GOROman/m5stamp-slic-fxs/DESIGN.md

# M5Stamp 制御 2ポート疑似交換機基板 設計書

**プロジェクト名**: SLIC2PORT-FXS（仮称）
**目的**: FAX機（Canon MX923）と PC の FAXモデム（または2台目の FAX/電話機）を、公衆回線なしで直接 T.30 通信させるためのローカル交換機基板。
**版**: v0.2（2026-10-31、設計フェーズ。発注・製造はしていない）
**v0.2 変更点**: 音声クロス接続を CD4053B から G5V-2 リレー方式へ変更（§5.4）、テストポイントを 34 点に増設（§5.6）、秋葉原調達に合わせた代替反映（1N4007 / BK2125HS601-T、§7）。**配置済み基板データ（v2）は v0.1 設計のものなので、製造前に再生成が必要**

---

## 1. 概要

ユーザーが所有する SLIC モジュール **KS0835F（Shenzhen Ring&tone 製、Silvertel AG1171 系 SLIC 搭載）×4個** のうち2個をソケット搭載し、**M5StampS3（ESP32-S3）** が回線制御を行う 2ポート FXS 基板を設計する。

各ポートは独立した加入者回線として振る舞う:

- 回線電圧（バッテリフィード）の供給
- 呼び出し信号（リング）の送出とリングトリップ検出
- オフフック/オンフック検出（SHK）
- 4W 音声（VX/VR）のアナログクロス接続
- ダイヤルトーン等の可聴信号は M5Stamp 側で生成して注入

ポートAに MX923、ポートBに PC の FAXモデムを RJ11 で挿すだけで、MX923 の「外線発信」がモデム側を呼び出し、応答後は T.30 ハンドシェイク（CNG/CED〜V.17/V.29/V.34）がそのまま通る。逆方向（モデムの ATD 発信 → MX923 自動受信）も対称に動作する。

### 1.1 ブロック図

```
                         +5V (USB-C / 端子台, 5V/3A想定)
                           │
              ┌────────────┴────────────┐ リバース保護(P-FET)+ポリヒューズ+TVS
              │
        ┌─────┴───────────────────────────────────────────┐
        │                  本基板                          │
        │                                                  │
 RJ11-A │  保護回路   ┌──────────┐   音声クロス接続        │
 ───────┼──(P3100SC,  │ KS0835F  │   ┌───────────────┐    │
  TIP/  │   ブリッジ+  │  MOD_A   │   │  G5V-2       │    │
  RING  │   82Vツェナ, └──┬───┬──┘   │  リレー x2     │    │
        │   27K CLI)      │   │ VX_A─┼──►(相手VR/ﾄｰﾝ選択) │    │
        │                 │   └─VR_A─┼──◄(相手VX or ﾄｰﾝ)   │    │
        │              SHK_A F/R_A RM_A│               │    │
        │                 │   │   │  └──────┬────────┘    │
        │   ┌─────────────┴───┴───┴───────┴───────┐     │
        │   │  74HCT244 レベル変換 (3.3V→5V系)     │     │
        │   │  SHKは抵抗分圧で 5V→3.3V            │     │
        │   └──────────────┬──────────────────────┘     │
        │   ┌──────────────┴──────────────────────┐     │
        │   │  M5StampS3 (ESP32-S3)               │     │
        │   │  ・状態機械（発信/呼出/接続/解放）    │     │
        │   │  ・ADC×2: 音声モニタ + DTMF (Goertzel)│     │
        │   │  ・LEDC PWM 400Hz → RC → トーンバス  │     │
        │   └──────────────┬──────────────────────┘     │
        │   （ポートB側も対称に同一構成）              │
 RJ11-B │  保護回路   ┌──────────┐                       │
 ───────┼──(同上)     │ KS0835F  │                       │
        │             │  MOD_B   │                       │
        │             └──────────┘                       │
        └────────────────────────────────────────────────┘
```

### 1.2 設計上の要点（先に結論）

1. **モジュール電源は +5V** とし、ロジックレベル変換を入れる。理由: AG1171 系は +5V 給電時、制御入力 F/R・RM の VIH = 3.5V で ESP32 の 3.3V 出力では不足し、SHK 出力は VOH ≈ 4.5V で ESP32 に直接入れられない（データシート DC 特性より）。→ 出力側は 74HCT244（HCT 入力は VIH=2.0V で 3.3V CMOS を受け、5V フルスイング出力）、入力側（SHK）は抵抗分圧で受ける。
2. **音声は常時ハードワイヤせず、小型信号リレー（Omron G5V-2）で「相手の VX」か「トーンバス」かをポート毎に切替える**。これにより発信直後のダイヤルトーン送出と、接続後のクロス接続を両立する。通話路をリレー接点で切り替える方式は秋月電子の簡易擬似電話交換機キット（リレー＋トランジスタドライバで通話路・極性反転・ベル挿入を切替）と同じ考え方で、当初案の CD4053B アナログ MUX から変更した（v0.2）。接点は無電源時 NC=クロス接続になるフェイルセーフ構成で、ON 抵抗・レベルシフト・バイアス電流の心配もない。
3. **保護回路は KS0835F データシートの Typical Connection Diagram をそのまま採用**（P3100SC + 1N4004 ブリッジ + BZT03C82 + CLI 用 27K）。独自回路にしない。
4. **公衆回線（PSTN/NTT 回線）には絶対に接続しない**。本基板は閉じたローカル回線専用。

---

## 2. 参考資料（出典と、何を参考にしたか）

| # | 資料 | URL / 入手元 | 参考にした内容 |
|---|---|---|---|
| R1 | Silvertel **Ag1171 データシート V1.6**（2011-10） | Mouser 配信 PDF（本フォルダ `research/Ag1171-datasheet.pdf` に保存） | ピン機能、リング生成方法（RM=H + F/R を 20–25Hz トグル）、SHK デバウンス 10ms、PD の扱い（L でパワーダウン、**H にしてはいけない**、未使用時はオープン）、保護回路の部品表（D1=BZT03C82/P6KE82、D2–D5=1N4004 or MB4S ブリッジ、D6=1N4148）、利得 0dB±0.75、ロジックレベル（VIH/VOH）、電源電流、レイアウト指針（±EMI 用 1–10nF、太い電源配線） |
| R2 | Shenzhen Ring&tone **KS0835F データシート V1.3**（2012-09） | GitHub `diggydude/php-pbx` の `docs/KS0835F.pdf`（本フォルダ `research/` に保存） | **モジュール側コネクタのピン配置（11ピン）**、Typical Connection Diagram（保護回路・C2/C3=0.1µF・C5=470µF/10V・PD の 1N4004）、外形/PCB Decal（ピン配置は2クラスタ構成・ドリル 0.9mm）、電気特性（利得 0dB、リング 120–135Vp-p、電源電流） |
| R3 | **diggydude/php-pbx**（GitHub） | https://github.com/diggydude/php-pbx | KS0835F ×8 で電話交換機を作った実在の先行事例。アーキテクチャ（SLIC + アナログスイッチマトリクス MT8808 + トーン生成 + マイコン群で状態管理）、**1回線あたり P3100EBL ×1 + P6KE82 ×1 の保護部品実績**、部品リスト（`docs/requirements.txt`）、動作原理（`docs/principle_of_operation.txt`） |
| R4 | **Blue POT**（Hackaday.io プロジェクト） "A FXS with a SLIC and other historical things" | https://hackaday.io/project/166359-blue-pot/log/165359-a-fxs-with-a-slic-and-other-historical-things | AG1171 で FXS を作った個人プロジェクト。データシート推奨の ESD/EMI 保護を実装した実績、82V ツェナレールへのシャント構成の考え方 |
| R5 | M5Stack 公式ドキュメント **Stamp-S3A PIN2.54** / **Stamp-S3A** | https://docs.m5stack.com/en/core/Stamp-S3A_PIN254 , https://docs.m5stack.com/en/core/Stamp-S3A | M5StampS3A の仕様（ESP32-S3FN8、23 GPIO 一覧、26.0×18.0mm、入力 5V、G0/G46 はストラップピンで注意） |
| R6 | M5Stack 公式 **M5_Hardware**（GitHub）KiCad ライブラリ | https://github.com/m5stack/M5_Hardware （`KiCad/Symbols/M5Stack_Symbols.kicad_sym`、`KiCad/Footprints/M5Stack.pretty/Stamp-S3-SMD.kicad_mod` 等） | M5STAMPS3 シンボルのピン番号↔GPIO 対応表（§5.1）、公式フットプリント（本プロジェクトの `kicad/` に出典明記で同梱） |
| R7 | M5Stack 公式 **Stamp-S3 BreakOut**（SKU:A129） | https://docs.m5stack.com/ja/stamp/Stamp-S3_BreakOut | キャリア基板に EN/G0 のタクトスイッチを置く作法（本基板の RST/BOOT スイッチ配置の参考） |

> 注: R2 の KS0835F データシートはメーカー（R-Tone）公式サイトではなく GitHub 上の保存コピーが入手経路。内容は R1（AG1171）と整合する範囲で採用し、モジュール固有の事項（ピン配置・外形）は R2 を優先した。食い違う場合は実物確認（§10）を正とする。

---

## 3. 前提・仮定と未確定事項

### 3.1 確定として扱う事項（出典あり）

- KS0835F モジュールのインターフェースは **11ピン**（R2 ピン表）:
  1=RING, 2=TIP, 3=F/R, 4=RM, 5=SHK, 6=VR（音声入力）, 7=VX（音声出力）, 8=NC, 9=GND, 10=+VDC, 11=PD。
  ※ 素子単体の AG1171 は 14ピン SIL でピン配置が**異なる**（1=RING, 2=TIP, 3=F/R, 4=RM, 5=SHK, 9=VIN, 10=VOUT, 12=GNDPWR, 13=+VPWR, 14=PD）。**本基板のソケットはモジュール（KS0835F）の 11ピン仕様**であり、AG1171 素子を直接挿すことはできない。
- 音声利得は標準品 KS0835F で **2W→VX 0dB / VR→2W 0dB**（R2 Product Selector）。
- リングは RM=H にして F/R を 20–25Hz でトグル（R1 §3.3 / R2 §1）。リング電圧 120–135Vp-p、呼出中バッテリ 75V。
- SHK はオフフックで H。デバウンス 10ms 必須（R1/R2）。
- PD は L でパワーダウン、**H にすると破損の恐れ**。未使用時はオープン。使う場合はダイオード経由で引き下げる（R1 §3.4、R2 接続図の D7=1N4004）。
- M5StampS3/S3A の GPIO 一覧と公式シンボルのピン対応（R5/R6）。

### 3.2 仮定（実物確認が必要な事項）

| # | 仮定 | 根拠 | 確認方法 |
|---|---|---|---|
| A1 | ユーザー所有の4個は標準品 **KS0835F**（利得 0dB/0dB）である | AliExpress 購入品のマーキング未確認。バリエーションに KS0835F-2（−6dB/+1dB）、-V5（5V専用・低電流）がある（R2） | モジュール表面のマーキングを読む（§10-1）。-2 だった場合: クロス接続のループ利得が −5dB になるが FAX は許容範囲。必要なら §7.4 のパッド抵抗で補正 |
| A2 | モジュールのピン列は **2クラスタ（ピン1–5 と 6–11、クラスタ間ギャップ大）**、ドリル 0.9mm、ピンピッチ 2.54mm | R2 の Package Size / PCB Decal 図。図面数値: 全長 50.2mm、ピン1は右端から 1.5mm、Decal 全長 51.5mm・幅 6.6mm・穴列は端から 2.0mm | 製造前にノギスでピン5–6間距離とピン1位置を実測し、フットプリントのパラメータ `GAP56` を合わせる（§10-2） |
| A3 | モジュールは基板に**垂直に立つ**（SIL 的）実装で、占有ストリップは約 51.5×6.6mm、高さは基板面から約 13–20mm | R2 外形図（側面図でピンが L 字に曲がり、本体が立つ形状） | 実物で高さ・倒れ方向を確認（§10-2） |
| A4 | KS0835F のロジックレベルは AG1171 と同等（5V 給電時 VIH=3.5V、SHK VOH≈4.5V） | R2 にはロジックレベルの明記なし。同一ファミリとして R1 の値で設計（安全側: レベル変換を入れる設計は 3.3V ロジック前提でも壊れない） | 実物で SHK の H レベル電圧を測定（§10-3） |
| A5 | M5StampS3A（現行・S007-V033 系）は Stamp-S3 と同一外形・同一ピン配置で、公式 SMD フットプリントが共用できる | R5 の S3A 製品サイズ 26.0×18.0mm は S3 と同一。M5Stack の S3A ドキュメントの PCB リンクも M5_Hardware の Stamp-S3 系フットプリントを指す | 製造前に S3A の Model Size PDF と実物で端子位置を確認（§10-4） |
| A6 | FAX モデム側は自動応答（例: AT S0=1〜2）設定ができる一般的なアナログ FAX モデム | 一般的な USB/PCI FAX モデムの前提 | 実機接続時に設定確認 |

---

## 4. 電源設計

### 4.1 電源ツリー

```
USB-C (5V) ──┐
             ├─► VIN_RAW ─► F1 ポリヒューズ(2A) ─► Q1 P-FET(逆接保護) ─► +5V
端子台 (5V) ──┘                                                        │
                                          ┌────────────────────────────┼──────────────────┐
                                          │                            │                  │
                                    U1 M5StampS3                 FB_A 経由 +5V_PA    FB_B 経由 +5V_PB
                                    (pin13)                    (MOD_A pin10)        (MOD_B pin10)
                                          │                     各ポート: 470µF/10V + 100nF をモジュール直近に
                                    U1 pin28 の 3.3V ─► +3V3 (軽負荷のみ: ADCバイアス分圧・拡張ヘッダ)
                                    +5V ─分圧(4.7K/4.7K)─► VAUD = 約2.5V (音声バイアス基準, 10µF+100nF)
                                    +3V3 ─分圧(47K/47K)─► VREF165 = 約1.65V (ADCタップのバイアス)
```

- 入力は **5V/3A クラスの AC アダプタ**想定。USB-C は電源専用（CC1/CC2 に 5.1K プルダウンを付け、USB-C 電源から 5V を引く）。端子台（KF301 2P）と並列入力とし、**同時給電は禁止**（どちらか一方。ダイオード OR はしない: 電圧降下と発熱を避けるため）。
- 逆接保護: P-ch MOSFET（AO3401A、D=ヒューズ後の入力、S=保護後の +5V、ゲート 100K で GND プルダウン）によるハイサイド保護。ダイオード方式の 0.3V 降下を避ける（M5Stamp の 5V 入力マージン確保）。
- TVS（SMBJ5.0A）を +5V 入力直後に配置。**SMBJ5.0A は高速サージ用で、モジュール上限以下に抑える過電圧保護ではない**（ブレークダウンは約 6.4V で、5.5V 超過そのものはクランプしない）。絶対最大定格は Ag1171（R1）が VCC 7.0V だが、**KS0835F データシートの絶対最大表は VCC 5.5V** であり、本基板のモジュール上限は 5.5V とする。安定化 5V のみを前提とし、5.5V を超える無調整電源の直結は厳禁であることも基板シルクに明記する。（数値は PR #2 の訂正を取り込み）
- 入力バルク: 1000µF/10V + 100nF。
- ポート毎にフェライトビーズで分岐（DC/DC コンバータのスイッチングノイズのポート間・ロジック側への回り込み防止）。モジュール直近に 470µF/10V（R2 接続図 C5）+ 100nF（同 C4）。
- GND は入力部を起点とするスター接続とし、モジュール pin9（DC/DC グラウンド）は太く短く入力側へ戻す。音声系 GND はロジック GND と同電位（単一 GND プレーン、ただしレイアウトで帰路を分離。§9 参照）。

### 4.2 電源バジェット（+5V 給電時、R2 の最大値で見積り）

| 負荷 | オンフック | オフフック（通話） | リング送出中 | 備考 |
|---|---|---|---|---|
| KS0835F ×1 | 50 mA | 320 mA | 220 mA | R2 DC特性の最大側。標準品（非 -V5）想定 |
| 〃 ×2 同時 | 100 mA | 640 mA | — | 両ポート通話時が持续最大 |
| 片ポート リング + 片ポート通話 | — | — | 220 + 320 = 540 mA | 呼出フェーズ |
| M5StampS3 | — | 160 mA typ / 600 mA peak | — | Wi-Fi 送信ピークを含む概算 |
| 74HCT244 + LED 等 | — | 35 mA | — | §5.7 のステータス LED ×6（約2mA/点）を含む |
| 音声リレー K1/K2 コイル | 0 | 100 mA/個（励磁時） | 最大 200 mA（両励磁時） | G5V-2 DC5 コイル 50Ω。トーン送出中のみ励磁 |
| **合計（設計値）** | 約 0.3 A | **約 1.3 A** | 約 1.2 A | → **5V/3A アダプタ、ヒューズ 2A ホールド** |

リングトリップ瞬間など短時間ピークは各ポートの 470µF と入力バルクで吸収する。

### 4.3 ロジックレベル変換（重要）

AG1171 系を +5V で使う場合の不整合（R1 DC特性）:

| 信号 | SLIC 側（5V給電） | ESP32-S3 側 | 対策 |
|---|---|---|---|
| F/R, RM 入力 | VIH = 3.5V min | VOH = 3.3V max → **不足** | 74HCT244 経由で 5V フルスイング駆動 |
| SHK 出力 | VOH ≈ 4.5V | VIN max 3.6V → **過電圧** | 10K/18K 分圧（5.0V→3.21V、4.5V→2.89V）+ 1nF |
| PD 入力 | H 禁止 / オープン or L | — | 1N4004 経由でのみ引き下げ（§5.3） |
| リレードライバ (2N7002) ゲート | Vgs(th) max 2.5V、駆動は 5V フルスイング要 | 同上 | SEL 信号も 74HCT244 経由で 5V 化してからゲートへ |

代替案として「モジュールを +3.3V 給電にする」方法もある（VIH=2.0V、SHK VOH=2.8V で直接接続可）。しかし (1) オフフック電流が増える（〜320mA@3.3V/ポート相当の電力増）、(2) 大電流 3.3V レールを別途用意する必要がある、(3) php-pbx の実績が +5V 運用、の3点から不採用とした。

---

## 5. ポート回路（ポートA/B 共通 ×2）

記法: `x` はポート記号 A/B。信号名は SKiDL ソース（`kicad/skidl/m5stamp_slic2port.py`）のネット名と一致させてある。

### 5.1 回線側（RJ11 〜 モジュール TIP/RING）

| ネット | 接続 |
|---|---|
| `TIP_x` | RJ11 pin4 ←→ KS0835F pin2 (TIP)。直結（保護素子はすべてシャント接続） |
| `RING_x` | RJ11 pin3 ←→ KS0835F pin1 (RING)。直結 |
| （RJ11 pin1,2,5,6） | NC。6P6C ジャックを使用し中央ペア（3,4）のみ使用。日本の 6極2芯コードも中央ペアなのでそのまま挿せる |

> RJ11 のピン対応（pin3=RING 側、pin4=TIP 側）は R2 の Typical Connection Diagram の配線（モジュール pin1→J1-3、pin2→J1-4）に倣った。
>
> **RJ11 ジャックの正式決定（2026-10-31, 基板 v3.4.2）**: ジャックは **秋月電子 100954（Neltron 7002-6P6C、サイドエントリ基板用、¥50）** を指定部品とする。フットプリントはメーカー図面 `research/neltron-7002-XPXC.pdf`（秋月商品ページ掲載の Neltron 公式図面、SHA-256 90992b2a…060079）で是正した。図面寸法: 端子は **千鳥2列**（接点ピッチ 1.02mm TYP、列間隔 2.54mm）、推奨穴径 **ø0.90**、位置決めペグ **ø2.30 ×2（ピッチ 12.00mm = Dim.C）**、開口面から ペグ中心 6.00mm / 近列（pin2,4,6）8.10mm / 遠列（pin1,3,5）10.64mm、本体 幅12.20（フランジ付きは Dim.D 14.20）× 奥行15.00 × 高さ14.35±0.25mm。pin1 は下面図の "Pin 1" 指示により **遠列**（開口から遠い列）。従来の単列1.27mmピッチ前提（Issue #6 の仕様）は本決定で置き換える。実物での最終確認（秋月 100954 現物または同型サンプルでの嵌合確認）は未実施で、発注前の残件とする。FAX/モデムの DAA は通常極性不感だが、着信時の極性反転検出を使う機器のためにもこの対応を守る。モジュールの F/R=H（Forward）で RING 側が TIP に対して負電位になる（R1/R2）。

保護・付随回路（すべて R1/R2 の指定部品・構成）:

| 部品 | 値/型番 | 接続 | 役割 |
|---|---|---|---|
| D_THY_x | P3100SC（Littelfuse 表記では SMC）または P3100EBL（TO-92） | TIP_x 〜 RING_x 間 | 差動サージのクローバー。P3100 の VDRM は 275V、ブレークオーバ VS は 350V（「約155V」ではない）。リング 135Vp-p では動作しない。82V ツェナの方が先にクランプするので、350V 未満のサージはツェナ側が受け持つ。部品番号は R2 接続図の指定のまま |
| BR_x | 1N4004 ×4（または MB4S ブリッジ） | AC 端子 = TIP_x/RING_x、+側レール = BRP_x、−側 = GND 直結 | サージを極性無関係にクランプ側へ誘導（データシート図の GND 基準構成） |
| D_Z_x | BZT03C82 または P6KE82 | カソード = BRP_x、アノード = GND | 回線の正サージを BRP レール経由で対 GND 約 +82V にクランプ。負サージはブリッジ −側 (アノード = GND) 経由で約 −0.7V にクランプ (R1 Fig.4 / R2 接続図の GND 基準構成そのまま)。通常動作では導通しない |
| R_CLI_x | 27K（指定範囲 20K–39K） | TIP_x 〜 RING_x 間 | オンフック時の DC 経路（CLI/オンフック伝送用、R1 §3.10 / R2 接続図 R1） |
| C_EMI_x1/x2 | 10nF / 250V（フィルム） | TIP_x→GND、RING_x→GND | DC/DC ノイズの EMI 抑制（R1 §6/図5、1–10nF）。※回線の対 GND 範囲は通常時 0〜+75V・差動最大 135Vp-p で、250V 耐圧はサージ/差動マージンとして確保する (旧文書の「対 GND −113V ピーク」は負電源前提の誤りで、メーカー保護回路の GND 基準クランプ (+82V/−0.7V) と矛盾するため v3.4.1 で訂正) |

### 5.2 モジュール制御・電源

| モジュール pin | ネット | 接続先 |
|---|---|---|
| 3 F/R | `FR_x_5V` | 74HCT244 出力。アイドル = H（Forward）。リング中は 20Hz トグル |
| 4 RM | `RM_x_5V` | 74HCT244 出力。リングバースト中のみ H |
| 5 SHK | `SHK_x_RAW` | 分圧（10K 直列 + 18K プルダウン + 1nF）→ `SHK_x_33` → ESP GPIO |
| 9 GND | GND | スターグラウンドへ太く |
| 10 +VDC | `+5V_Px` | フェライトビーズ経由 +5V。直近に 470µF/10V + 100nF |
| 11 PD | `PD_x` | §5.3 |
| 8 NC | — | 無接続（基板側も孤立パッドのみ） |

### 5.3 PD の扱い

- デフォルトは**オープン**（モジュール常時起動）。PD ノードは「敏感なノード・配線は短く」（R1）。
- 任意で引き下げられるよう: `PD_x` → 1N4004（アノード = モジュール側、カソード = 共通 `PD_BUS`）→ 2N7002（ドレイン = PD_BUS、ソース = GND、ゲート = GPIO15 `PD_EN` + 100K プルダウン）。
- ダイオードがあるため、PD_BUS 側が何をしてもモジュール PD ピンに H が印加されることはない（R1 の指定どおり）。
- パワーダウン運用時は SHK が無効になるため、復帰検出には 50ms 起動を伴うポーリングが必要（R1 §3.4）。v1 ファームウェアでは PD は使わない（常時 ON）。回路だけ用意する。

### 5.4 音声系（4W クロス接続 + トーン注入 + モニタ）

| ノード | 接続・定数 |
|---|---|
| `VX_x_PIN` | モジュール pin7 (VX)。C_VX_x = 100nF（R2 接続図 C3）経由で `VX_x_AUD` へ |
| `VX_x_AUD` | 100K で VAUD（2.5V）へバイアス。→ リレーの相手側 NC 接点へ。→ ADC タップへ |
| ADC タップ | `VX_x_AUD` → 100nF → `MON_x`（100K で VREF165=1.65V へバイアス、直列 10K 保護、1nF RF 除去）→ ESP ADC1 |
| `VR_x_IN` | リレー COM 出力。100K で VAUD へバイアス。C_VR_x = 100nF（R2 接続図 C2）経由でモジュール pin6 (VR) へ |
| トーンバス `TONE_BUS` | §5.5。両リレーの NO 接点へ共通接続。100K で VAUD バイアス。RC 出力との間に 100nF を直列に入れて DC を遮断 |

音声クロス接続リレーの割当て（K1/K2、Omron G5V-2 DC5、DPDT。端子番号はデータシート bottom view 準拠: コイル 1/16、極1 COM=4/NC=6/NO=8、極2 COM=13/NC=11/NO=9）:

| リレー | NC（SEL=L、無励磁） | NO（SEL=H、励磁） | COM | 駆動 |
|---|---|---|-----|---|
| K1（ポートA 用） | `VX_B_IN` | `TONE_BUS` | `VR_A_IN` | `SEL_A_5V`（GPIO13 → HCT）→ 2N7002 (Q3) ローサイド |
| K2（ポートB 用） | `VX_A_IN` | `TONE_BUS` | `VR_B_IN` | `SEL_B_5V`（GPIO14 → HCT）→ 2N7002 (Q4) ローサイド |

- 2 極（極1/極2）は同一ネットに並列接続する。接点抵抗は G5V-2 で 50mΩ max（並列で実効半分）、CD4053 の ON 抵抗（約125Ω typ）より遥かに小さく、バイアス電流（100K 経由で最大 25µA 程度）による DC オフセットも無視できる。クロスバツイン接点で微小信号の信頼性も高い。
- コイル: 50Ω / 100mA @5V を +5V レールから 2N7002 でローサイド駆動（秋月キットの 2SC2712 ドライバと同じ方式）。還流ダイオード 1N4007 をコイルに並列、ゲートには 100K プルダウン。励磁はトーン送出中のみで、両リレー同時励磁の最大でも 200mA（§4.2）。
- SEL=L（既定・起動時・電源断）= 相手の VX（クロス接続）、SEL=H = トーン。無励磁がクロス接続なのでフェイルセーフ側に倒れる。HCT の7本の使用入力にそれぞれ100Kプルダウンを置き、ESP32のリセット・書き込み中も RM/SEL/TONE/F/R を L に確定する。ファーム起動後は F/R=H とする。**ファームウェアの SEL 意味論は CD4053 版と同一で変更不要**。
- 切替時間: 動作 7ms max / 復帰 3ms max、バウンス平均 0.5ms（動作時）。切替瞬間に数 ms の無音とクリックが生じるが、通話状態の遷移時（発信・応答・切断）にしか切り替えないため FAX ハンドシェイクへの影響はない。リングトリップ検出後の接続切替はファーム側で数十 ms 待ってから音声を通すこと。
- 旧 CD4053 の Z チャネル（`AUX_TP` モニタ、SEL_Z ジャンパ）は廃止した。§5.6 の TP 増設で `VX_x_AUD` 等を直接測れるため不要になった（TP3 は `TONE_BUS` に割当変更）。
- レベル設計: SLIC の利得は両方向 0dB なので、クロス接続ループの利得は 0dB（公称レベルをそのまま中継）。VR 入力側・VX 出力側とも AC 結合のみで DC レベルの自由度があるため、バイアスは基板側で VAUD に統一した。
- エコー/ハウリング: 各 SLIC のハイブリッド変換損失（4W リターンロス typ 30dB、R2）がそのままトランスハイブリッド損失になる。FAX は半二重系（V.21/V.27ter/V.29）と V.34（自身がエコーキャンセラを持つ）であり、この構成で問題になりにくい。音声通話用途では相手側ハイブリッド漏れによる弱いサイドトーン/エコーが残る（制限事項として §11 に記載）。
- レベルが熱い場合に備え、クロスパス（VX_x_AUD → リレー NC 接点）の手前に 0Ω 抵抗のフットプリントを直列に入れ、パッド（例: 1K〜10K と分圧）に差し替え可能にしてある（SKiDL 上は 0R として実装、初期値 0Ω）。

### 5.5 トーン生成（ダイヤルトーン等）

- ESP32-S3 の LEDC で 400Hz 矩形波（GPIO6）を生成 → 74HCT244 で5V化 → 2段RCローパス（10K + 47nF ×2）→ 100nF直列AC結合 → 47K → `TONE_BUS`。バスを100KでVAUDへバイアスする。元の100nF並列シャントは400Hzも減衰し、フィルタからのDC経路もバイアスを崩すため、直列結合へ変更した。
- 5V/50%矩形波の基本波は約2.25Vrms。VAUDをACグラウンド、VR入力60K（R1）、VRバイアス100K、バスバイアス100KとしてRC段間の負荷を含めた線形計算では、片ポートへの注入時はバス上約0.22Vrms（600Ω換算約−11dBm）。これは計算値であり実測ではない。モジュール差・接点抵抗・両ポート負荷を含む最終値は実機で測定し R11（47K）で調整する。
- 生成するトーン（ファームウェア側、§8 と対応）: ダイヤルトーン 400Hz 連続 / 呼出音（リングバック）400Hz 1秒ON・2秒OFF（リングと同期）/ 話中音 400Hz 0.25秒ON・0.25秒OFF。
- FAX の CNG（1100Hz）/ CED（2100Hz）は端末同士がクロス接続越しに直接やり取りするため、本基板は生成しない。

---

### 5.6 テストポイント（TP1〜TP34）

デバッグ優先で主要信号を全て 1pin テストポイント（ピンヘッダ兼用ランド）で引き出す。**TP4/TP5/TP12/TP13（TIP/RING）は回線高電圧（リング時 最大約135Vp-p）が現れる**ため、基板シルクに高電圧注意マークを入れ、測定時は通常のロジック用プローブ感覚で触らないこと。

| TP | 信号 | TP | 信号 | TP | 信号 |
|----|---|----|---|----|---|
| TP1 | +5V | TP13 | RING_B | TP25 | TONE_5V |
| TP2 | GND | TP14 | FR_B_5V | TP26 | TONE_AC |
| TP3 | TONE_BUS | TP15 | RM_B_5V | TP27 | SEL_A_5V |
| TP4 | TIP_A | TP16 | SHK_B_RAW | TP28 | SEL_B_5V |
| TP5 | RING_A | TP17 | VX_B_PIN | TP29 | MON_A（ADC） |
| TP6 | FR_A_5V | TP18 | VR_B_PIN | TP30 | MON_B（ADC） |
| TP7 | RM_A_5V | TP19 | VX_B_AUD | TP31 | PD_A |
| TP8 | SHK_A_RAW | TP20 | VIN_RAW（USB/端子台側） | TP32 | PD_B |
| TP9 | VX_A_PIN | TP21 | VIN_F（ポリヒューズ後段） | TP33 | VR_A_IN（リレー COM） |
| TP10 | VR_A_PIN | TP22 | VAUD | TP34 | VR_B_IN（リレー COM） |
| TP11 | VX_A_AUD | TP23 | VREF165 | | |
| TP12 | TIP_B | TP24 | GND（追加） | | |

- `VX_x_PIN` はモジュール VX ピン直近（結合コンデンサ前）、`VX_x_AUD` は結合後・VAUD バイアス後（リレー NC への入力）。`VR_x_PIN` はモジュール VR ピン直近、`VR_x_IN` はリレー COM 側。リレー切替の前後を分けて測れる。
- ポリヒューズ前後（TP20/TP21）と逆接保護後段の +5V（TP1）で電源系の切り分けができる。

### 5.7 動作チェック用ステータス LED（D4〜D9）

通電したまま各ポートの状態を目視確認するためのハードウェア連動表示。ファームウェアは変更しない。既存の D2（電源）/ D3（GPIO4 ステータス）とは別系統で、シルクに HOOK_x / RING_x / LINK_x の役割ラベルを付ける。

| LED | 色 | 役割 | 駆動元 | 点灯条件 |
|-----|----|---|---|---|
| D4 / D7 | 緑 | HOOK_A / HOOK_B（オフフック） | SHK_x_RAW → 2N7002（Q5/Q6）バッファ | SHK=H（オフフック） |
| D5 / D8 | 黄 | RING_A / RING_B（リンギング） | RM_x_5V（74HCT244 出力）から直接 | RM=H（リング送出中） |
| D6 / D9 | 青 | LINK_A / LINK_B（リレー励磁） | SEL_x_5V（コイル駆動ライン）から直接 | SEL=H（リレー励磁・トーンバス選択中） |

- SHK は Ag1171 の仕様上 100µA max 出力（3.3K 内蔵プルアップ）しかないため直接駆動せず、2N7002 でバッファする。ゲートの DC 経路は既存の SHK 分圧（10K/18K）が兼ねる。点灯経路は +5V_Px → 抵抗 → LED → FET → GND。
- RING / LINK は 74HCT244 の出力定格（±6mA）に対し約2mA の直接駆動。LED は 0805 高効率品想定で、電流はいずれも約2mA（抵抗は HOOK/RING が 1.5K、LINK が 1K。青は Vf が高いため小さめ）。
- LINK は「リレー励磁中」の表示である点に注意：通話中のクロス接続は SEL=L（無励磁・NC 接点）なので、その間 LINK は消灯する。点灯するのはダイヤルトーン送出中と、発信側への呼出音（リングバック）送出中。

## 6. M5StampS3 GPIO 割り当て

### 6.1 公式シンボルのピン対応（R6、M5STAMPS3 シンボルより）

| 物理pin | 名称（抜粋） | 物理pin | 名称（抜粋） |
|---|---|---|---|
| 1 | GPIO1 (ADC1_CH0) | 15 | GPIO13 |
| 2 | GPIO2 (ADC1_CH1) | 16 | GPIO14 |
| 3 | GPIO3 ※ストラップ | 17 | GPIO15 |
| 4 | GPIO4 | 18 | GND |
| 5 | GPIO5 | 19 | GPIO39 |
| 6 | GPIO6 | 20 | GPIO0 ※ボタン/ストラップ |
| 7 | GPIO7 | 21 | GPIO40 |
| 8 | GPIO8 | 22 | EN |
| 9 | GPIO9 | 23 | GPIO41 |
| 10 | GPIO10 | 24 | GPIO44 (RXD) |
| 11 | GND | 25 | GPIO42 |
| 12 | GPIO11 | 26 | GPIO43 (TXD) |
| 13 | 5V 入力 | 27 | GPIO46 ※ストラップ |
| 14 | GPIO12 | 28 | 3V3 出力 |

フットプリントは公式 `Stamp-S3-SMD`（全28ピン + 付随 GND パッド 29–31）を採用する（**PIN2.54 バリアント専用の 15ピン DIP フットプリントでは GPIO が足りない**ため、ベアモジュール（Stamp-S3 / Stamp-S3A、SMT 実装）を対象とする。29–31 番パッドはモジュール側の GND 系パッドとみなし、ネットリスト取込後に GND へ割当てること。詳細は `kicad/README_CAD.md`）。

### 6.2 本基板での割当て

| GPIO | 物理pin | 信号 | 方向 | 用途 |
|---|---|---|---|---|
| GPIO1 | 1 | `MON_A` | ADC入力 (ADC1_CH0) | ポートA 音声モニタ/DTMF |
| GPIO2 | 2 | `MON_B` | ADC入力 (ADC1_CH1) | ポートB 音声モニタ/DTMF |
| GPIO6 | 6 | `TONE_PWM_33` | 出力 (LEDC) | 400Hz トーン生成 |
| GPIO7 | 7 | `SHK_A_33` | 入力 | ポートA フック検出（分圧済） |
| GPIO8 | 8 | `RM_A_33` | 出力 | ポートA リングモード → HCT |
| GPIO9 | 9 | `FR_A_33` | 出力 | ポートA 極性/リングトグル → HCT |
| GPIO10 | 10 | `SHK_B_33` | 入力 | ポートB フック検出 |
| GPIO11 | 12 | `RM_B_33` | 出力 | ポートB リングモード → HCT |
| GPIO12 | 14 | `FR_B_33` | 出力 | ポートB 極性/リングトグル → HCT |
| GPIO13 | 15 | `SEL_A_33` | 出力 | ポートA 音声ソース選択 → HCT |
| GPIO14 | 16 | `SEL_B_33` | 出力 | ポートB 音声ソース選択 → HCT |
| GPIO15 | 17 | `PD_EN` | 出力 (OD想定) | PD 引き下げ（2N7002 ゲート、既定 OFF） |
| GPIO4 | 4 | `LED_ST` | 出力 | 基板ステータス LED（拡張ヘッダと共用） |
| GPIO0 | 20 | BOOT | 入力 | 基板タクトSW（モジュール上のボタンと並列） |
| EN | 22 | RST | — | 基板タクトSW + 10K プルアップ（3.3V） |
| GPIO43/44 | 26/24 | UART TX/RX | — | デバッグ用 4ピンヘッダへ |
| GPIO3,5,39,40,41,42,46 | 3,5,19,21,23,25,27 | `SPARE_*` | — | 拡張ヘッダ（2×5）へ。GPIO39/40 は I2C 候補（ESP32-S3 は任意ピンへマッピング可）、GPIO3/46 はストラップのため起動時状態に注意 |

ADC は ADC1（GPIO1/2）のみ使用（ADC2 は Wi-Fi と競合するため不使用）。DTMF 検出は発信側ポートの MON を 8kHz サンプリング + Goertzel で行う。

---

## 7. 部品表（BOM 要約）

全量は `bom.csv` を参照。単価は未記載（発注しない前提のため概算列のみ）。

| 区分 | 主な部品 | 数量 | 備考 |
|---|---|---|---|
| U1 | M5StampS3 または M5StampS3A（ベアモジュール、ユーザ調達） | 1 | 公式 SMD フットプリント |
| MOD_A/B | KS0835F モジュール（ユーザ所有品） | 2 | 11ピン ソケット（ピンヘッダソケット 5+6 に分割実装、または一列ソケットを切断） |
| U2 | 74HCT244 (SOIC-20) | 1 | レベル変換。未使用入力は GND へ |
| K1/K2 | G5V-2 DC5 リレー (DPDT) | 2 | 音声クロス接続（§5.4）。マルツで取扱い |
| TP | テストポイント 1pin | 34 | §5.6。TIP/RING は高電圧注意シルク必須 |
| Q1 | AO3401A (SOT-23) | 1 | 逆接保護 P-FET |
| Q2 | 2N7002 (SOT-23) | 1 | PD 引き下げ |
| Q3/Q4 | 2N7002 (SOT-23) | 2 | リレードライバ（Q5/Q6 の HOOK LED バッファ・Q2 と合わせて 2N7002 は計5） |
| F1 | ポリヒューズ 1812, ホールド 2A | 1 | 例: Littelfuse 1812L200 |
| D_TVS | SMBJ5.0A (SMB) | 1 | 5V 入力保護 |
| 保護/ポート | P3100SC（SMC）or P3100EBL、BZT03C82（SOD-57）or P6KE82、1N4007 ×4（ブリッジ。指定 1N4004 の上位互換として調達）、27K、10nF/250V ×2 | ×2式 | R1/R2 指定 |
| 電源系 | 470µF/10V ×2（ポート）、1000µF/10V（入力）、フェライトビーズ 600Ω@100MHz ×2、100nF 群 | — | |
| 音声系 | 100nF ×6（VX/VR 結合・タップ）、10K/47K/100K 等の抵抗群、4.7K×2（VAUD）、47K×2（VREF165） | — | 0805 想定 |
| コネクタ | RJ11 6P6C PCB ジャック ×2、USB-C 電源専用レセプタクル、KF301-2P 端子台、ピンヘッダ（拡張 2×5、デバッグ 1×4、テストポイント） | — | RJ11 は秋月 100954（Neltron 7002-6P6C）を指定し、フットプリントはメーカー図面で是正済み（v3.4.2）。実物での嵌合確認は発注前の残件 |
| その他 | タクトSW ×2（RST/BOOT）、LED ×8（電源/ステータス + §5.7 動作チェック用 ×6）+ 抵抗、M3 取付穴 ×4 | — | |

---

## 8. 動作シーケンス

状態機械の実装は `firmware/m5stamp_fxs_exchange.ino`。要点:

### 8.1 基本フロー（A → B 発信。B → A も対称）

```
待機: 両ポート オンフック監視 (SHK を 10ms デバウンスでポーリング)
  │
  ├─ A オフフック検出
  │    → SEL_A = トーン、ダイヤルトーン送出開始
  │    → DTMF 受付ウィンドウ: MON_A を Goertzel で監視
  │       ・数字を受けた: 最後の数字から 2.5 秒無音で確定
  │       ・6 秒間 数字なし: そのまま発信扱い（MX923 の手動送信＝ダイヤルせず
  │         スタートするケースや、モデムのブラインドダイヤルに備える）
  │    → ダイヤルトーン停止
  │
  ├─ B が既にオフフックだった場合 → 即「接続」へ（2ポート専用線的動作）
  │
  ├─ 呼出: B へリング (RM_B=H, F/R_B を 20Hz トグル, 1秒ON/2秒OFF)
  │    同時に A へ呼出音 (400Hz, リングと同期した 1秒ON/2秒OFF)
  │    ・B の SHK がリング中に H に確定 (リングトリップ) → 応答
  │    ・45 秒応答なし → 呼出中止、A へ話中音 最大5秒 → 両ポートのオンフックを待って待機へ
  │    ・A が先にオンフック → 呼出中止 → 両ポートのオンフックを待って待機へ
  │
  ├─ 接続: SEL_A = SEL_B = 相手VX (クロス接続)
  │    → FAX 通信 (CNG/CED〜T.30 は端末間で直接)
  │    → どちらかがオンフック (500ms 確定) → 解放
  │
  └─ 解放: F/R を H 固定 → 15ms 待って RM を L、SEL は相手 VX に戻す → 両ポートのオンフックを待って待機へ
```

### 8.2 ポートB 発信（PC モデム起点）の特記事項

- モデムは通常「ダイヤルトーン検出 → DTMF 発信（ATDT）」を行う。本基板はオフフック直後にダイヤルトーンを返すため、モデムの標準動作でそのまま進む（ATX4 相当）。ブラインドダイヤル（ATX1）でも、6秒ルールで呼出に進む。
- モデムが発信した DTMF は MON_B で受ける。番号の内容は解釈しない（相手は常に他方ポート）。
- MX923 側は FAX 自動受信（呼び出し回数設定 1–2 回想定）で CED を返す。手動受信でも SHK_A の確定で接続される。

### 8.3 リング仕様

- 周波数: **20Hz**（SLIC 側の波形整形が 20–25Hz 前提のため。日本の公衆回線は 16.7Hz 系だが、FAX/モデムの着信検出は一般に広帯域で 20Hz を受理する。本基板は公衆回線ではないので SLIC 仕様を優先した）
- ケイデンス: **1秒 ON / 2秒 OFF**（日本の標準パターン）
- RM は ON バースト中と停止処理の15msだけ H。バースト終了・応答・キャンセル・タイムアウトのすべてで、F/R=H固定 → 15ms待機 → RM=L の順序を守る（R1 §3.3: >10ms、リングトリップ後 <500ms）。待機は停止処理時のみで、次のONバーストは最初の25msをHに保ってからトグルする。
- リングトリップ: SHK の H が10ms継続したら応答とする（R1のpersistence checkに従う）。元の80ms連続H条件はリング中のSHKパルスを取り逃がすため廃止。通常ループは2ms待機、停止処理時は上記の15ms待機。DTMF窓（約26ms）は発信受付中だけ実行する。
- 通話終了・話中音終了後は `EX_WAIT_ONHOOK` で両端のオンフックを待つ。残ったオフフックを新規発信として再呼出ししない。シリアル `a` / `b` は独立した `EX_RING_TEST` で、両端オンフックのまま単体呼出し試験ができる。

### 8.4 DTMF 受信仕様 (Issue #7 で確定)

接続対象 (モデム/FAX) が発する DTMF に対する受信側の要件と検出方式:

| 項目 | 要件 |
|---|---|
| 最短音長 | **40ms** (DTMF の一般仕様値。これ未満の音は検出を保証しない) |
| 最小数字間隔 (ポーズ) | **40ms** (同じ数字の連続入力を区別するために必要) |
| 入力レベル | MON 入力換算で各成分 (行/列) の正規化振幅 **0.15 以上** (ADC フルスケール基準)。実測の検出下限は 0.13 付近で、0.15 でマージンを確保する |
| 周波数 | 標準 8 周波数 (697/770/852/941 Hz × 1209/1336/1477/1633 Hz) |

検出方式: 発信側ポートの MON を 8kHz サンプリングし、205 サンプル (25.6ms)
窓の Goertzel 解析を **64 サンプル (8ms) ホップのスライディング窓** で実行する。
数字の確定は「同一数字の連続 2 窓検出」で、消滅 (無音窓) で再アームする。
従来の重ならない窓 (205 サンプル一括) では 40ms 音が 2 窓に割れて片方が
しきい値 (正規化振幅 0.12) 未満になり、窓位置の 131/205 で取りこぼしていた。
スライディング窓では 40ms 音に対し「窓の 60% 以上が音に重なる窓」が必ず
4 つ以上連続するため、窓位置に依存せず確定できる。

自動検証: `tests/dtmf_test.cpp` が合成 DTMF をサンプルレベルで実受信経路
(DtmfScanner + DtmfReceiver) に通し、40/70/100ms × 全 205 位相でミス 0、
全 16 数字 @40ms、40ms/40ms の連番・同数字連打、単一周波数・無音の
非検出を確認する。実機 (実 ADC・アナログ回路・対象機器) での検証は未実施。

---

## 9. 基板レイアウト指針

想定: 2層（両面）100×80mm 程度、M3 穴 ×4。

1. **ゾーニング**: 基板一端に回線ゾーン（RJ11 ×2 → 保護 → モジュール ×2 を一直線に）、反対側にロジックゾーン（M5Stamp、HCT、リレー）。音声配線は中央を短く横断。
2. **高圧クリアランス**: 回線系 (TIP/RING/BRP) の対 GND 電圧は通常時 0〜+75V (給電は正電源レールから生成され、Ring が Tip に対して負。R1 §3.2)、サージ時は保護クランプで +82V / −0.7V に制限される。差動は最大 135Vp-p。絶縁距離は対象別に定める (v3.4.1 実測、Issue #9 裁定):
   - 回線系ネットと**無関係なネット** (ロジック/音声/電源) の間: **1.5mm 以上** — 実測最小 1.655mm (C20.1 TIP_B ↔ C17.1 VX_A_AUD) で達成
   - 回線系**内部** (保護ブリッジ/ツェナ/サイリスタ相互、および EMI シャントコンデンサの GND スタブ): 配置密度上 1.5mm を満たせない箇所を例外として許容 — 実測最小 1.35mm。根拠: IPC-2221 の被覆あり外層導体・ピーク 170V 以下の最小間隔 0.6mm を 2 倍以上上回る
   - モジュールの TIP/RING ピン周辺と RJ11 下には GND ポリゴンを入れない（保護素子の GND スタブのみ最短で）
   - ネットクラス (HV = 0.5mm / Power = 0.6mm 配線) は `SLIC2PORT-FXS.kicad_pro` の net_settings に永続化済み (Issue #9)。再インポート時はプロジェクトファイルも一緒に渡すこと
3. **アンテナキープアウト**: M5Stamp のアンテナ端（モジュール端部）は基板端に向け、その周囲 15mm は銅箔・部品・配線を置かない（公式フットプリントのキープアウトに従う）。
4. **電源配線**: +5V 幹線は 0.8mm 以上、モジュール pin10/pin9 への配線は特に太く短く（R1 レイアウト指針）。470µF はモジュール pin10 の直近。DC/DC の帰路電流が音声 GND を横切らないよう、モジュール GND は入力側スター点へ個別に戻す。
5. **PD 配線**: モジュール pin11 〜 ダイオード間は 20mm 以内（敏感ノード、R1）。
6. **音声配線**: VX/VR は DC/DC インダクタ（モジュール上）や +5V 幹線から離し、並走を避ける。ADC タップ配線は短く。
7. **安全表示**: シルクに「ローカル回線専用 / 公衆回線接続禁止 / リング電圧注意（最大約135Vp-p）」を印字する想定。

---

## 10. 実物確認手順（製造前・通電前に必須）

### 10-1. モジュール型名・バリエーション確認
1. モジュール表面の印刷（マーキング）を確認し、`KS0835F` / `KS0835F-2` / `-V5` の別を記録する。
2. -2 の場合: 利得が −6dB/+1dB になる（§3.2 A1 の対処）。-V5 の場合: 5V 専用（本設計は 5V なので適合）、電流は小さくなる。

### 10-2. ピン配置・寸法の実測
1. ピン本数が 11 本で、5本 + 6本の2クラスタになっているか目視確認。
2. ノギスで「ピン1 中心 〜 基板右端相当位置」「ピン5–ピン6 中心間距離」を測る。データシート図の想定: ピン1 はモジュール右端から 1.5mm、ピン5–6 間は約 20.3mm（本設計フットプリントの `GAP56 = 20.3mm`）。
3. ズレが 0.5mm を超える場合は `kicad/` のフットプリント生成スクリプトの定数を直して再生成する。
4. モジュールの立つ向き（部品面の方向）と高さを確認し、隣接部品との干渉がないか当てる。

### 10-3. 電気的な同定（テスタ確認）
通電前に、データシートのピン表と実物の対応を以下で裏付ける:
1. **GND（pin9）の同定**: 抵抗レンジで、モジュール上の大きな電解コンデンサのマイナス端子と導通（0Ω 近く）するピンが pin9。
2. **+VDC（pin10）の同定**: 同コンデンサのプラス端子と導通するピンが pin10。pin9 の隣であることも確認。
3. **TIP/RING（pin2/pin1）の同定**: RJ11 側に近い保護素子（サイリスタ/ツェナ）へつながる 2 本。pin9 との間に数百 kΩ〜MΩ（保護・バイアス経路）が見える程度で、0Ω ではないこと。
4. **SHK（pin5）の H レベル**: ベンチで +5V を電流制限付き（最初は100mAリミット）で pin10/pin9 に印加 → オンフック電流が 35–50mA に収まることを確認 → オンフック確認後、電流制限を500mA程度へ上げてから TIP–RING 間に 600Ω〜1KΩ（5W級の試験用抵抗）を挟んでオフフック相当にし、pin5 が約 4.5V（H）になることを確認（A4 の検証）。同時に TIP–RING 間電圧がオフフック相当で下がることも見る。
5. ここで想定と違うピンが見つかったら、**データシートより実物を優先**してフットプリント/ネットを直す。

### 10-4. M5Stamp 実装前確認
1. 使うモジュールが Stamp-S3 か Stamp-S3A か、PIN2.54 付きバリアントではないか（本基板はベアモジュール SMT 実装専用）を確認。
2. 公式 Model Size 図と実物の端子位置を照合（A5）。

---

## 11. 既知の制限・今後の課題

- **公衆回線には接続不可**（技術基準適合外。あくまで閉じた実験回線）。
- 音声用途ではサイドトーンが弱く、遠端エコーが残る場合がある（FAX 用途では実質問題なし見込み）。
- 発信者番号（FSK）送出は未実装。ただしオンフック伝送の経路（R_CLI + VR へのトーン注入）は用意してあるので、将来 ESP32 側で FSK 変調（Bell 202 / V.23）をトーンバスから送る拡張が可能。
- パルスダイヤル（ロータリー電話）は SHK のパルスとして観測可能だが、v1 ファームウェアでは未対応（php-pbx はこの方式で実装している）。
- リング周波数は 20Hz 固定（SLIC の制約）。16.7Hz を厳密に要求する古い電話機では鳴らない可能性がある（FAX/モデムは通常受理）。
- PD（パワーダウン）は回路のみ用意し、v1 では未使用。
- 本設計は部品選定・回路定数まで。基板の製造データ（ガーバー）は未作成（`kicad/README_CAD.md` に到達度を記載）。

---

## 12. 成果物

| ファイル | 内容 |
|---|---|
| `DESIGN.md` | 本書 |
| `bom.csv` | 部品表（RefDes、型番/値、数量、備考） |
| `firmware/m5stamp_fxs_exchange.ino` | M5Stamp 制御スケッチ雛形（状態機械、GPIO 定義は §6.2 と一致） |
| `kicad/skidl/m5stamp_slic2port.py` | SKiDL 回路定義（ネットリスト生成・ERC） |
| `kicad/skidl/m5stamp_slic2port.net` | 生成した KiCad ネットリスト |
| `kicad/M5StampS3.kicad_sym` | M5Stack 公式シンボルから抽出した M5STAMPS3（出典: R6） |
| `kicad/SLIC2PORT.pretty/KS0835F.kicad_mod` | KS0835F フットプリント（R2 Decal より生成、要実測確認） |
| `kicad/SLIC2PORT.pretty/RJ11_6P6C_TH.kicad_mod` | RJ11 6P6C 横型ジャック想定フットプリント（要実物確認） |
| `kicad/README_CAD.md` | CAD 成果物の到達度と使い方 |
| `research/` | 参照したデータシート PDF と抽出テキスト、KS0835F 図面ページ画像 |
