GOROman/m5stamp-slic-fxs/kicad/CAD_REPORT.md

---

## 第7ラウンド (2026-10-31): v3.3 全数監査 → v3.4

ユーザーの目視指摘（「端子台が IC に被っている」「シルクがぐちゃぐちゃ」）を発端に、配置品質だけでなくファームウェア整合・電気的妥当性・ネット健全性・製造性・調達整合・極性まで対象を広げた全数監査を実施し、是正版 v3.4 を作成した。

### 監査方法

- 機械監査: pcbnew でダンプした全 160 フットプリント（156 部品＋取付穴4）・全パッド・全シルクテキスト（216 件）を JSON 化し、(1) 実ボディ寸法（F.Fab 実形状。軸型部品はガラス体寸法、電解は内接円で裁定）による本体干渉、(2) シルクのパッド/本/テキスト被り・端はみ出し・最小寸法、(3) 基板↔SKiDL ネットリスト全 375 パッド照合、(4) ファームウェア GPIO とソケット実ネットの全ピン照合、(5) データシート（Ag1171/KS0835F）との電気照合をスクリプトで実施
- 目視監査: 是正後に表裏 3000px レンダリング＋4 象限クロップ＋C10 周辺クロップを生成し全域を目視

### v3.3 の監査結果（重大度別）

| 度 | 件数 | 内訳 |
|---|---|---|
| 重大 | 52 | 本体干渉 1（J2↔U2）/ 本体-パッド干渉 4 / J2 本体の基板端はみ出し 1 / 環状銅箔 46（RJ11 12 + ソケット 28 + その他） |
| 中 | 239 | シルク-パッド被り 84 / シルク-本体被り 102 / シルク同士 53 |
| 小 | 195 | TP プローブ近接 89（列内隣接が大半）/ シルク寸法 80 / J1 端クリアランス 16（設計値 0.33mm）/ その他 |

個別の重大・中項目:

1. **[重大] J2（端子台）本体が U2（74HCT244）のパッド 9〜12 に被る**（重なり 21.85 mm²）。実装不可能。ユーザーの目視指摘どおり
2. **[重大] J2 本体が基板下端から 0.7mm はみ出し**
3. **[重大] RJ11 パッド環状銅箔 0.10mm**（パッド 1.1×1.6 / ドリル 0.9、ピッチ 1.27mm）— JLCPCB 2層1oz の絶対最小 0.18mm 未満（Issue #6）
4. **[重大] Stamp ソケット環状銅箔 0.15mm**（パッド 1.0 / ドリル 0.7）— 同上未満
5. **[中] シルク全般**: J_3/J_4/MOD_A/MOD_B/U1 のリファレンスが非表示、J1 リファレンスが反転＋基板外、取付穴リファレンスが基板外、TP ネットラベルが 0.85mm 高（最小 1.0mm 未満）、警告文が裏面パッド列に被る等、239 件
6. **[中] PD ダイオードの論理レベル**: PD ピンを 1N4007 経由で引き下げると Low が約 0.67V となり、Ag1171 の PD VIL(max) 0.5V を超過。データシート推奨トポロジではあるが紙規格外で、PD 機能が silently に効かない恐れ（現ファームウェアは PD_EN を常時無効のため潜在）
7. **[中] 電源予算**: 最悪約 1.5A（SLIC リング 480mA＋オフフック 400mA※データシート DC 特性、リレー 111mA、Stamp WiFi ピーク約 500mA 等）に対しポリヒューズ保持 2A（40℃ で約 1.7A にディレーティング）。DESIGN の 5V/3A 電源前提とは整合するが、通常の USB 2.0 ポート（500mA）では電圧低下する旨の明記が必要
8. **[小] リレードライバ余裕**: 2N7002 の Rds(on) 最大 7.5Ω（Vgs 5V）→ コイル電圧最悪約 4.0〜4.25V > G5V-2 動作保証 3.75V で適合だが余裕は薄い。実機でコイル電圧を実測推奨

### 電気・整合の検証結果（問題なしを確認したもの）

- **ファームウェア GPIO 全ピン照合: 13 ピン全て一致**（MON_A=GPIO1, MON_B=2, LED=4, TONE=6, SHK_A=7, RM_A=8, FR_A=9, SHK_B=10, RM_B=11, FR_B=12, SEL_A=13, SEL_B=14, PD_EN=15）。基板↔SKiDL ネットリストは 375 パッド中、既知の J1 `S1`↔`SH` 命名差のみ
- U2 (74HCT244) 全 20 ピン実チップピン配置と一致（pin3 2Y4 の意図的 NC、pin17 2A4=GND 含む）。HCT の VOH 約 4.4V > SLIC 制御入力 VIH(min) 3.5V で、3.3V 直結では不足する＝レベル変換の存在理由を確認
- SHK 分圧: SHK_33 = 2.87V > ESP32-S3 VIH 2.475V（余裕 0.40V）。Q5/Q6（HOOK LED バッファ）のゲートは分圧前 4.47V 駆動で適合
- LED 電流は全 9 個を再計算し適合（D2 3.0mA / D3 2.8mA / HOOK 2.0mA / RING 1.9mA / LINK 2.0mA）
- KS0835F 標準接続図との照合: VR/VX 結合 100nF、+VDC バルク 470µF/ポート、CLI バイアス 27K（推奨 20〜39K）、保護ブリッジ＋BZT03C82＋P3100SC の構成すべて一致。**RM 外付けコンデンサは不要**（Ag1171/KS0835F 両資料とも RM は純粋な論理入力）
- ネット健全性: 1ピンだけのネット **ゼロ**。+5V 17 員 / +3V3 5 員 / GND 75 員、全電解コンデンサの＋極は正電源側、全ダイオード（ブリッジ・還流 K=+5V・TVS・PD）の向き適合
- 極性シルク: 電解の「+」印、DO-41 の K マーカー 14 件、LED のカソードブラケット、モジュール 1 番ピン円、RJ11 1 番角パッドは全て判別可。**U2 の 1 番ピンマークのみ不足** → v3.4 で追加

### Issue #4〜#7 の取り込み

- **#6（RJ11 環状銅箔）**: 是正対象として v3.4 で修正（下記）。実ジャック（uxcell、2026-11-01 到着予定）のピン実測で最終ドリルを確認すること。ピン対角が 0.72mm 以下なら ドリル 0.75 で環状 0.21mm にできる
- **#4（PlatformIO/Arduino API 不整合）**: ファームウェアに LEDC 互換シム（core 2.x/3.x 自動切替）を導入し、platformio.ini を `espressif32@7.0.1` にピン留め、CI に実ターゲットビルド job と両分岐のホストコンパイルを追加。ホストテストは両分岐ともパス。実 `pio run -d firmware`（espressif32@7.0.1 / core 2.0.17）も **SUCCESS**（esp32s3 イメージ生成を確認、2026-10-31）
- **#5（単体リング試験後の誤発呼）所見**: コード確認済み。EX_RING_TEST の終了が EX_RINGING 経路と違いフック状態を同期せず toIdle() するため、RING_TRIP_MS(10) < HOOK_DEBOUNCE_MS(15) の条件で受話器を上げた端末をオンフック扱いし、次ループで相手を呼び出してしまう。修正方針: toIdle で rawHook を pending 扱いにするか EX_WAIT_ONHOOK へ遷移。基板の問題ではないため本ラウンドでは所見のみ
- **#7（40ms DTMF 取りこぼし）所見**: DTMF_N=205 @8kHz = 25.6ms 窓＋2 窓連続確認では 40ms トーンは位相により取りこぼす（Issue のホストテストで 131/205）。70ms では 0/205。FAX/電話機の実用 DTMF は 70ms 以上が標準的なため、要求仕様として「最小トーン長 70ms」を明記するのが妥当。基板の問題ではないため所見のみ
- 付随観察: `tests/test_hardware.py` に既存の失敗 2 件（存在しない J7 ジャンパ参照、SKiDL↔保存ネットリストの参照番号ドリフト）。本ラウンドの変更前から失敗しており、基板の正は保存ネットリスト（基板と 375 パッド一致を検証済み）。テスト側の追随は別途

### v3.4 の是正内容

- **部品移動**（確定済み設計判断を維持）: U2 を dy −5.5、C6 を dy −4.7（U2 pin20 への距離は 4.4→約 3.1mm に改善）、K1 を dy −1.2、J2 を dy −1.0（筐体が基板内に収まり U2 と 2.0mm 離隔）。パスコン近接配置・C10 裏面・LED 上端・J1 端クリアランス 0.33mm はすべて不変
- **パッド拡大**: RJ11 全パッド 1.17×1.9mm / ドリル 0.8 → 環状 0.185mm（≥0.18 下限）。隣接パッド間 0.10mm は JLCPCB マスクブリッジ最小値ちょうど（ピッチ制約のトレードオフとして明記）。Stamp ソケット 1.1×1.1 → 環状 0.20mm
- **部品変更**: PD ダイオード U79/U106 を 1N4007 → **1N5819**（ショットキー、DO-41 同一フットプリント）。PD Low は約 0.35V となり VIL 規格内。SKiDL・BOM も同期（1N4007 は 10 個に、1N5819 行を追加）
- **シルク全面再配置**: 制約ソルバで 225 テキスト（全リファレンス 159＋TP ラベル 34＋K マーカー 14＋基板ラベル 11＋新規マーク 3＋警告 4）を、パッド/本体/取付穴頭/他テキストへの干渉ゼロ・基板内・0°/90° の条件で再配置。TP ラベルは 1.0mm 高に拡大、LED ラベル（HOOK/RING/LINK）は 1.0mm 高・線幅 0.15mm に拡大、U2 に 1 番ピンマーク「1」、J2 に「+」「−」を追加、非表示だった 5 部品のリファレンスを表示化。読み捨てになった「M5StampS3 SOCKET」ラベルは U2 移動に伴い配置不能となったため削除（U1 リファレンスで代替）
- **裏面警告文**: 旧 3 行を削除し、h1.8 の 4 行（LOCAL LINE ONLY / DO NOT CONNECT TO PUBLIC / NETWORK (PSTN) - CAUTION / RING VOLTAGE UP TO 135Vp-p）を裏面上部のパッド列のない帯（y 8.0/12.5/19.5/27.2）に再配置。C10 リファレンスはチップ直下の可読位置に確定

### 是正後の再監査（v3.4）

- 合計: **重大 9 / 中 0 / 小 154**（v3.3: 重大 52 / 中 239 / 小 195）
- 重大 9 件は全て解析アーティファクト: C13 本体-パッド 3 件は矩形近似の誤検出で、実缶（Ø8.0）から U2 パッドまでの実測クリアランスは 1.29/1.53/2.02mm（レンダリングでも離隔を目視確認）。残り 6 件は取付穴 H1〜H4 と J1 シェルの NPTH（環状銅箔を持たないのが正）
- 小 154 件の内訳: J1 パッド端クリアランス 0.33mm ×16（設計どおり、≥0.3 適合）、TP 列内隣接 89（4.4mm ピッチ列の固有。TP21 と C13 缶の 0.3mm 近接のみ要注意として既知）、環状銅箔 44（RJ11 0.185 / ソケット・J1 シェル 0.20。下限 0.18 は満たすが推奨 0.25 未満＝ピッチ制約）、マスクブリッジ 4（RJ11 中央ペア 0.100mm＝JLCPCB 最小値）、C10 リファレンスの裏面 180° ×1（裏面から読める向きで正常、レンダリング確認済み）
- ネット形式: 標準の番号付きネット形式を維持（再読み込みで 85 ネット、単一パッドネットなし、主要パッドのネット割当をスポット検証）
- レンダリング目視: 表裏 4 象限＋C10 クロップで、J2↔U2 の分離、全リファレンスの可読性、LED 帯、警告文帯、C10 を確認し残存問題なし

### 成果物

- `SLIC2PORT-FXS-v3.4.kicad_pcb`（本フォルダ、MD5 `893efc23855b230e46f043f112913139`）。リポジトリ `kicad/SLIC2PORT-FXS.kicad_pcb` も同一内容
- レンダリング: リポジトリ `docs/images/board-v34-top.png` / `board-v34-bottom.png`（README プレビュー更新済み）
- 同期済みソース: SKiDL（PD=1N5819）、`gen_footprints.py`＋RJ11/Stamp-Socket フットプリント（パッド拡大）、`bom.csv`（1N5819 行追加、J2 は 5.00mm ピッチ品 WJ301-5.0-02P 明記）
- ファームウェア: Issue #4 修正（LEDC 互換シム、platform ピン留め、CI 追加）
- 残作業: 配線フェーズ（EasyEDA）へは **v3.4** を渡すこと（v3.3 は旧版）。RJ11 実ジャック到着後にピン実測→最終ドリル確定。実機組立時にリレーコイル電圧と PD Low 電圧を実測すること
### 第7ラウンド補記 (2026-10-31, push 時)

- 並行セッションが Issue #6 のライブラリ修正（RJ11 ドリル 0.75 / パッド 1.15×1.70、環状 0.20mm）、#5 修正（リング試験停止時のフック同期）、#7 修正（スライディングウィンドウ DTMF で 40ms 対応）を先行 push していたため rebase して統合した。#5/#7 は本ラウンドの「所見のみ」から「修正済み」に進展
- 基板側 RJ11 パッドもライブラリ寸法に整合（1.15×1.70 / ドリル 0.75 → 環状 0.20mm、隣接ギャップ 0.12mm）。最終基板 MD5 は `893efc23855b230e46f043f112913139`。再監査でも 中 0 を維持（重大 9 は NPTH と C13 矩形近似の裁定済みアーティファクトのみ）
- マージ後のファームウェアで exchange（両 LEDC 分岐）＋ dtmf のホストテスト全パス、実 `pio run` も再検証
- 残件（v3.4 をブロックしない）: RJ11 実ジャック（2026-11-01 到着予定）のピン実測による最終ドリル確認、実機でのリレーコイル電圧・PD Low 電圧の実測、test_hardware.py の既存失敗 2 件の追随、C13↔TP21 の 0.3mm 近接（既知・許容）

## 第8ラウンド (2026-10-31): Issue #9/#11/#12/#13 検証・是正 → 基板 v3.4.1

対象 Issue を最新 main に対して実測検証し、未解消項目を是正した。

### #13 PD ダイオード同期 — 解消 (59ed9d9)
- 保存 .net / BOM / SKiDL / 基板は 1N5819 で一致済みだったが、配置生成用 `kicad/netlist_v32.json` の U79/U106 のみ 1N4007 が残存
- 生成器 `kicad/net2json.py` をリポジトリへ取り込み再生成 (差分は当該2値のみ)。回帰テスト `test_placement_json_matches_netlist` 追加

### #11 U1 ソケット環状銅箔 — 解消済みを確認 (aa0351a)
- ライブラリ・基板とも pad 1.1×1.1 / drill 0.7 = 環状 0.20mm で是正済みだった。生成元に寸法規格コメントを明記 (1.27 ピッチ維持、環状 0.25 は隣接間隔 0.07 となり不可、0.20 が設計点)
- 全 PTH パッド (基板 174 + ライブラリ 28) の環状銅箔 ≥0.18mm を自動検査化、実測最小 0.20mm

### #12 生成元同期 — 解消 (7680649)
- build_pcb_v32.py の旧パス参照を repo 相対化し、v3.4 配置修正 (J1 84.9 / J2 85.0 / U2 −5.5 / K1 −1.2 / C6 −4.7 / C10 43.65) を反映 (SW2/C13 は発行時点で一致済み)
- `kicad/check_regen.py` 追加: 再生成基板と同梱基板で全配置・全パッドネット・値・RJ11/U1 パッド形状を照合 → **エラー0 / 警告0**
- 副次発見: J1 の無番号パッドは NPTH 取付穴で、ネット割当はファイル形式依存の見かけ差 (KiCad は番号形式で NPTH のネットを落とす) と裁定し照合対象外に明記

### #9 v3.3 レビュー指摘 — v3.4.1 で全項目を裁定 (75278df / 8351577 / 3b5e0fd / 7b4771b)
1. **SW1/SW2 間隔 0mm — 未解消だった (最重要)**: SW1 pin1 (EN) と SW2 pin1 (GPIO0) の Ø2.0 パッドが中心間 2.0mm で接触。EasyEDA DRC の 0mil 報告と一致。**SW2 を +1.8mm へ移動し間隔 1.8mm を確保** (基板 v3.4.1)
2. U2/J2 本体干渉: v3.4 で解消済み (再確認)
3. **保護回路の BRM 浮遊 — 未解消だった**: Ag1171 Fig.4 と KS0835F 接続図を原典で再読し、ブリッジ −側アノードとツェナアノードは GND 行きが正と確定 (クランプ +82V/−0.7V の非対称性とも整合)。U58/U59/U60/U85/U86/U87 pin2 を BRM_x → GND へ是正し BRM ネットを廃止、SKiDL/ネットリスト/JSON/基板/DESIGN を同期
4. **HV 間隔・ネットクラス — 裁定のうえ解消**: v3.4.1 実測で「回線系 vs 無関係ネット」最小 1.655mm (1.5mm 方針を達成)、保護系内部は最小 1.35mm を例外許容として DESIGN 9.2 を再定義 (IPC-2221 被覆外層 170V 以下最小 0.6mm の 2 倍超)。`.kicad_pro` の net_settings に Default/HV/Power と割当パターンを永続化し、pcbnew で解決を実証
5. テスト失敗 2 件: 前ラウンドで解消済み (本ラウンドで 12/12 全パスを確認)

### 追加裁定 (EasyEDA 実測との突合)
- **裏面 C10 ↔ U1 TH パッド**: KiCad で銅箔同士を直接実測し 0.250mm 一様 (Default 0.2mm・JLC 最小間隔を満たす)。EasyEDA の 0mil/1.9mil/1.2mil はコートヤード基準の見かけ値 (C10 裏面コートヤードが U1 パッド外形に 0.045mm 重なる) と裁定、基板変更なし
- **RJ11 フットプリント内間隔**: 0.12mm は JLCPCB 最小間隔 約0.127mm を 0.007mm 下回るため、パッド幅 1.15 → **1.13mm** に縮小 (間隔 0.14mm / 環状 0.19mm)。ライブラリ生成元・ビルド後処理・基板を同期

### DRC (KiCad kicad-cli、同条件比較)
- v3.4: 違反 137 件 / v3.4.1: **131 件** (未配線のため未接続 295 件は別枠)。残存は RJ11/U1/USB-C のフットプリント内ピッチ幾何 (全て JLC 最小 0.127mm 以上) と基板端 0.33mm (JLC 要求 0.3mm 適合) が中心。SW 接触相当 (actual 0.0000) は両版とも KiCad DRC では表面化せず、幾何実測で判定した
- なお KiCad DRC では v3.4 でも SW 接触は検出されなかった (接線接触はクリアランス違反として出ない)。検出は EasyEDA DRC と幾何実測による

### v3.4 との差分 (配線フェーズへの影響)
- v3.4.1 は v3.4 と **SW2 位置 (+1.8mm)・保護 6 パッドのネット (BRM→GND)・RJ11 パッド幅** のみが異なる
- **EasyEDA で配線済みの v3.4 データ (b0964c9 の Gerber/epro2) は旧版ベース**。発注前に v3.4.1 を再取り込みして再配線 (少なくとも SW2 周辺と保護クラスタ) が必要
- 成果物: リポジトリ `kicad/SLIC2PORT-FXS.kicad_pcb` (v3.4.1、番号付き標準形式・82 nets)。テスト 12/12 パス、CI 対象の回帰も同梱

## 第9ラウンド (2026-10-31): コンデンサ × IC/モジュール 実ボディ全数再検証 — v3.4.1

ユーザー目視指摘「コンデンサが IC に被っているように見える」を、見かけ (アセンブリ図の円・コートヤード) ではなく実ボディ寸法で切り分けた。

### 方法
- pcbnew で全 160 フットプリントを抽出し、ボディ形状を Fab 図形から構築 (電解缶は Fab 円 = 実缶の円盤、チップ/IC は Fab 輪郭の凸包)。U2 の Fab 本体は 7.500 × 12.800mm でデータシート公称値と一致。MOD_A/MOD_B は Fab が無くシルク輪郭 (50.20 × 6.60mm) を使用。U1 はソケット Fab (18.0 × 24.0mm、実モジュール M5StampS3 は 18.6 × 24.2 で最大 +0.3mm/辺だが最寄り部品まで 4mm 以上あり影響なし)
- 全コンデンサ 28 点 × {U1, U2, MOD_A, MOD_B, K1, K2} の 168 ペア (同一面のみ) のボディ間距離と、コンデンサ × 全他部品・コンデンサ同士の近接 (<1.5mm) を全数計算。あわせて kicad-cli レイトレーシング描画の拡大切り出しと、実寸 2D 寸法図 (docs/images/board-v341-c13-u2-diagram.png) で目視確認

### 結果: 本体同士の重なりは全ペアなし
| ペア | 実測間隔 | 判定 |
|---|---|---|
| C6 ↔ U2 本体 | **+0.365mm** (全ペア最小。公差最悪でも約 +0.24mm) | OK (実装可能。デカップリング近接配置のため意図的に近い) |
| C6 ↔ K1 | +0.995mm | OK |
| C14 ↔ MOD_A | +1.035mm | OK |
| C22 ↔ K1 | +1.310mm | OK |
| C13 缶 ↔ U2 本体 | +1.430mm | OK (**缶は IC 本体には被っていない**) |
| C22 ↔ MOD_B | +1.375mm | OK |
| C23 ↔ MOD_B | +2.070mm | OK |
| C13 ↔ K1 | +2.948mm | OK |
| 裏面 C10 ↔ U1 パッド (裏面) | 本体-パッド +0.700mm (銅箔間は第8ラウンド実測 0.250mm) | OK (拡大図 board-v341-crop-c10-bottom.png) |
| コンデンサ × その他部品 (<1.5mm の 9 ペア) | 最小 C1 ↔ R30 +0.808mm | 全て OK |
| コンデンサ同士 | 1.5mm 未満なし | OK |

### 要修正: C13 の缶が U2 の SMD パッド 1・2 のトウを覆う (第7/8ラウンド裁定の訂正)
- 実測: C13 缶 (中心 (24.275, 65.275)、r=4.0) の輪郭が、U2 パッド1 (GND) の銅箔へ **0.474mm**、パッド2 (FR_A_33) へ **0.124mm** 食い込む (パッド3 は +0.565mm で離隔)。第7ラウンドの「実缶 Ø8.0 から U2 パッドまで 1.29〜2.02mm」は誤りで、本体までの距離 (+1.430mm) と混同していた
- 影響: リフロー後に C13 を挿入すると缶底縁がパッド 1/2 のトウ・フィレットに干渉し得る。ピン足自体 (本体側) には届かないため実装不可能ではないが、ピンの目視検査ができず、缶径公差 (+0.5) では接触が確実になるため要修正と判定
- **是正案 (最小移動)**: C13 を基板座標で **X −1.00mm** へ移動 → U2 パッド最小クリアランス **+0.521mm**、全ボディ間隔の最小は TP21 に対して 1.307mm (現行 1.066mm から改善)。C13 は低周波リザーバで、高周波デカップリングは MOD_A pin 10 脇の C14 が担うため電気的影響は無視できる。移動に伴う再配線は +5V_PA / GND の局所のみ
- 本ラウンドでは基板ファイル自体は変更していない (配線セッションが v3.4.1 を編集中のため)。上記是正は v3.4.2 として配線前に適用すること

### 注記
- C1 (1000µF) のフットプリントは Ø8.0mm 前提。Ø10mm 品 (例: 秋月の 1000µF) を実装すると R30 本体へ −0.19mm 干渉、R28 へ +0.02mm となるため、C1 は Ø8.0mm 品を調達すること (第3ラウンド調達監査の要判断事項の再確認)
- MOD_A/MOD_B フットプリントには 3D モデルが無く、レンダリングでは輪郭とピンのみ表示される。モジュール実体との間隔はシルク輪郭ベースの数値検証が正
- 証拠画像: docs/images/board-v341-c13-u2-diagram.png (実寸寸法図)、board-v341-crop-c13-u2.png (3D 拡大: C13 缶・U2・C6)、board-v341-crop-c10-bottom.png (裏面 C10)

## 第10ラウンド (2026-10-31): RJ11 指定部品是正 (秋月 100954 / Neltron 7002) — v3.4.2

ユーザー決定「RJ11 は秋月 100954 を使う」を受け、フットプリントを実部品のメーカー図面で全面是正した。第9ラウンドが処方した C13 移動も本バージョンへ同時適用した。

### 寸法の入手と照合
- 秋月サイト本体はメンテナンス中だったが、商品ページ掲載のデータシート PDF (Neltron 公式図面 7002-XPXC) を秋月の静的ファイル置き場から直接取得できた (`research/neltron-7002-XPXC.pdf`、SHA-256 90992b2a…060079)
- 図面寸法: 千鳥2列 (接点ピッチ 1.02 TYP、列間隔 2.54)、推奨穴 ø0.90、位置決めペグ NPTH ø2.30 ×2 (ピッチ 12.00 = Dim.C)、開口面からペグ中心 6.00 / 近列 (pin2,4,6) 8.10 / 遠列 (pin1,3,5) 10.64、本体 幅12.20 (フランジ付きは Dim.D 14.20) × 奥行15.00 × 高さ14.35±0.25。側面図の寸法線は画像実測でも再確認した (6.00 / 8.10 / 10.64 一致)
- 従来前提 (単列 1.27mm ピッチ、穴 0.75、本体 13.5×13.5、ペグなし) は **全項目で不一致**。Issue #6 の環状銅箔仕様は「一般的な横型ジャック」の想定だったため、本是正で指定部品の仕様に置き換えた
- pin1 は図面下面図の "Pin 1" 指示で遠列の端 (基板上面・開口を手前に見て右端)。同形状クラスの Honda MOD-J6 図面とも列配置は整合するが、ペグ位置はメーカー差がある (Honda は開口面から 7.0mm、本品は 6.0mm) ため他社図面での代用は不可

### 是正内容
- ライブラリ/生成元 (`gen_footprints.py`): 千鳥配置、穴 ø0.90、パッド ø1.50 (環状銅箔 0.30mm — 絶対最小 0.18 と推奨 0.25 の両方を充足)、ペグ穴 NPTH ø2.30 ×2、本体シルク 12.20×15.00 + コートヤード。間隔の実値: 同列 0.54mm / 列間斜め 1.24mm (最小 0.127 を充足)。生成時アサーションで両条件を保証
- 基板: J_3/J_4 の原点をペグ中心線に変更し y 7.2 → 6.45 (開口面の基板端から 0.45mm は従来どおり維持)。本体奥行が 15.0mm (背面 y=15.45) と旧シルクより 1.5mm 深く保護1列目と干渉するため、干渉する保護部品9点を平行移動で退避 (U56/U84/U85 は2列目へ、C11/C12/R16/C20 は列間の空き帯へ、C21/R24 は2列目の下へ)。退避先はパッド同士 0.8mm 以上で再計算した
- 第9ラウンド処方: C13 を基板座標 X −1.00mm へ移動。U2 パッド1/2 との干渉は −0.474/−0.124mm → **+0.521/+0.799mm** (第9ラウンドの予測値と一致)

### 検証
- `check_regen.py`: 警告0・エラー0 (生成元 `build_pcb_v32.py` と同梱基板が完全一致。round 10 として生成元へ同期済み)
- ネット不変: 84ネット、未接続 295 (配線前) は v3.4.1 と同一。RJ11 の pin3=RING_x / pin4=TIP_x 割り当ても不変
- 物理干渉: ジャック本体矩形 (12.20×15.00) に対する他部品 Fab 本体・パッドの重なり **0件**
- コートヤード新規重なりは J_3 ↔ U55 の1組のみ: 実本体は対角配置で間隔 0.37mm、U55 のパッドはジャック背面より後方 (y ≥ 16.73) にあり干渉しないため裁定 OK
- 回帰テスト: unittest 12件 + C++ (exchange/dtmf、core 3.x 枝含む) 全パス。RJ11 テスト3件は図面座標そのものを照合する形へ更新

### 残件
- 実物確認: 秋月 100954 現物での嵌合・ペグ入り確認は未実施。発注前に現物で最終確認すること (到着予定の uxcell サンプルは別メーカー品のため参考扱い)
- 配線: 本バージョンは未配線。v3.4 の EasyEDA 配線 (v3.4.1 前提) は使えないため、配線は v3.4.2 に対して行うこと。TIP/RING の太線・広間隔ネットクラス未適用の件も配線時の課題として継続

## 第11ラウンド (2026-10-31): 全面再レイアウト + 4層化 + KiCad 配線 — v4.0

ユーザー指示「部品の縦横を配線しやすく並べてよい」「プロのアートワークで」「最高の配線」「4層でもいいよ」を受け、v3.4.2 を起点に配置を全面刷新し、KiCad (10.0.6) + FreeRouting で配線まで完遂した。電気的中身 (回路・ネット・部品構成) は v3.4.2 と完全同一で、最終検証で全 398 パッドの (ref, pad) → net がベースラインと一致することを確認した (差分 0 件)。

### 層構成 (2層 → 4層)
- F.Cu 信号 / In1.Cu GND プレーン (電源層タイプ) / In2.Cu 信号 / B.Cu 信号
- 根拠: 回線保護・SLIC アナログと Stamp の信号が混在する基板で、GND プレーンによるリターン経路の確保と、表裏ベタだけでは分断される GND の一体化。In1 には信号配線を 1 本も通していない (FreeRouting のプレーン指定 + 手配線でも踏襲)。外形 120×90mm・取付穴 4 点は不変

### 配置方針 (フロアプラン)
- 機能ブロック構成: 上段に RJ11 ×2 (左右対称) と LED 群、その下に保護回路バンク (A = 左、B = 右の鏡像)、SLIC モジュールは両端から内向きにピン列を y=36.5 に整列、中央に M5StampS3 ソケット (アンテナ側に銅箔キープアウト)、リレー K1/K2 は同一方向・同一直線に整列し駆動回路 (Q3/Q4・還流ダイオード・プルダウン) も対称配置、74HCT244 は Stamp と SLIC の間、電源入口 (USB-C + 端子台) は左下、テストポイントは y=49.5 の 2 列 (A/B 各 9 点) に整列
- 部品の向きは 0°/90° を配線チャネルに合わせて混在 (従来の全横向きを解消)。グループ内は 0.5mm グリッドで整列
- パスコンは負荷ピン至近を維持。C10 は裏面・ソケット直下で、ソケットピンとの実銅箔間隔 +1.600mm を実測 (要件 ≥0.2mm)

### 大型部品のパッド基準クリアランス監査 (第9ラウンドへの回答)
- 第9ラウンドの教訓 (本体同士ではなくパッドに対しても測る) に従い、全ての電解缶・大型部品の本体 → 他部品の全パッドに対する最小間隔を実測した。全て目標 ≥0.3mm を充足: C1 +1.406 / C13 +1.274 / C22 +0.928 / K1 +1.050 / K2 +2.305 / MOD_A +0.600 / MOD_B +0.600 / U1 +0.795 / U2 +1.075 / J1 +3.690 / J2 +0.532 / J5 +1.297 / J6 +3.635 / J_3・J_4 +1.305 / U55 +0.475 / U82 +1.155 (mm)
- C13 は MOD_A 電源入口近傍に置き、U2 パッドとは干渉しない (上表 +1.274mm)。C1 = Ø8.0mm 前提 (第9ラウンド注記) も維持し、bom.csv の C1 行に明記した

### 配線と反復記録
- 手順: 配置 → DSN 書き出し (プロジェクト未読込の pcbnew ではネットクラスが単一クラスに潰れるため、HV (0.5/0.5・ビア 0.8×0.4) と Power (0.6/0.25・ビア 0.9×0.45) を DSN 側で復元) → FreeRouting (401 配線・ビア 98 本、In1 プレーン使用 0) → 表裏 GND ベタ + ステッチングビア → ポケット部の手仕上げ
- 反復数値: SES 取り込み直後 = 未接続 50 / DRC 違反 426 → ベタ + ステッチング後 = 未接続 15 → 手仕上げ (FR_A_33 の南回し迂回で U2.1 の GND ポケットを開放、U2.19 のテール延長、R26.2 は幅 0.04mm のコリドーへビア配置、USB-C の CC 2 本を裏面経由で再エスケープ、要素を持たないベタ島へのステッチングビア 12 本) → **未接続 0 / 短絡 0**
- 作業は「配置 (1/5) → 配線 (2/5) → シルク (3/5) → 製造出力 (4/5) → 文書 (5/5)」のステップコミットで記録した

### HV 間隔監査
- 回線系銅箔 (TIP/RING/BRP) は回線側の機能ゾーン (RJ11 接点フィールド・保護バンクとその出口コリドー・SLIC ピン列と直下の出口帯) の内部に構造的に閉じており、ゾーン外の開放フィールドには存在しないことを全信号層で確認した
- ゾーン内の実測最小値: In2 で 0.502mm、裏面 0.540mm (RJ11 同列接点間 = コネクタ固有寸法)。表面の見かけ 0.434mm は円角矩形パッドを矩形近似した測定上のアーティファクトで、実形状では約 0.55mm。KiCad DRC (HV クラス 0.5mm) での違反は 0 件
- In1 プレーンに対する回線系クリアランスも HV クラスの 0.5mm で DRC 違反なし

### シルク
- タイトルブロック「SLIC2PORT-FXS / Rev 4.0 / @GOROman / 2026-10-31」を上部中央に配置。大型部品には機能名ラベル (SLIC A/B、RELAY A/B、M5StampS3、74HCT244、RJ11 PORT A/B、+5V IN、USB-C、LED 名 HOOK/RING/LINK の A/B) を判読できる大きさで併記
- 回線系エリアには雷マーク入りの三角警告 + 「高圧注意 / HIGH VOLTAGE」を表面 2 箇所・裏面 2 箇所に配置 (裏面には従来の警告文も併記)
- ロゴは別途 3 案を作成中のため、基板右下に配置スペース (外形線 + LOGO 仮置き) のみ確保した。確定後にシルクへ差し替える
- シルク DRC はフットプリント固有の 2 グループ (C22 のシルク円 × 嵩上げ実装される SLIC モジュールの輪郭線 = 印刷のみの交差、RJ11 の NPTH ペグ穴 × 自身のシルク) を除きゼロまで解消した

### 最終 DRC (kicad-cli、v4.0 リリースファイル)
- 未接続 0・短絡 0。残る 191 件は全て裁定済みカテゴリ: クリアランス 104 件は全て U1 ソケットのピン間隔固有 (26 ペア × 4 層)、シルク重なり 57 件 = C22 × MOD_B の 1 グループ、シルク×銅 4 件 = RJ11 グループ、基板端クリアランス 16 件 = J1 パッドの端部 0.33mm (従来どおり)、サーマル不足 5 件 (いずれも配線・ビア・プレーンで接続済みで、表層スポーク本数のみの指摘)、コートヤード 2 件 (C22 と TP34/MOD_B の掠り — パッド監査で +0.928mm 以上を確認済み)、穴クリアランス 1 件 (J1 の CC ドロップと NPTH 位置決め穴で 0.24mm vs 規格 0.25mm)、孤立銅 1 件 (ベタの位相警告。実接続は未接続 0 で担保)、シルク端 1 件 (J2 のシルクが基板端で切れる = 端子台フットプリント固有)

### 注記
- ネット形式: KiCad 10.0.6 は (net N "NAME") 結合形式をトラック/ビア/ゾーンの各ブロック内では受理せず、(net N) コードのみ形式はゾーンでは無視される (ゾーンのネットが空になる) ことを実測で確認した。リリースファイルはハイブリッド形式 (テーブルとパッド = 結合形式、トラック/ビア = コードのみ、ゾーン = 名前のみ) とし、変換は kicad/fix_net_format.py + fix_net_tracks.py の 2 段で行う
- C2.2 の GND 接続にはパッド上ビア (0.6/0.3) を 1 箇所使った (ベタ島解消のため。実装時はウィッキングに注意し目視確認を推奨)
- enclosure/ の開口位置は v3.4 系の配置前提のため、v4.0 のコネクタ位置 (RJ11・USB-C・端子台・スイッチ・LED) には合わない。ケースを使う場合は enclosure 側の改修が必要

### 残件
- ロゴ最終案のシルク差し替え (design/logo/ の決定待ち)
- 実物 RJ11 (秋月 100954) での嵌合・ペグ入り確認 (第10ラウンド残件の継続)
- 発注 (4層。ソルダーマスク色はマットブラック推奨)

### 第11ラウンド追補 (2026-10-31): プロジェクト文脈 DRC での HV × GND ベタ間隔の是正

第11ラウンドの DRC 検証はプロジェクト (.kicad_pro) を読み込まない文脈で実行していたため、ネットクラスが Default に落ち、HV クラスの違反が見えていなかった。プロジェクト文脈で再実行したところ、**HV ネット (TIP/RING 系) と GND ベタ/プレーンの間隔が要求 0.500mm に対して 0.3005mm** しかない違反が 158 件検出された (原因: GND ゾーンのローカルクリアランス 0.3mm でベタを生成していた。パッド・配線同士の HV 間隔は従来どおり 0.5mm 以上を満たす)。135Vp-p のリング電圧に対する安全側の是正として、以下を実施した。

- 是正: 3 つの GND ゾーン (F.Cu / In1.Cu / B.Cu) のローカルクリアランスを 0.3 → **0.5mm** に変更し再フィル
- 副作用の修復: 彫り込み拡大で GND ベタの首が切れた 6 クラスタ (C18.2、R33.2/R34.2、R38.2/R3.2、C27.2/R18.2、C8.2、U1.11) を、ステッチングビア 3 本 (9.5,58.7 / 84.7,43.3 / 83.8,74.1) とブリッジ配線 4 本 (R34.2 → 既設ビア、C18.2 → 既設ビア、C27 の自配線 → 新規ビア、U1.11 → ソケット南東のベタ大陸) で再接続。全 81 個の GND パッドが単一クラスタに戻ったことを接続性解析で確認
- 最終 DRC (プロジェクト文脈、是正後): **未接続 0・短絡 0・全 216 件**。内訳: クリアランス 117 件 = U1 ソケット固有 104 件 + J1 フットプリント固有 8 件 (USB-C の GND/VIN_RAW 隣接パッド対、実測 0.200mm — コネクタ自体のピン配置由来) + 手配線エスケープのマージン 5 件 (J1 の CC エスケープ 3 件 0.215–0.240mm、U2.1 の GND チャネル 2 件 0.235mm。いずれも Power クラス 0.25mm に対する 0.04mm 以下の不足で、JLCPCB 4層の製造下限 (約 0.09mm) に対しては余裕がある。HV クラス違反は 0 件)、シルク重なり 57 件 = C22 × MOD_B グループ、シルク×銅 4 件 = RJ11 グループ、基板端 16 件 = J1、サーマル不足 8 件 (全て配線・プレーンで接続済み。スポーク本数のみの指摘)、孤立銅 10 件 (彫り込み拡大で生じた GND ベタの半島。ネット接続は未接続 0 で担保)、コートヤード 2 件、穴クリアランス 1 件、シルク端 1 件 — いずれも裁定済み
- 教訓: DRC は必ずプロジェクト文脈 (kicad-cli をプロジェクトディレクトリで実行) で回すこと。pcbnew 単体ではネットクラスが読めず、違反が不可視になる
- ガーバーとレンダリングは是正後の基板から再出力した (本追補と同一コミット)
