GOROman/m5stamp-slic-fxs/docs/images/board-v2-bottom.png

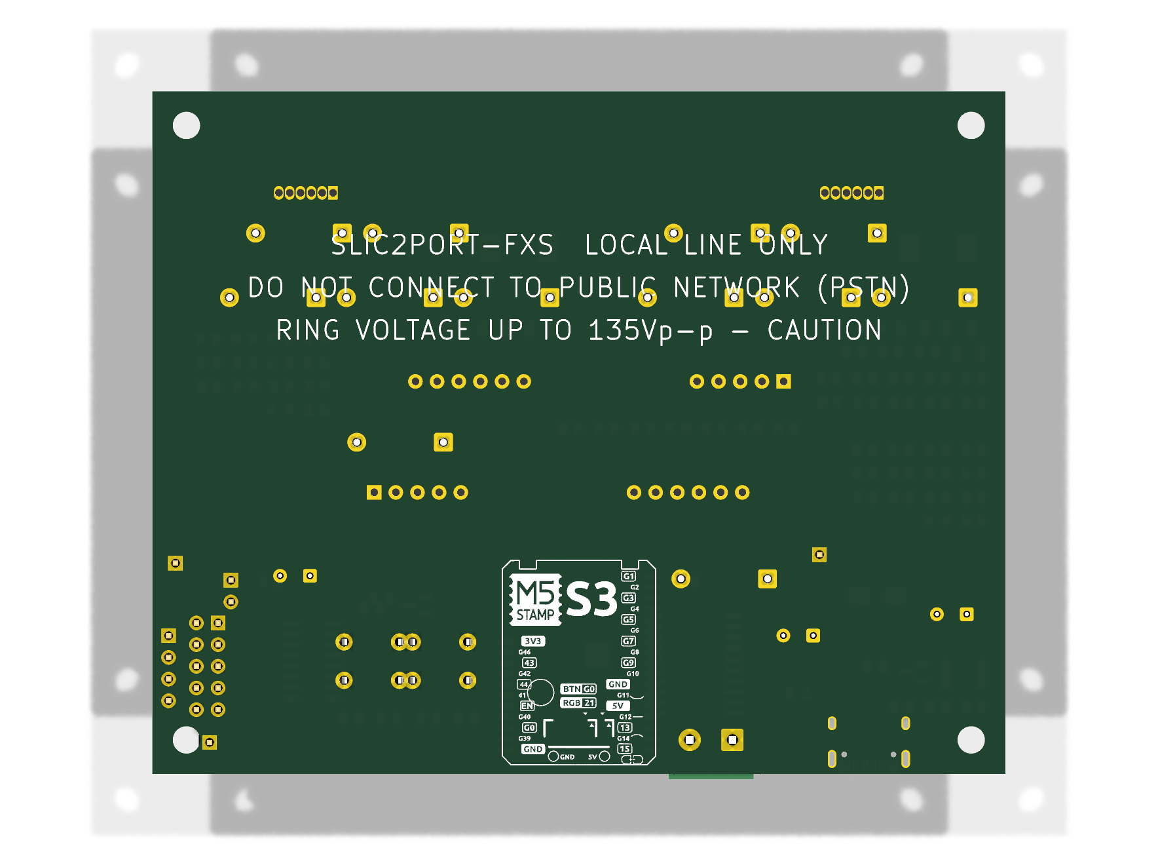
docs/images/board-v2-bottom.png
