GOROman/m5stamp-slic-fxs/docs/images/board-v2-top.png

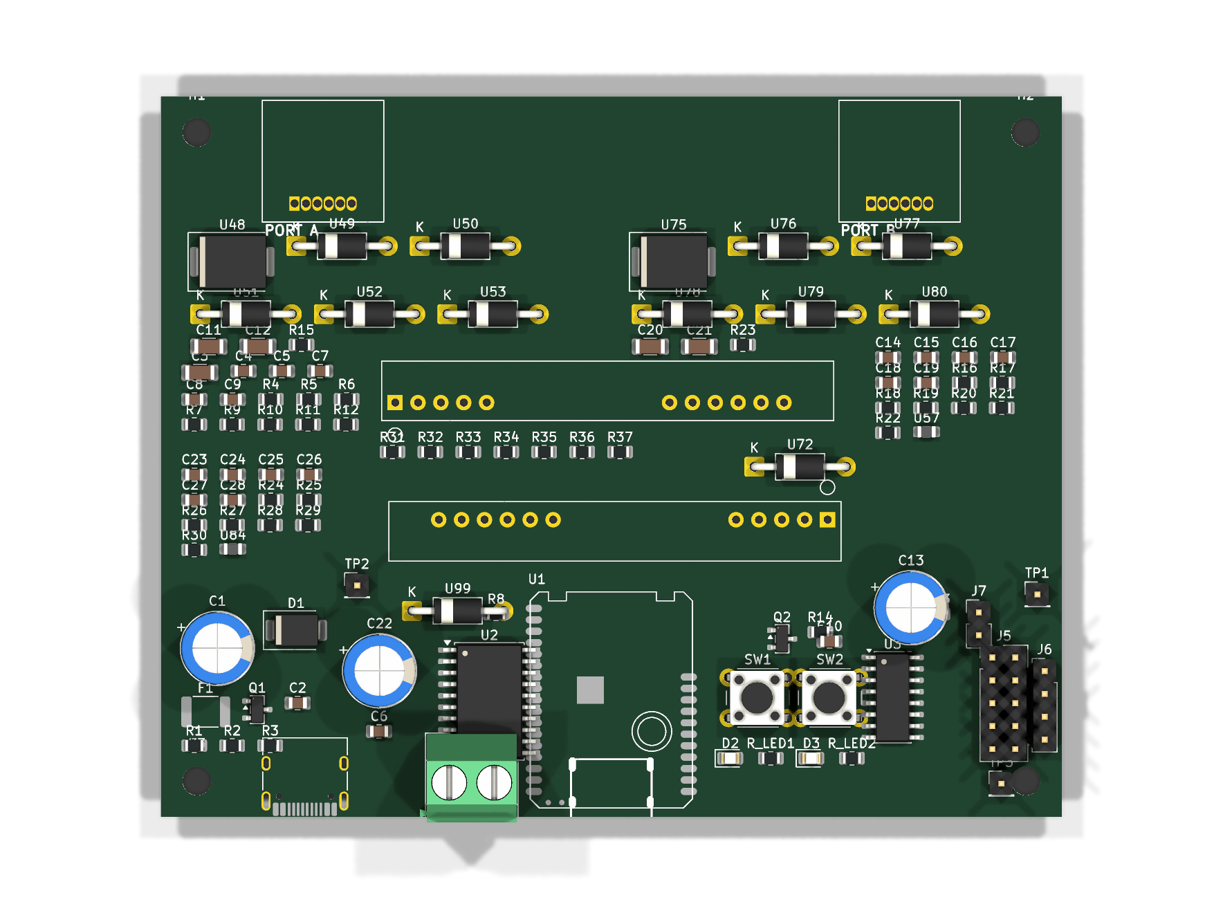
docs/images/board-v2-top.png
