GOROman/m5stamp-slic-fxs/docs/images/board-v3-bottom.png

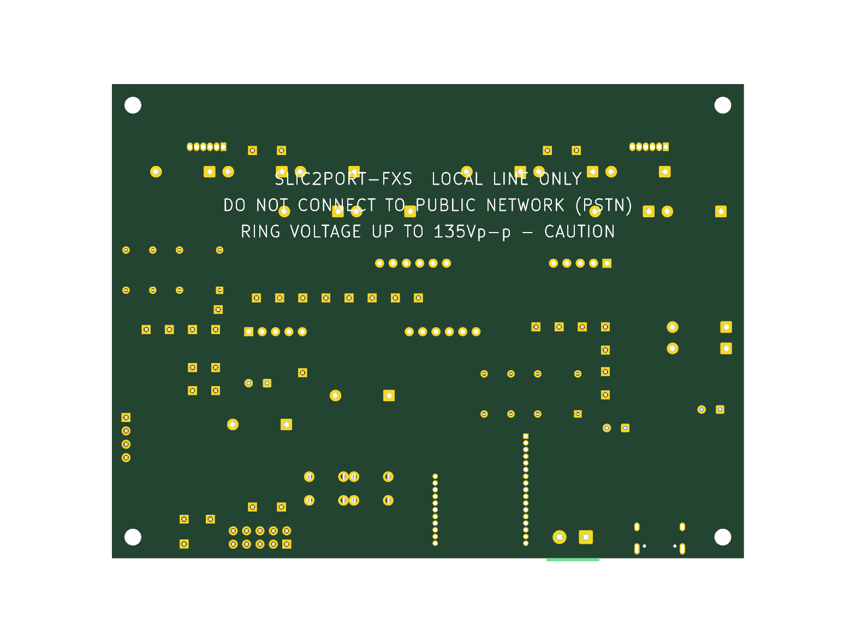
docs/images/board-v3-bottom.png
