GOROman/m5stamp-slic-fxs/docs/images/board-v3-top.png

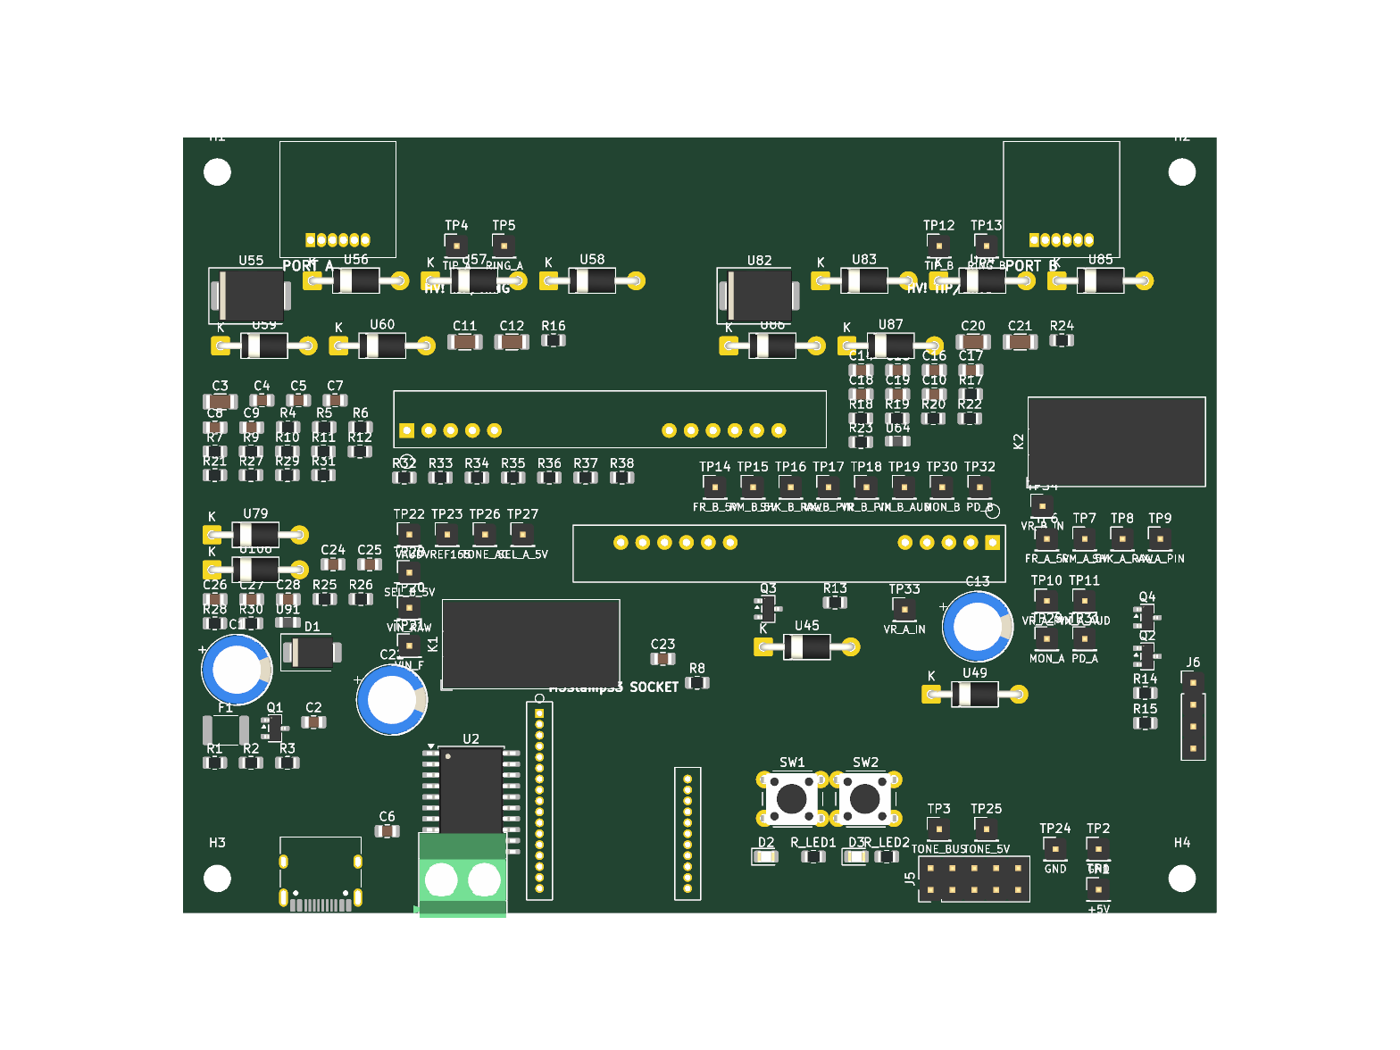
docs/images/board-v3-top.png
