GOROman/m5stamp-slic-fxs/docs/images/board-v31-bottom.png

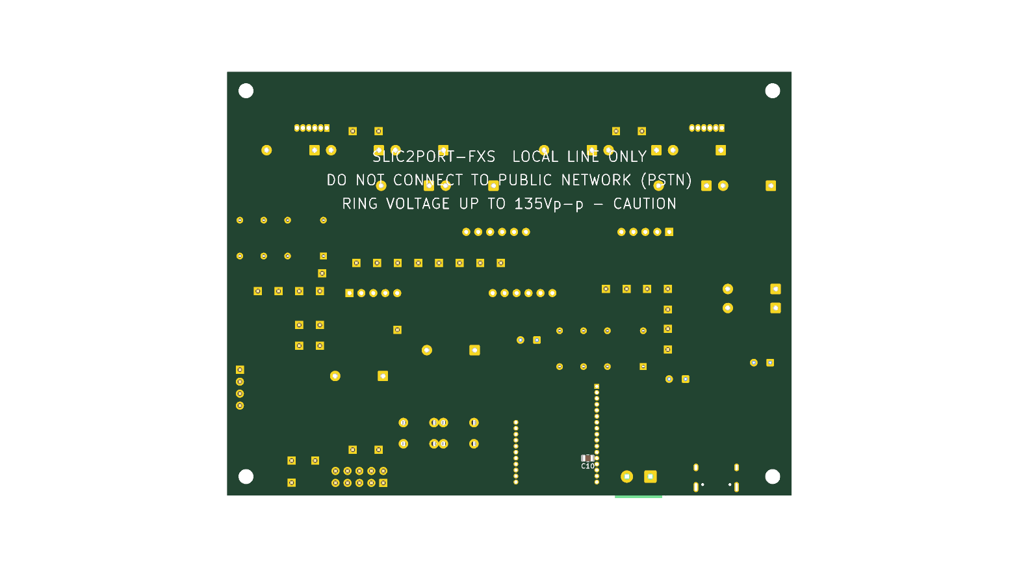
docs/images/board-v31-bottom.png
