GOROman/m5stamp-slic-fxs/docs/images/board-v31-top.png

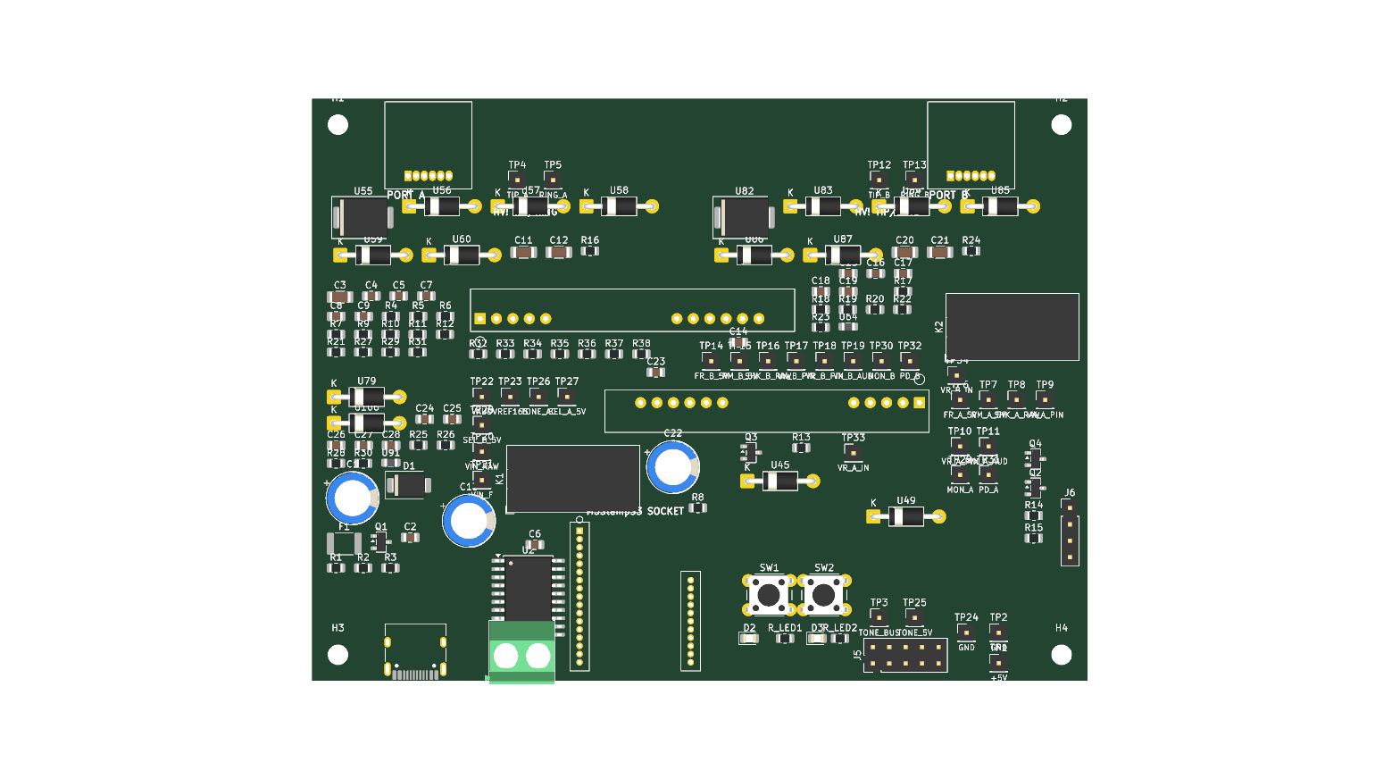
docs/images/board-v31-top.png
