GOROman/m5stamp-slic-fxs/docs/images/board-v32-bottom.png

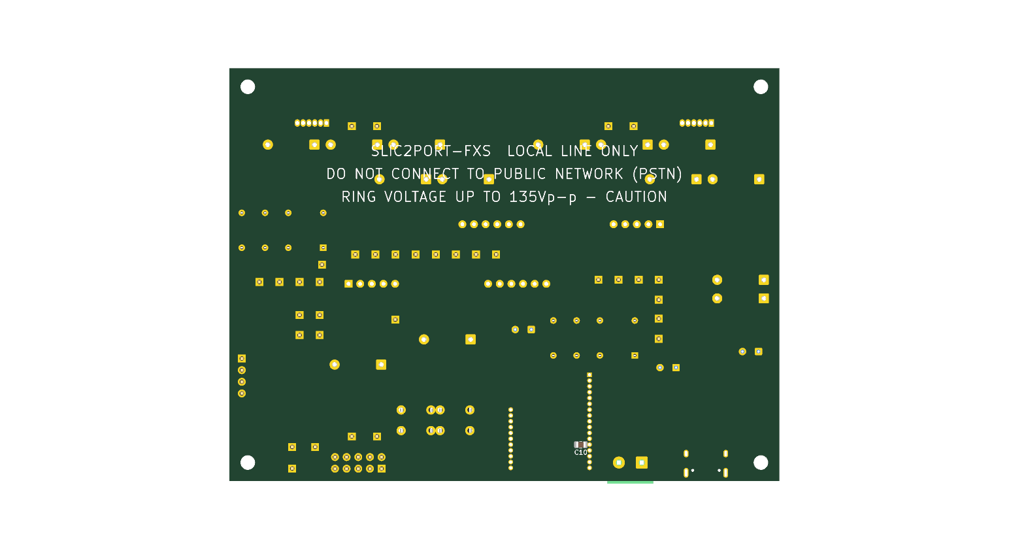
docs/images/board-v32-bottom.png
