GOROman/m5stamp-slic-fxs/docs/images/board-v32-top.png

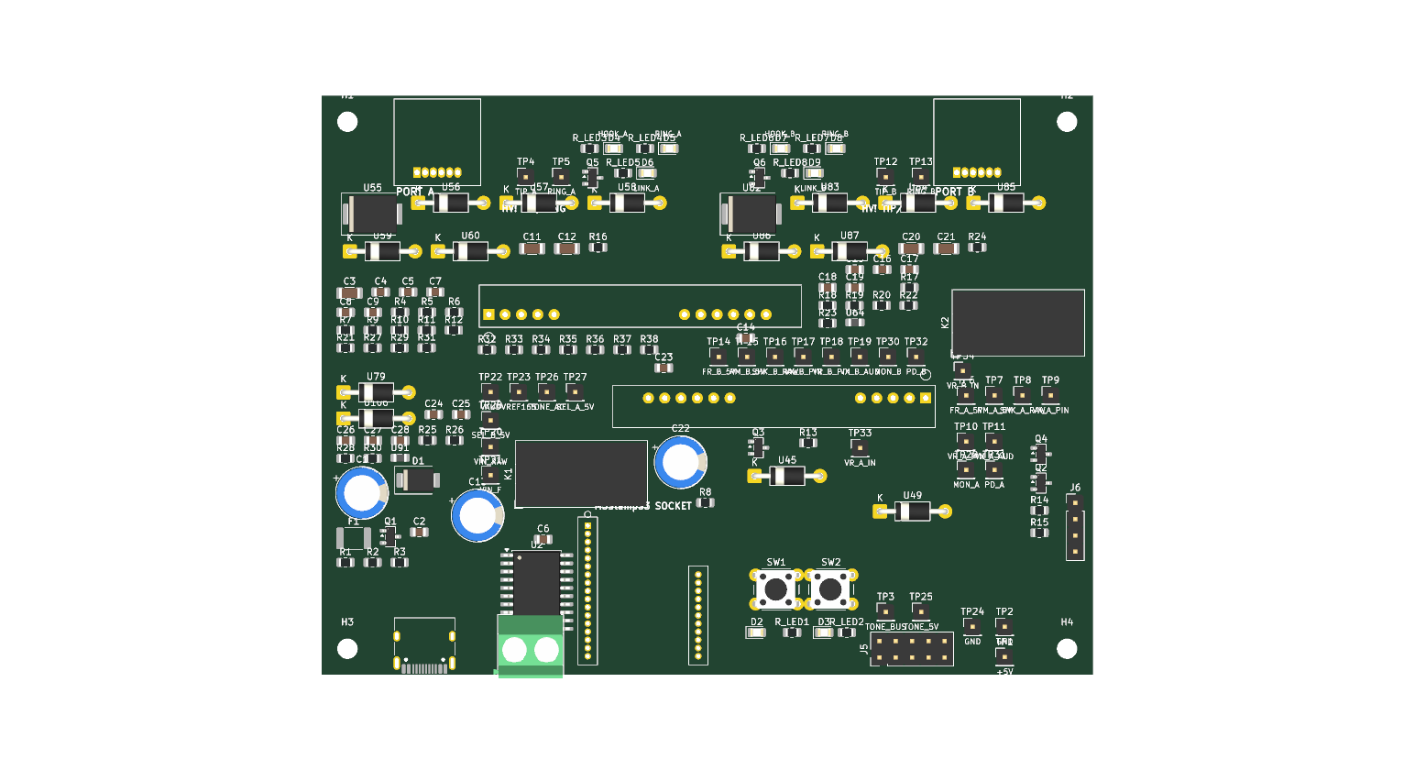
docs/images/board-v32-top.png
