GOROman/m5stamp-slic-fxs/docs/images/board-v34-bottom.png

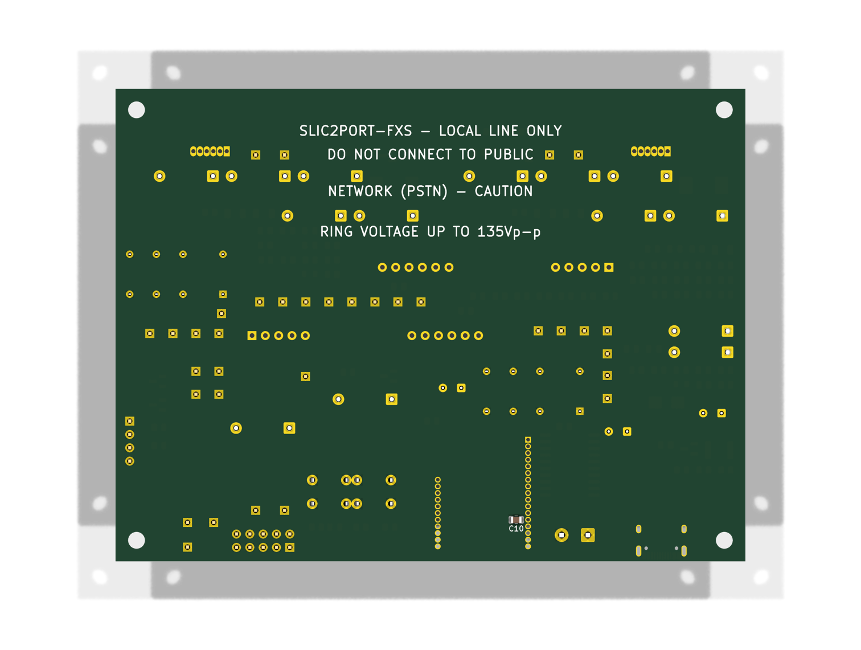
docs/images/board-v34-bottom.png
