GOROman/m5stamp-slic-fxs/docs/images/board-v34-routed-3d.png

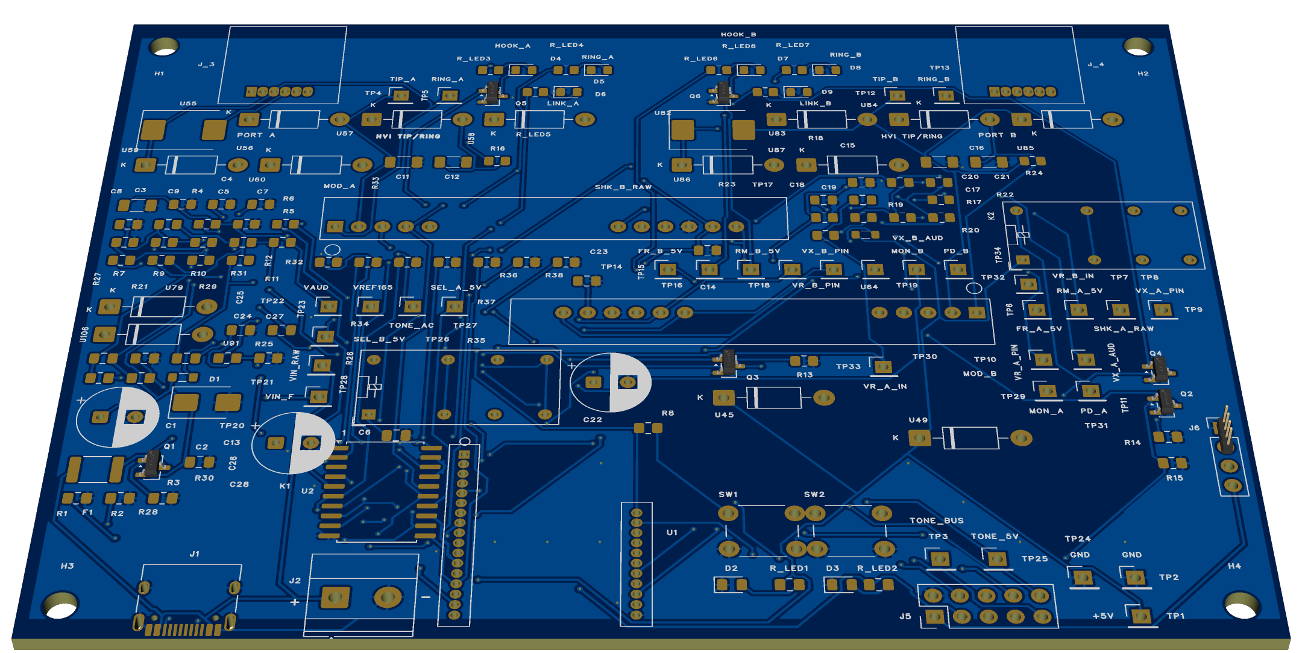
docs/images/board-v34-routed-3d.png
