GOROman/m5stamp-slic-fxs/docs/images/board-v34-routed-bottom.png

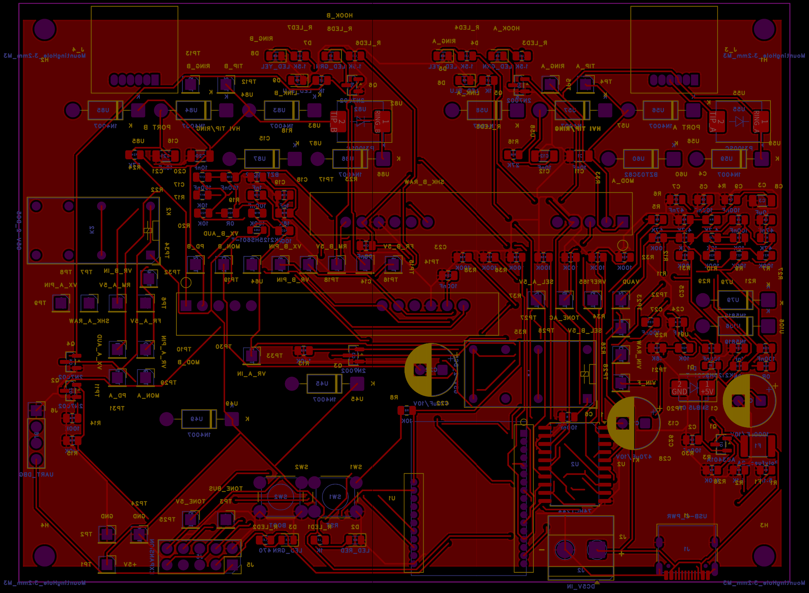
docs/images/board-v34-routed-bottom.png
