GOROman/m5stamp-slic-fxs/docs/images/board-v34-routed-top.png

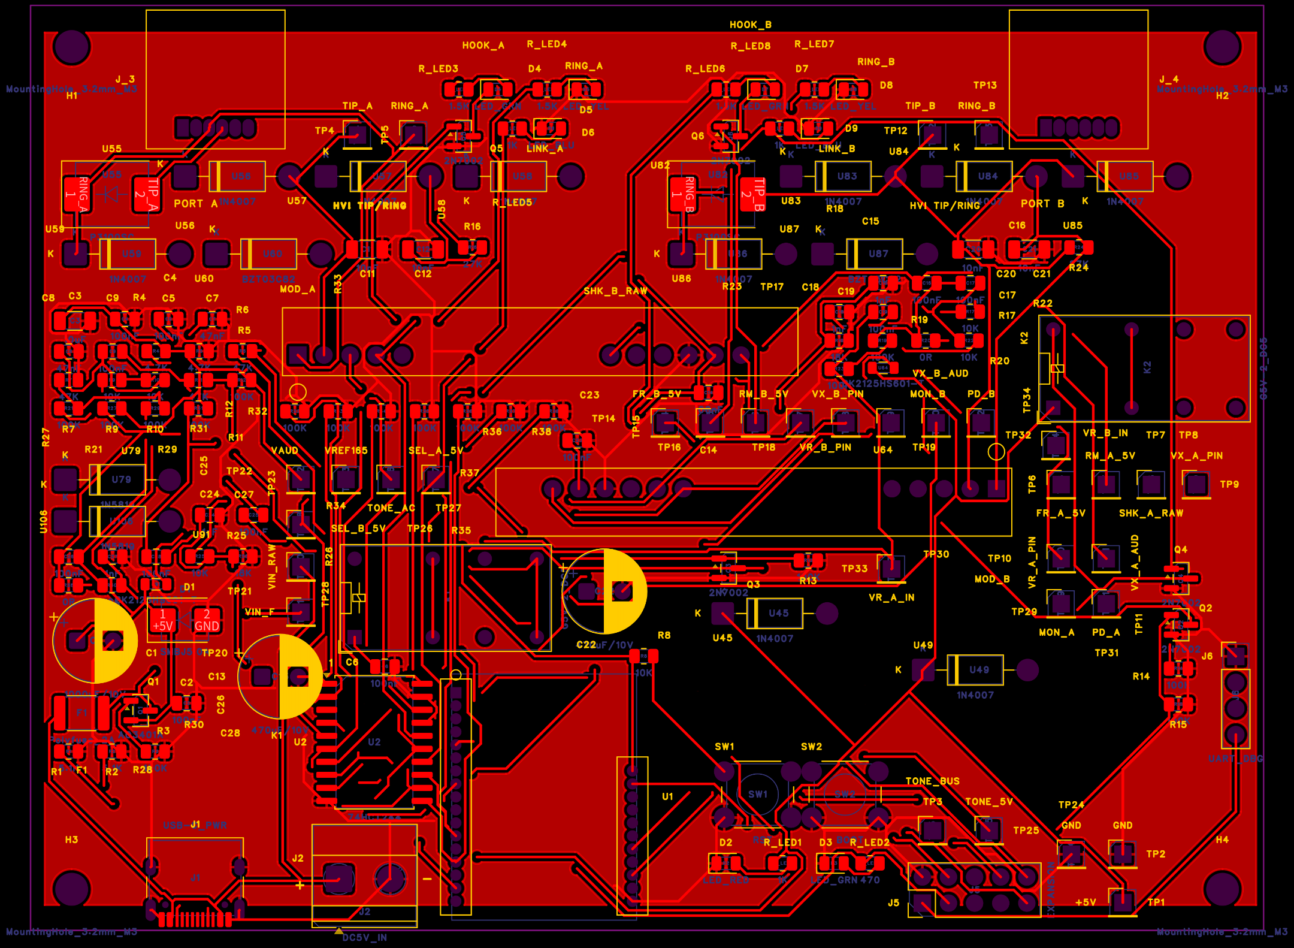
docs/images/board-v34-routed-top.png
