GOROman/m5stamp-slic-fxs/docs/images/board-v40-crop-q1.png

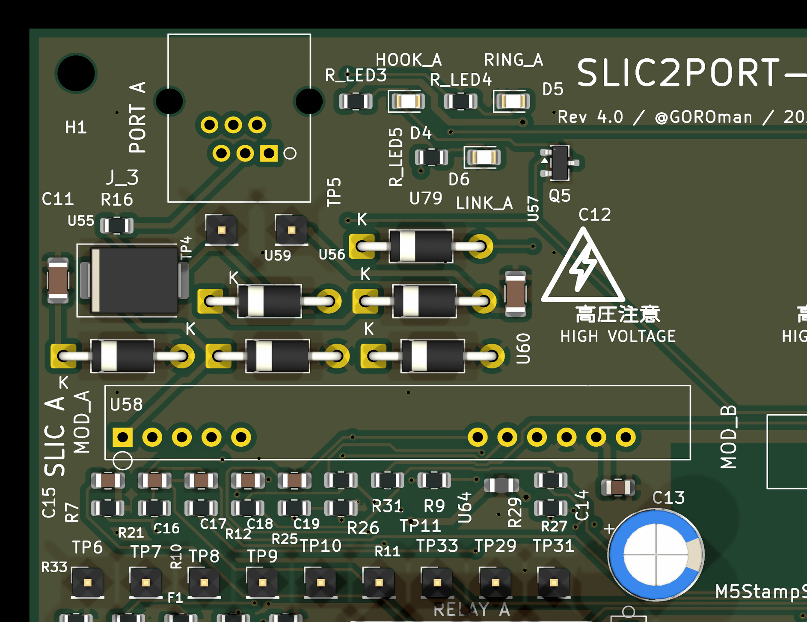
docs/images/board-v40-crop-q1.png
