GOROman/m5stamp-slic-fxs/docs/images/board-v40-crop-q3.png

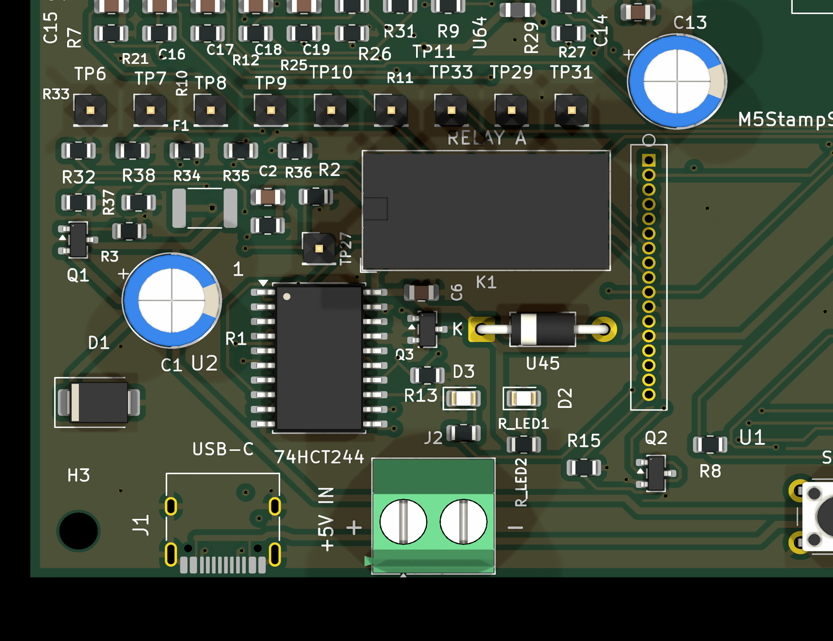
docs/images/board-v40-crop-q3.png
