GOROman/m5stamp-slic-fxs/docs/images/board-v341-c13-u2-diagram.png

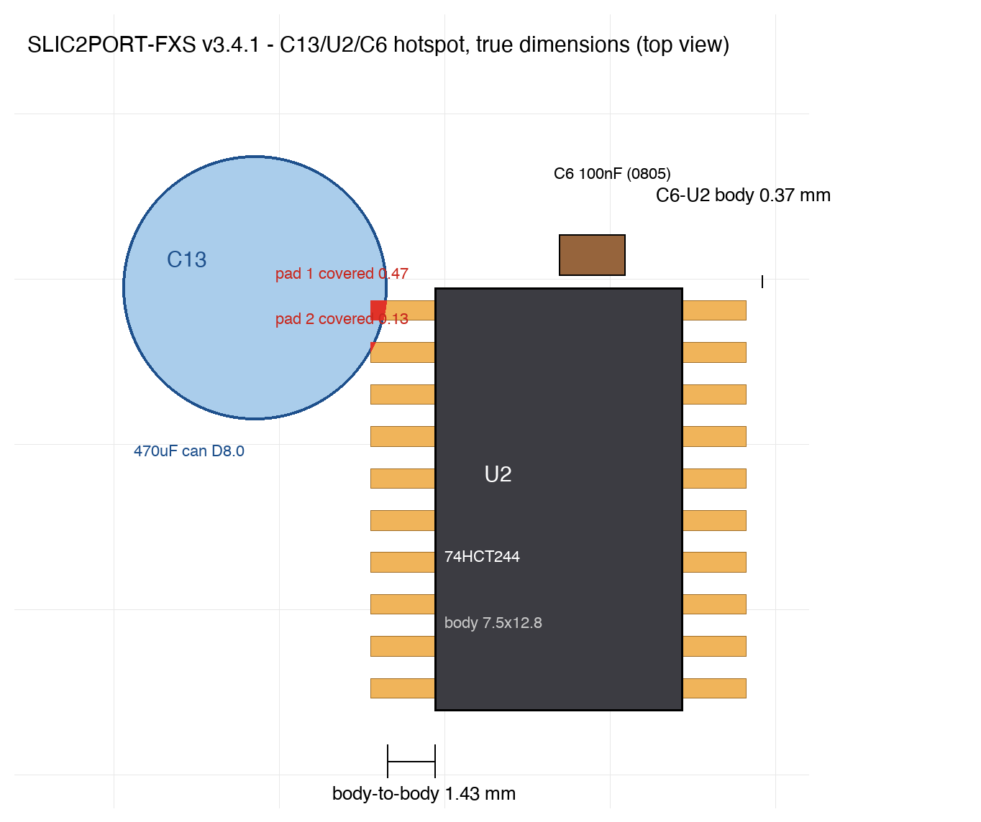
docs/images/board-v341-c13-u2-diagram.png
