GOROman/m5stamp-slic-fxs/docs/images/board-v341-crop-c10-bottom.png

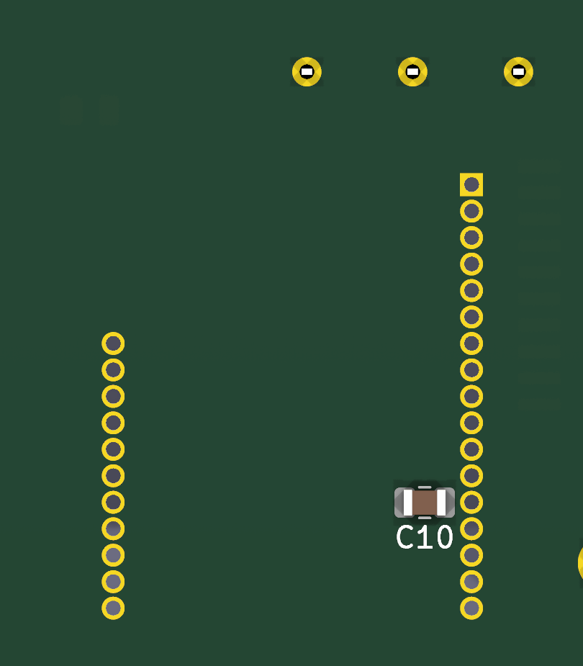
docs/images/board-v341-crop-c10-bottom.png
