GOROman/m5stamp-slic-fxs/docs/images/board-v341-crop-c13-u2.png

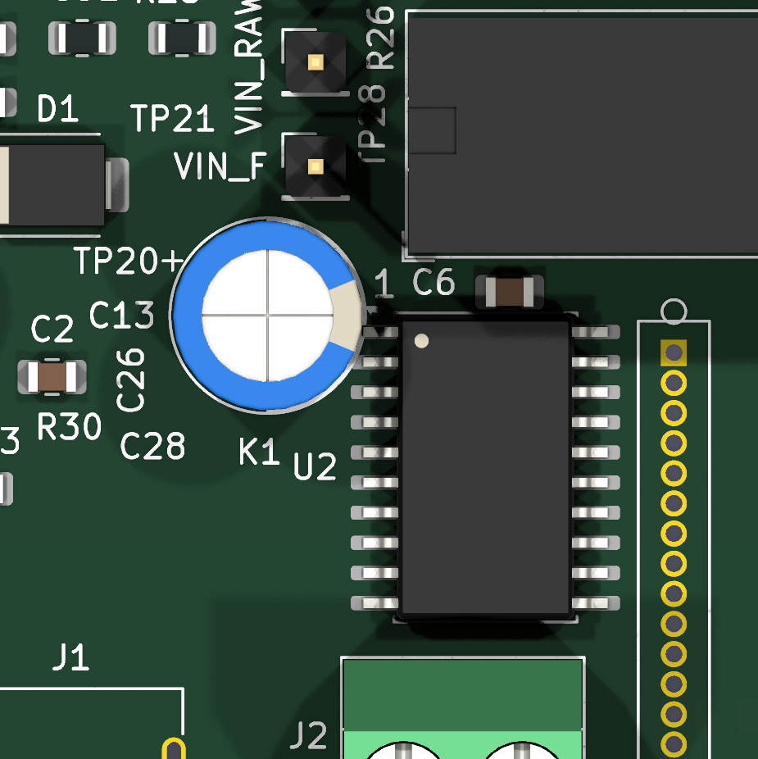
docs/images/board-v341-crop-c13-u2.png
