GOROman/m5stamp-slic-fxs/enclosure/renders/render-base.png

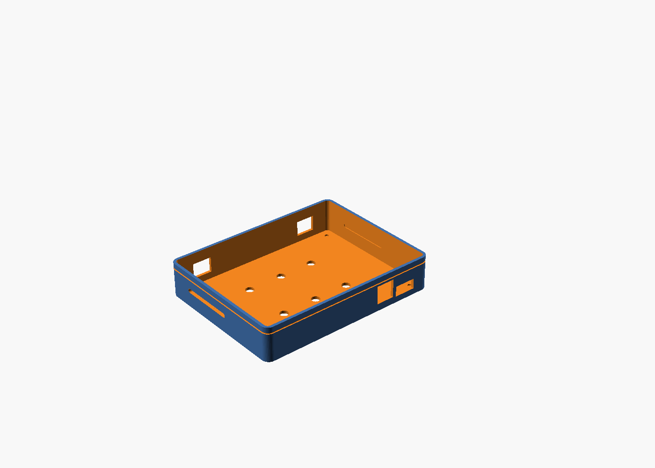
enclosure/renders/render-base.png
