GOROman/m5stamp-slic-fxs/enclosure/renders/render-lid.png

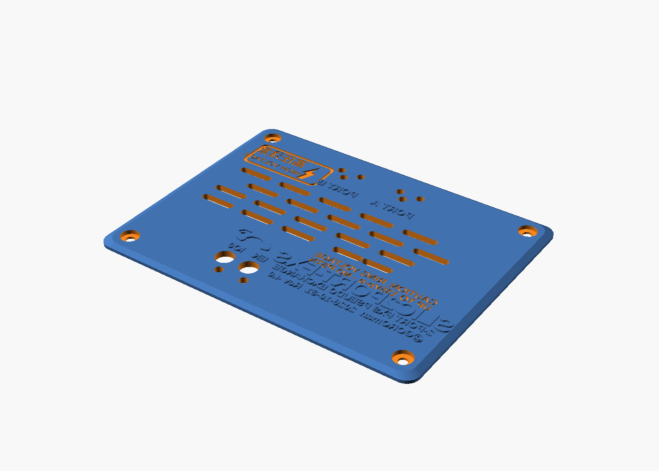
enclosure/renders/render-lid.png
