GOROman/m5stamp-slic-fxs/enclosure/renders/render-plungers.png

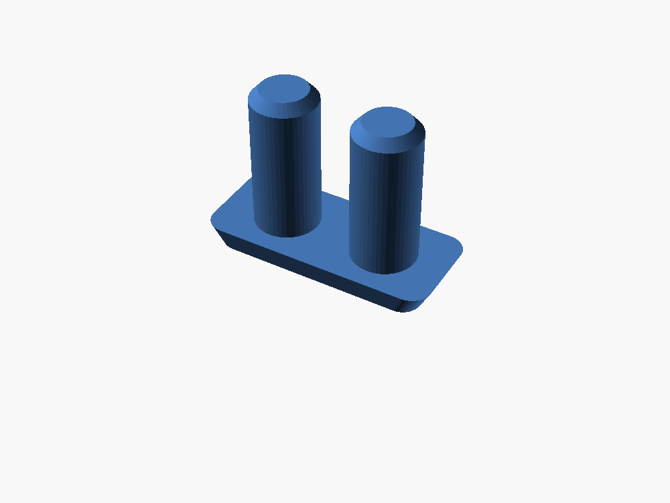
enclosure/renders/render-plungers.png
