GOROman/m5stamp-slic-fxs/research/KS0835F-p7-7.png

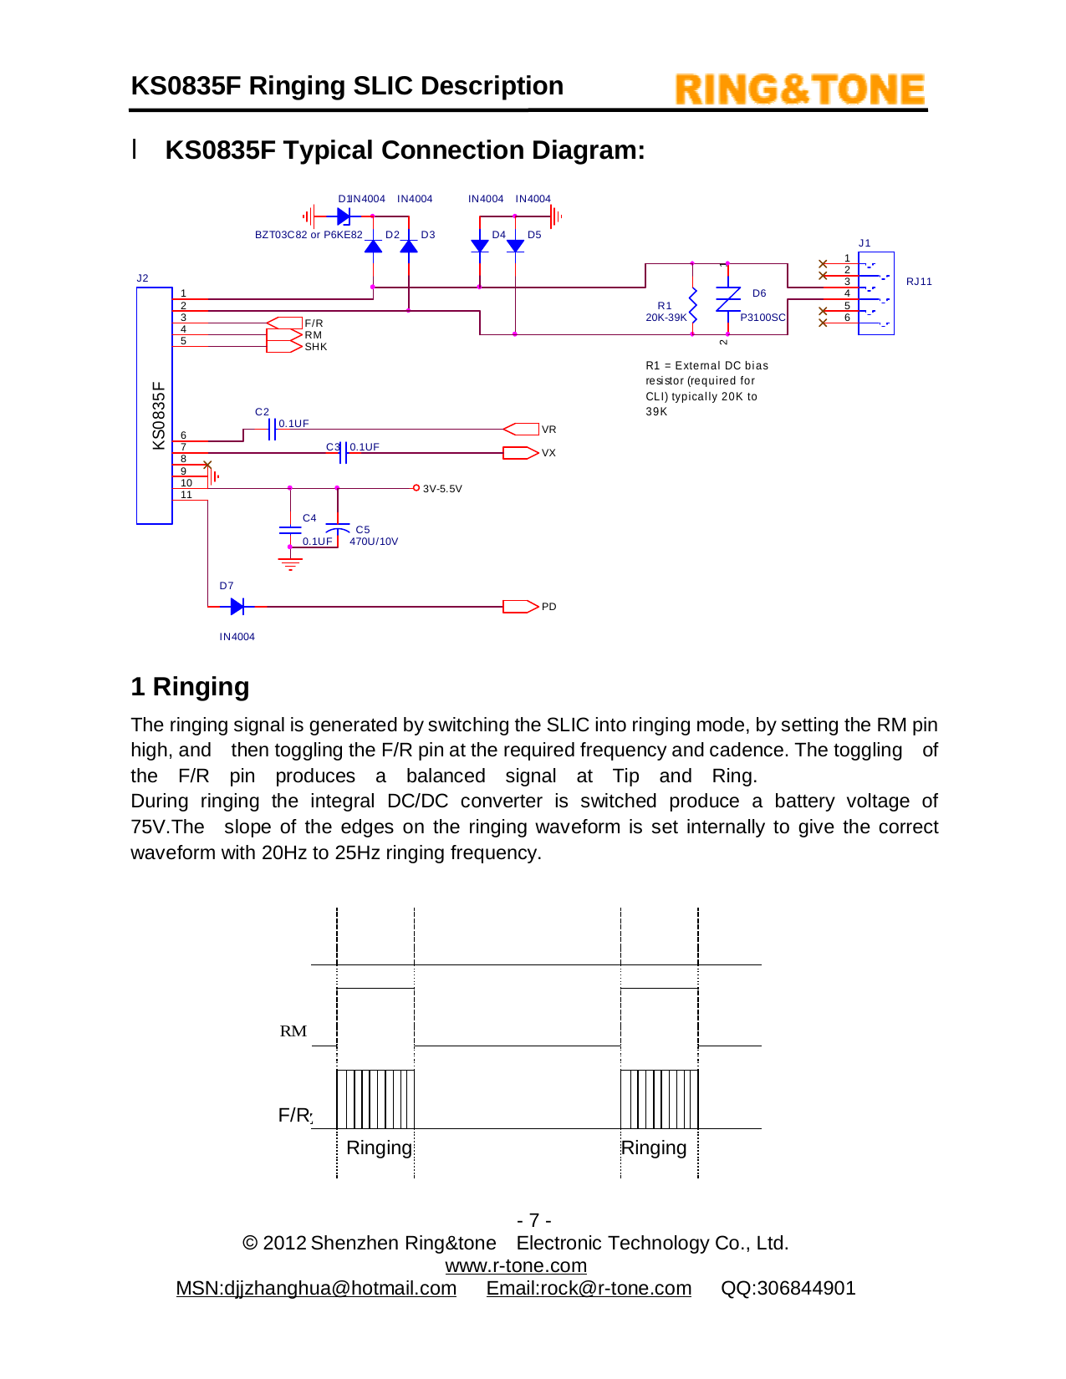
research/KS0835F-p7-7.png
