GOROman/m5stamp-slic-fxs/research/KS0835F-p9-9.png

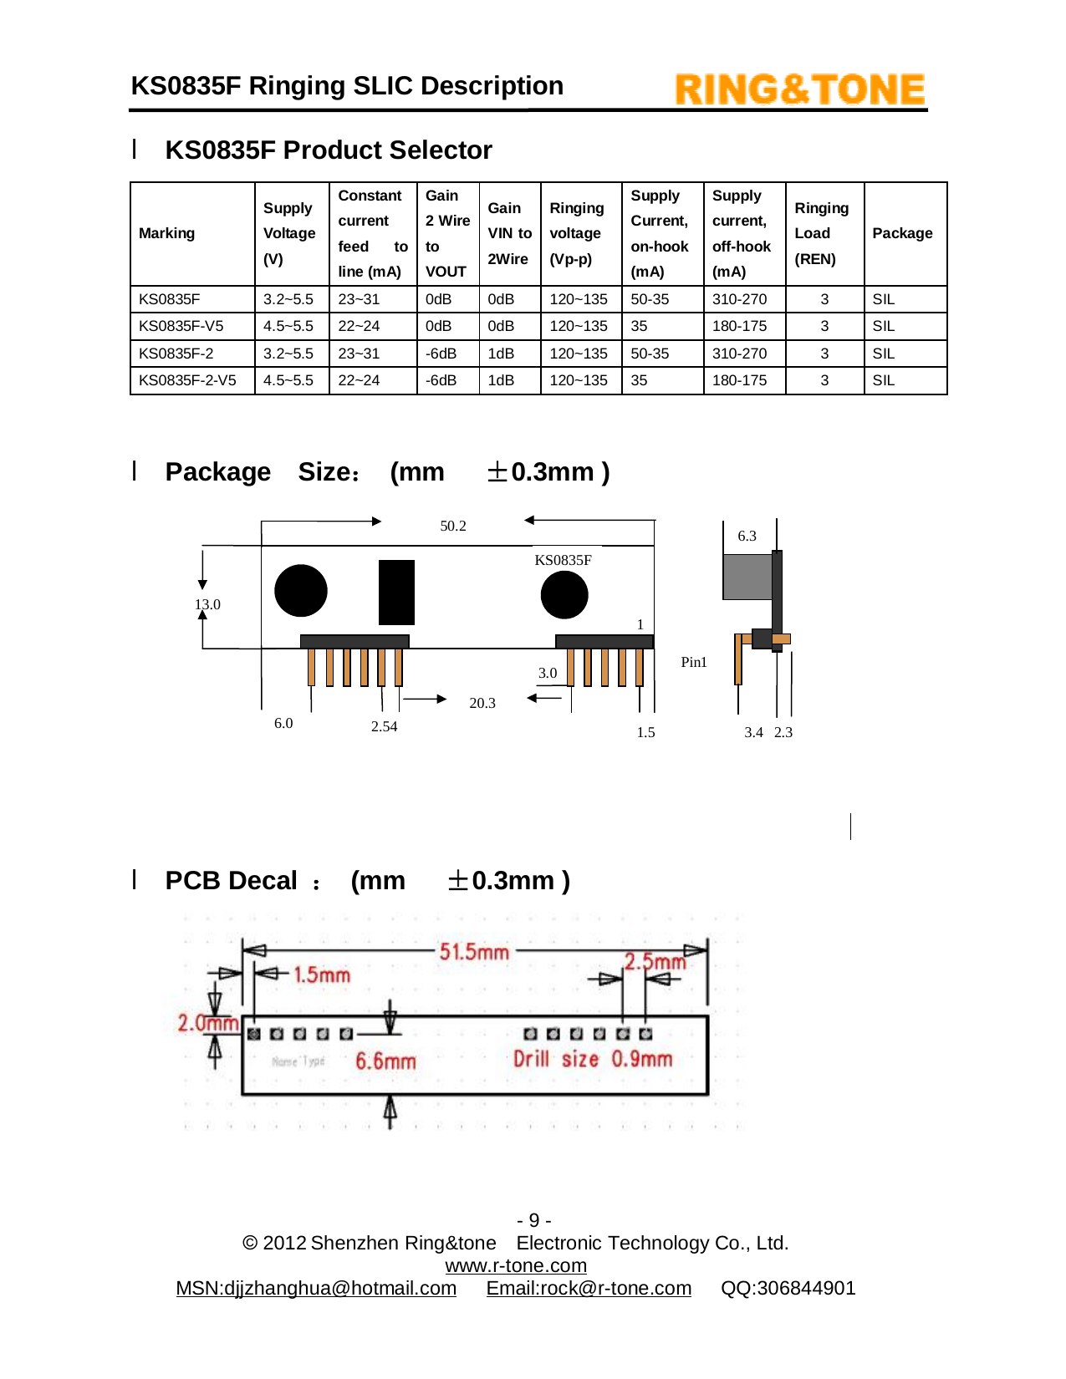
research/KS0835F-p9-9.png
