GOROman/m5stamp-slic-fxs/bom.csv

Value | Footprint | Qty | Refs | Note
0R | Resistor_SMD:R_0805_2012Metric | 2 | R20 R28
1.5K | Resistor_SMD:R_0805_2012Metric | 4 | R_LED3 R_LED4 R_LED6 R_LED7 | ステータス LED 電流制限 (HOOK/RING、約2mA)
1000uF/10V | Capacitor_THT:CP_Radial_D8.0mm_P3.50mm | 1 | C1 | 入力バルク。缶径 Ø8.0mm 品が必須 (Ø10mm 品は R30 と干渉。CAD_REPORT 第9ラウンド注記参照)
100K | Resistor_SMD:R_0805_2012Metric | 18 | R12 R13 R14 R15 R19 R21 R23 R27 R29 R3 R31 R32 R33 R34 R35 R36 R37 R38
100nF | Capacitor_SMD:C_0805_2012Metric | 14 | C10 C14 C16 C17 C19 C2 C23 C25 C26 C28 C4 C5 C6 C9
10K | Resistor_SMD:R_0805_2012Metric | 7 | R10 R17 R22 R25 R30 R8 R9
10nF | Capacitor_SMD:C_1206_3216Metric | 4 | C11 C12 C20 C21 | EMI 対策 (AG1171)。250V 耐圧品を使うこと
10uF | Capacitor_SMD:C_1206_3216Metric | 1 | C3
18K | Resistor_SMD:R_0805_2012Metric | 2 | R18 R26
1K | Resistor_SMD:R_0805_2012Metric | 3 | R_LED1 R_LED5 R_LED8 | LED 電流制限 (R_LED1=電源 LED、R_LED5/R_LED8=LINK)
1N4007 | Diode_THT:D_DO-41_SOD81_P10.16mm_Horizontal | 10 | U45 U49 U56 U57 U58 U59 U83 U84 U85 U86 | 保護ブリッジ x4/ポート + リレー還流 x2 (秋月 100934)。PD 用は 1N5819 行に分離 (v3.4)
1N5819 | Diode_THT:D_DO-41_SOD81_P10.16mm_Horizontal | 2 | U106 U79 | PD 引き下げ用ショットキー。Vf が低く Ag1171 の PD VIL(max) 0.5V を満たすため v3.4 で 1N4007 から変更
1nF | Capacitor_SMD:C_0805_2012Metric | 4 | C15 C18 C24 C27
27K | Resistor_SMD:R_0805_2012Metric | 2 | R16 R24 | CLI バイアス (指定 20K-39K)
2N7002 | Package_TO_SOT_SMD:SOT-23 | 5 | Q2 Q3 Q4 Q5 Q6 | PD 引き下げ (Q2) + リレードライバ (Q3/Q4) + HOOK LED バッファ (Q5/Q6)
4.7K | Resistor_SMD:R_0805_2012Metric | 2 | R4 R5
470 | Resistor_SMD:R_0805_2012Metric | 1 | R_LED2
470uF/10V | Capacitor_THT:CP_Radial_D8.0mm_P3.50mm | 2 | C13 C22 | モジュール直近 (KS0835F 接続図 C5)
47K | Resistor_SMD:R_0805_2012Metric | 3 | R11 R6 R7
47nF | Capacitor_SMD:C_0805_2012Metric | 2 | C7 C8
5.1K | Resistor_SMD:R_0805_2012Metric | 2 | R1 R2
74HCT244 | Package_SO:SOIC-20W_7.5x12.8mm_P1.27mm | 1 | U2 | レベル変換 3.3V->5V (F/R, RM, SEL, TONE)
AO3401A | Package_TO_SOT_SMD:SOT-23 | 1 | Q1 | 逆接保護 P-FET
BK2125HS601-T | Inductor_SMD:L_0805_2012Metric | 2 | U64 U91 | フェライトビーズ 600ohm@100MHz (秋月 109506)。BLM21AG601 でも可
BOOT | Button_Switch_THT:SW_PUSH_6mm | 1 | SW2
BZT03C82 | Diode_THT:D_DO-41_SOD81_P10.16mm_Horizontal | 2 | U60 U87 | ブリッジ対角クランプ。P6KE82 でも可
DC5V_IN | TerminalBlock_Phoenix:TerminalBlock_Phoenix_MKDS-1,5-2_1x02_P5.00mm_Horizontal | 1 | J2 | 端子台は 5.00mm ピッチ品 (秋月 WJ301-5.0-02P) を使用。KF301 (5.08mm) はピッチ不一致で不可。USB-C と同時給電禁止
EXPANSION | Connector_PinHeader_2.54mm:PinHeader_2x05_P2.54mm_Vertical | 1 | J5
G5V-2_DC5 | Relay_THT:Relay_DPDT_Omron_G5V-2 | 2 | K1 K2 | 音声クロス接続リレー (Omron G5V-2 DC5)。マルツ取扱い
KS0835F | SLIC2PORT:KS0835F | 2 | MOD_A MOD_B | ユーザ所有品 x4 のうち 2 個使用。ソケット実装
LED_BLU | LED_SMD:LED_0805_2012Metric | 2 | D6 D9 | 青: LINK (リレー励磁) 表示 (§5.7)
LED_GRN | LED_SMD:LED_0805_2012Metric | 3 | D3 D4 D7 | 緑: D3=ステータス (GPIO4)、D4/D7=HOOK 表示 (§5.7)
LED_RED | LED_SMD:LED_0805_2012Metric | 1 | D2 | 電源 LED
LED_YEL | LED_SMD:LED_0805_2012Metric | 2 | D5 D8 | 黄: RING 表示 (§5.7)
M5StampS3/S3A | SLIC2PORT:Stamp-S3-Socket | 1 | U1 | ユーザ調達。ソケット実装 (直接はんだ付けしない): 基板側に 1.27mmピッチ メスピンヘッダ 17P + 11P (分割可能なソケットレールで可) を実装し、Stamp 側キャスタレーションに 1.27mm オスピンを付けて差し込む。PIN2.54 バリアント不可
P3100SC | Diode_SMD:D_SMC | 2 | U55 U82 | 回線保護サイリスタ (差動)。P3100EBL (TO-92) でも可
Polyfuse_2A | Fuse:Fuse_1812_4532Metric | 1 | F1 | 例: Littelfuse 1812L200 相当
RJ11_6P6C | SLIC2PORT:RJ11_6P6C_TH | 2 | J_3 J_4 | 中央ペア (pin3=RING, pin4=TIP) のみ使用。指定部品: 秋月電子 100954 (Neltron 7002-6P6C)
RST | Button_Switch_THT:SW_PUSH_6mm | 1 | SW1
SMBJ5.0A | Diode_SMD:D_SMB | 1 | D1 | 5V 入力 TVS
TP | Connector_PinHeader_2.54mm:PinHeader_1x01_P2.54mm_Vertical | 34 | TP1 TP10 TP11 TP12 TP13 TP14 TP15 TP16 TP17 TP18 TP19 TP2 TP20 TP21 TP22 TP23 TP24 TP25 TP26 TP27 TP28 TP29 TP3 TP30 TP31 TP32 TP33 TP34 TP4 TP5 TP6 TP7 TP8 TP9 | テストポイント (TP1-TP34)。TIP/RING は高電圧注意
UART_DBG | Connector_PinHeader_2.54mm:PinHeader_1x04_P2.54mm_Vertical | 1 | J6
USB-C_PWR | Connector_USB:USB_C_Receptacle_HRO_TYPE-C-31-M-12 | 1 | J1 | 電源専用。CC に 5.1K プルダウン済
