GOROman/m5stamp-slic-fxs/enclosure/slic2port-lid.stl

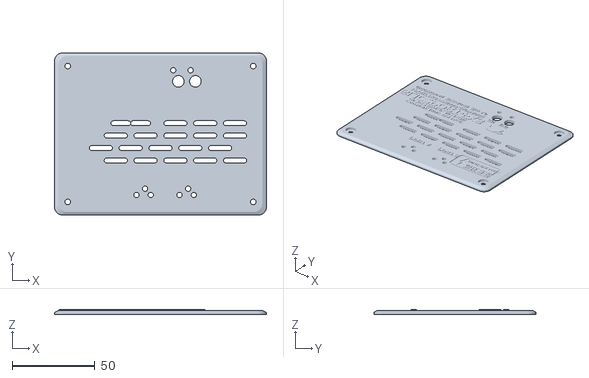
[picture p34: CAD file, 2026-10-31]
enclosure/slic2port-lid.stl
128.0 x 98.0 x 3.00
