GOROman/m5stamp-slic-fxs/enclosure/slic2port-base.stl

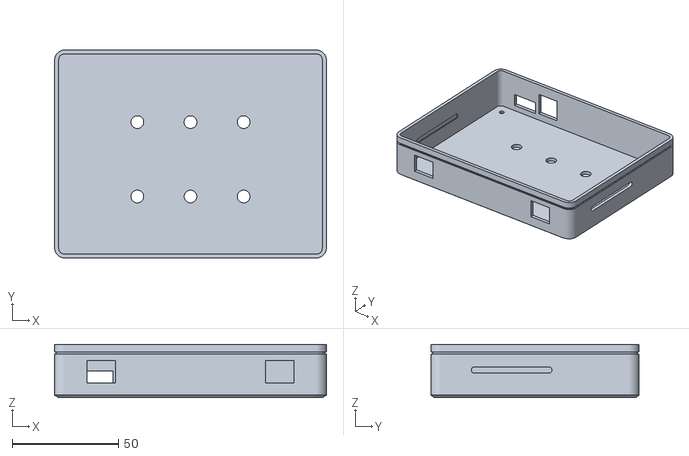
[picture p35: CAD file, 2026-10-31]
enclosure/slic2port-base.stl
128.0 x 98.0 x 25.1
