GOROman/m5stamp-slic-fxs/enclosure/slic2port-plungers.stl

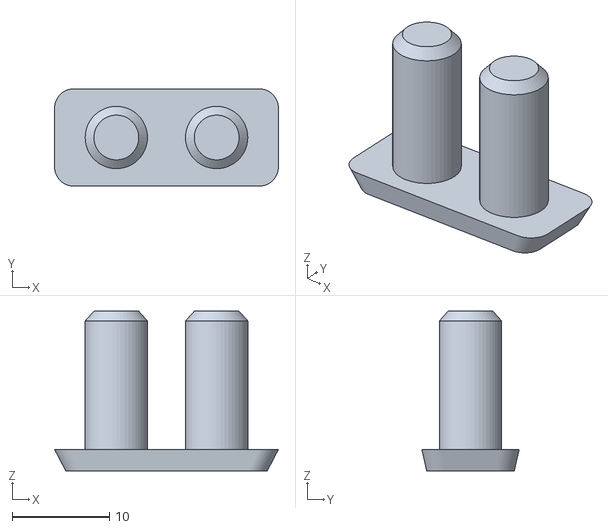
[picture p36: CAD file, 2026-10-31]
enclosure/slic2port-plungers.stl
23.0 x 10.0 x 16.4
