GOROman/m5stamp-slic-fxs/kicad/SLIC2PORT-FXS.kicad_pcb

## KiCad design kicad/SLIC2PORT-FXS.kicad_pcb (2026-10-31)

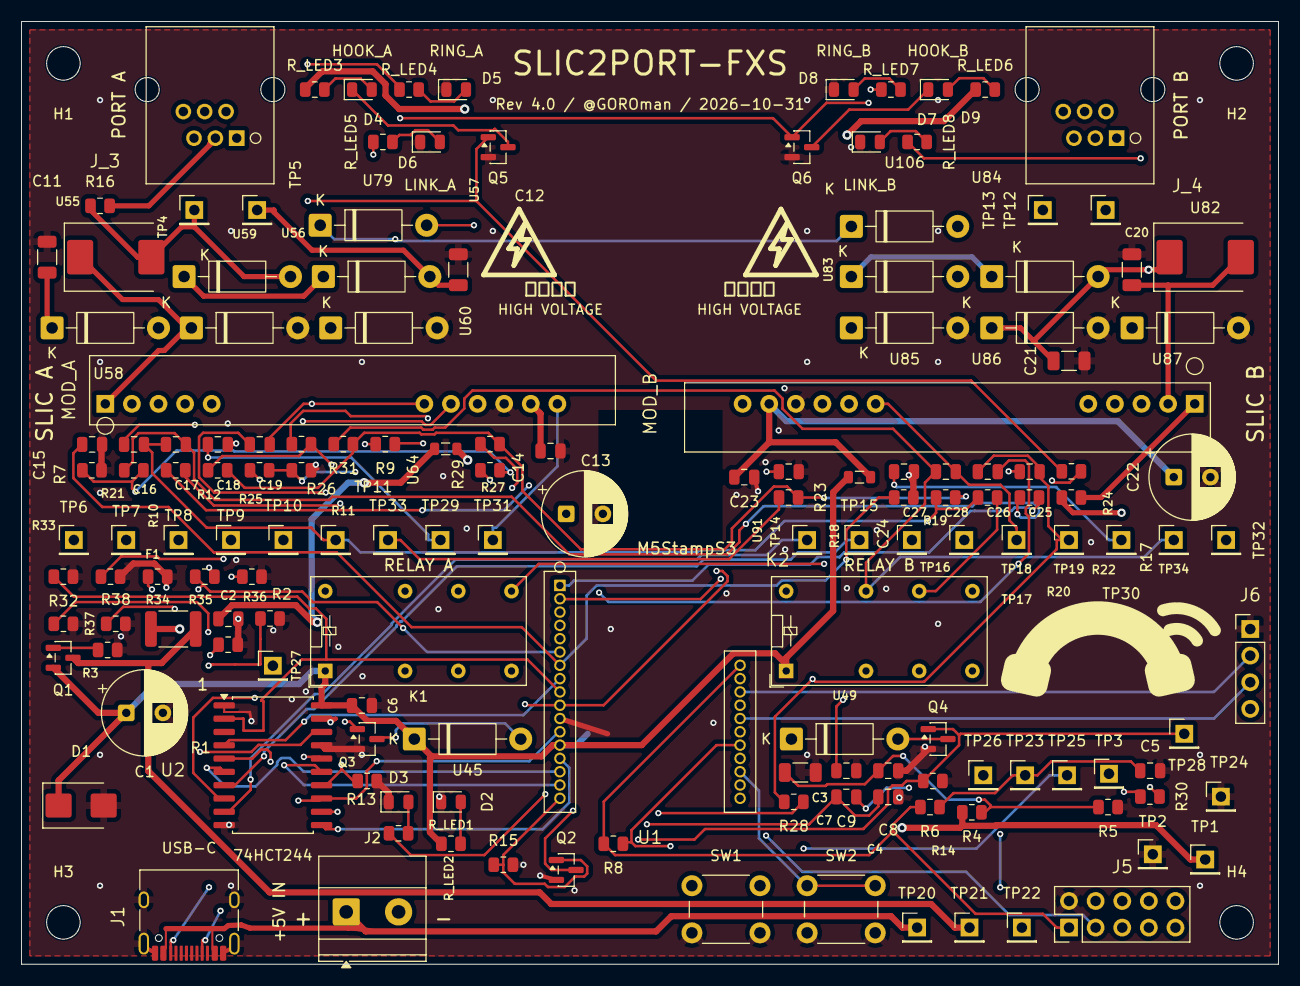
[picture p37: board SLIC2PORT-FXS.kicad_pcb from above]

Board: 4 copper layers, 120.0 x 90.0 mm, 160 parts (1 on the bottom side), 82 nets.

Parts:
C1: 1000uF/10V; CP_Radial_D8.0mm_P3.50mm
C2, C4, C5, C6, C9, C10, C14, C16, C17, C19, C23, C25, C26, C28: 100nF; C_0805_2012Metric
C3: 10uF; C_1206_3216Metric
C7, C8: 47nF; C_0805_2012Metric
C11, C12, C20, C21: 10nF; C_1206_3216Metric
C13, C22: 470uF/10V; CP_Radial_D8.0mm_P3.50mm
C15, C18, C24, C27: 1nF; C_0805_2012Metric
D1: SMBJ5.0A; D_SMB
D2: LED_RED; LED_0805_2012Metric
D3, D4, D7: LED_GRN; LED_0805_2012Metric
D5, D8: LED_YEL; LED_0805_2012Metric
D6, D9: LED_BLU; LED_0805_2012Metric
F1: Polyfuse_2A; Fuse_1812_4532Metric
H1, H2, H3, H4: MountingHole_3.2mm_M3
J1: USB-C_PWR; USB_C_Receptacle_HRO_TYPE-C-31-M-12
J2: DC5V_IN; TerminalBlock_Phoenix_MKDS-1,5-2_1x02_P5.00mm_Horizontal
J5: EXPANSION; PinHeader_2x05_P2.54mm_Vertical
J6: UART_DBG; PinHeader_1x04_P2.54mm_Vertical
J_3, J_4: RJ11_6P6C; RJ11_6P6C_TH
K1, K2: G5V-2_DC5; Relay_DPDT_Omron_G5V-2
MOD_A: KS0835F
MOD_B: KS0835F
Q1: AO3401A; SOT-23
Q2, Q3, Q4, Q5, Q6: 2N7002; SOT-23
R1, R2: 5.1K; R_0805_2012Metric
R3, R12, R13, R14, R15, R19, R21, R23, R27, R29, R31, R32, R33, R34, R35, R36, R37, R38: 100K; R_0805_2012Metric
R4, R5: 4.7K; R_0805_2012Metric
R6, R7, R11: 47K; R_0805_2012Metric
R8, R9, R10, R17, R22, R25, R30: 10K; R_0805_2012Metric
R16, R24: 27K; R_0805_2012Metric
R18, R26: 18K; R_0805_2012Metric
R20, R28: 0R; R_0805_2012Metric
R_LED1, R_LED5, R_LED8: 1K; R_0805_2012Metric
R_LED2: 470; R_0805_2012Metric
R_LED3, R_LED4, R_LED6, R_LED7: 1.5K; R_0805_2012Metric
SW1: RST; SW_PUSH_6mm
SW2: BOOT; SW_PUSH_6mm
TP1: +5V; PinHeader_1x01_P2.54mm_Vertical
TP2, TP24: GND; PinHeader_1x01_P2.54mm_Vertical
TP3: TONE_BUS; PinHeader_1x01_P2.54mm_Vertical
TP4: TIP_A; PinHeader_1x01_P2.54mm_Vertical
TP5: RING_A; PinHeader_1x01_P2.54mm_Vertical
TP6: FR_A_5V; PinHeader_1x01_P2.54mm_Vertical
TP7: RM_A_5V; PinHeader_1x01_P2.54mm_Vertical
TP8: SHK_A_RAW; PinHeader_1x01_P2.54mm_Vertical
TP9: VX_A_PIN; PinHeader_1x01_P2.54mm_Vertical
TP10: VR_A_PIN; PinHeader_1x01_P2.54mm_Vertical
TP11: VX_A_AUD; PinHeader_1x01_P2.54mm_Vertical
TP12: TIP_B; PinHeader_1x01_P2.54mm_Vertical
TP13: RING_B; PinHeader_1x01_P2.54mm_Vertical
TP14: FR_B_5V; PinHeader_1x01_P2.54mm_Vertical
TP15: RM_B_5V; PinHeader_1x01_P2.54mm_Vertical
TP16: SHK_B_RAW; PinHeader_1x01_P2.54mm_Vertical
TP17: VX_B_PIN; PinHeader_1x01_P2.54mm_Vertical
TP18: VR_B_PIN; PinHeader_1x01_P2.54mm_Vertical
TP19: VX_B_AUD; PinHeader_1x01_P2.54mm_Vertical
TP20: VIN_RAW; PinHeader_1x01_P2.54mm_Vertical
TP21: VIN_F; PinHeader_1x01_P2.54mm_Vertical
TP22: VAUD; PinHeader_1x01_P2.54mm_Vertical
TP23: VREF165; PinHeader_1x01_P2.54mm_Vertical
TP25: TONE_5V; PinHeader_1x01_P2.54mm_Vertical
TP26: TONE_AC; PinHeader_1x01_P2.54mm_Vertical
TP27: SEL_A_5V; PinHeader_1x01_P2.54mm_Vertical
TP28: SEL_B_5V; PinHeader_1x01_P2.54mm_Vertical
TP29: MON_A; PinHeader_1x01_P2.54mm_Vertical
TP30: MON_B; PinHeader_1x01_P2.54mm_Vertical
TP31: PD_A; PinHeader_1x01_P2.54mm_Vertical
TP32: PD_B; PinHeader_1x01_P2.54mm_Vertical
TP33: VR_A_IN; PinHeader_1x01_P2.54mm_Vertical
TP34: VR_B_IN; PinHeader_1x01_P2.54mm_Vertical
U1: M5StampS3/S3A; Stamp-S3-Socket
U2: 74HCT244; SOIC-20W_7.5x12.8mm_P1.27mm
U45, U49, U56, U57, U58, U59, U83, U84, U85, U86: 1N4007; D_DO-41_SOD81_P10.16mm_Horizontal
U55, U82: P3100SC; D_SMC
U60, U87: BZT03C82; D_DO-41_SOD81_P10.16mm_Horizontal
U64, U91: BK2125HS601-T; L_0805_2012Metric
U79, U106: 1N5819; D_DO-41_SOD81_P10.16mm_Horizontal

Connections:
+3V3: J5.1, J6.4, R6.1, R8.1, U1.28
+5V: C1.1, C2.1, C6.1, C10.1, D1.1, K1.1, K2.1, Q1.2, R4.1, R_LED1.1, TP1.1, U1.13, U2.20, U45.1, U49.1, U64.1, U91.1
+5V_PA: C13.1, C14.1, MOD_A.10, R_LED3.1, U64.2
+5V_PB: C22.1, C23.1, MOD_B.10, R_LED6.1, U91.2
BRP_A: U56.1, U57.1, U60.1
BRP_B: U83.1, U84.1, U87.1
EN: R8.2, SW1.1, U1.22
FR_A_5V: MOD_A.3, TP6.1, U2.18
FR_A_33: R32.1, U1.9, U2.2
FR_B_5V: MOD_B.3, TP14.1, U2.9
FR_B_33: R36.1, U1.14, U2.11
GND: C1.2, C2.2, C3.2, C4.2, C5.2, C6.2, C7.2, C8.2, C10.2, C11.2, C12.2, C13.2, C14.2, C15.2, C18.2, C20.2, C21.2, C22.2, C23.2, C24.2, C27.2, D1.2, D2.1, D3.1, D5.1, D6.1, D8.1, D9.1, J1.A1, J1.A12, J1.B1, J1.B12, J1.SH, J2.2, J5.2, J6.1, MOD_A.9, MOD_B.9, Q2.2, Q3.2, Q4.2, Q5.2, Q6.2, R1.2, R2.2, R3.2, R5.2, R7.2, R13.2, R14.2, R15.2, R18.2, R26.2, R32.2, R33.2, R34.2, R35.2, R36.2, R37.2, R38.2, SW1.2, SW2.2, TP2.1, TP24.1, U1.11, U1.18, U2.1, U2.10, U2.17, U2.19, U58.2, U59.2, U60.2, U85.2, U86.2, U87.2
GPIO0: SW2.1, U1.20
GPIO3: J5.10, U1.3
GPIO4: J5.3, R_LED2.1, U1.4
GPIO5: J5.4, U1.5
GPIO39: J5.5, U1.19
GPIO40: J5.6, U1.21
GPIO41: J5.7, U1.23
GPIO42: J5.8, U1.25
GPIO43: J6.2, U1.26
GPIO44: J6.3, U1.24
GPIO46: J5.9, U1.27
HK_A_DRV: D4.1, Q5.3
HK_B_DRV: D7.1, Q6.3
LED_HK_A: D4.2, R_LED3.2
LED_HK_B: D7.2, R_LED6.2
LED_LK_A: D6.2, R_LED5.2
LED_LK_B: D9.2, R_LED8.2
LED_PWR_A: D2.2, R_LED1.2
LED_RG_A: D5.2, R_LED4.2
LED_RG_B: D8.2, R_LED7.2
LED_ST_A: D3.2, R_LED2.2
MON_A: C18.1, R22.2, TP29.1, U1.1
MON_B: C27.1, R30.2, TP30.1, U1.2
unnamed: J1.A5, R1.1
unnamed: J1.B5, R2.1
PD_A: MOD_A.11, TP31.1, U79.2
PD_B: MOD_B.11, TP32.1, U106.2
PD_BUS: Q2.3, U79.1, U106.1
PD_EN: Q2.1, R15.1, U1.17
Q1_GATE: Q1.1, R3.1
RING_A: C12.1, J_3.3, MOD_A.1, R16.2, TP5.1, U55.1, U57.2, U59.1
RING_B: C21.1, J_4.3, MOD_B.1, R24.2, TP13.1, U82.1, U84.2, U86.1
RLY_A_COIL: K1.16, Q3.3, U45.2
RLY_B_COIL: K2.16, Q4.3, U49.2
RM_A_5V: MOD_A.4, R_LED4.1, TP7.1, U2.16
RM_A_33: R33.1, U1.8, U2.4
RM_B_5V: MOD_B.4, R_LED7.1, TP15.1, U2.7
RM_B_33: R37.1, U1.12, U2.13
SEL_A_5V: Q3.1, R13.1, R_LED5.1, TP27.1, U2.14
SEL_A_33: R34.1, U1.15, U2.6
SEL_B_5V: Q4.1, R14.1, R_LED8.1, TP28.1, U2.5
SEL_B_33: R38.1, U1.16, U2.15
SHK_A_33: C15.1, R17.2, R18.1, U1.7
SHK_A_RAW: MOD_A.5, Q5.1, R17.1, TP8.1
SHK_B_33: C24.1, R25.2, R26.1, U1.10
SHK_B_RAW: MOD_B.5, Q6.1, R25.1, TP16.1
TAP_A_N: C17.2, R21.1, R22.1
TAP_B_N: C26.2, R29.1, R30.1
TIP_A: C11.1, J_3.4, MOD_A.2, R16.1, TP4.1, U55.2, U56.2, U58.1
TIP_B: C20.1, J_4.4, MOD_B.2, R24.1, TP12.1, U82.2, U83.2, U85.1
TONE_5V: R9.1, TP25.1, U2.12
TONE_AC: C9.2, R11.1, TP26.1
TONE_BUS: K1.8, K1.9, K2.8, K2.9, R11.2, R12.1, TP3.1
TONE_N1: C7.1, R9.2, R10.1
TONE_N2: C8.1, C9.1, R10.2
TONE_PWM_33: R35.1, U1.6, U2.8
VAUD: C3.1, C4.1, R4.2, R5.1, R12.2, R19.2, R23.2, R27.2, R31.2, TP22.1
VIN_F: F1.2, Q1.3, TP21.1
VIN_RAW: F1.1, J1.A4, J1.A9, J1.B4, J1.B9, J2.1, TP20.1
VREF165: C5.1, R6.2, R7.1, R21.2, R29.2, TP23.1
VR_A_IN: C19.1, K1.4, K1.13, R23.1, TP33.1
VR_A_PIN: C19.2, MOD_A.6, TP10.1
VR_B_IN: C28.1, K2.4, K2.13, R31.1, TP34.1
VR_B_PIN: C28.2, MOD_B.6, TP18.1
VX_A_AUD: C16.2, C17.1, R19.1, R20.1, TP11.1
VX_A_IN: K2.6, K2.11, R20.2
VX_A_PIN: C16.1, MOD_A.7, TP9.1
VX_B_AUD: C25.2, C26.1, R27.1, R28.1, TP19.1
VX_B_IN: K1.6, K1.11, R28.2
VX_B_PIN: C25.1, MOD_B.7, TP17.1
