GOROman/m5stamp-slic-fxs/kicad/skidl/m5stamp_slic2port_lib_sklib.py

from skidl import Pin, Part, Alias, SchLib, SKIDL, TEMPLATE

SKIDL_lib_version = '0.0.1'

m5stamp_slic2port_lib = SchLib(tool=SKIDL).add_parts(*[
        Part(**{ 'name':'USB_C', 'dest':TEMPLATE, 'tool':SKIDL, '_name':'USB_C', '_match_pin_regex':False, 'description':'', '_aliases':Alias({'USB_C'}), 'value_str':'USB-C_PWR', 'ref_prefix':'U', 'num_units':None, 'fplist':None, 'do_erc':True, 'aliases':Alias({'USB_C'}), 'pin':None, 'footprint':'Connector_USB:USB_C_Receptacle_HRO_TYPE-C-31-M-12', 'pins':[
            Pin(num='A1',name='GND_A1',func=Pin.types.PASSIVE,do_erc=True),
            Pin(num='A12',name='GND_A12',func=Pin.types.PASSIVE,do_erc=True),
            Pin(num='B1',name='GND_B1',func=Pin.types.PASSIVE,do_erc=True),
            Pin(num='B12',name='GND_B12',func=Pin.types.PASSIVE,do_erc=True),
            Pin(num='A4',name='VBUS_A4',func=Pin.types.PASSIVE,do_erc=True),
            Pin(num='A9',name='VBUS_A9',func=Pin.types.PASSIVE,do_erc=True),
            Pin(num='B4',name='VBUS_B4',func=Pin.types.PASSIVE,do_erc=True),
            Pin(num='B9',name='VBUS_B9',func=Pin.types.PASSIVE,do_erc=True),
            Pin(num='A5',name='CC1',func=Pin.types.PASSIVE,do_erc=True),
            Pin(num='B5',name='CC2',func=Pin.types.PASSIVE,do_erc=True),
            Pin(num='A6',name='DP_A',func=Pin.types.PASSIVE,do_erc=True),
            Pin(num='B6',name='DP_B',func=Pin.types.PASSIVE,do_erc=True),
            Pin(num='A7',name='DN_A',func=Pin.types.PASSIVE,do_erc=True),
            Pin(num='B7',name='DN_B',func=Pin.types.PASSIVE,do_erc=True),
            Pin(num='A8',name='SBU1',func=Pin.types.PASSIVE,do_erc=True),
            Pin(num='B8',name='SBU2',func=Pin.types.PASSIVE,do_erc=True),
            Pin(num='S1',name='SHIELD',func=Pin.types.PASSIVE,do_erc=True)] }),
        Part(**{ 'name':'R', 'dest':TEMPLATE, 'tool':SKIDL, '_name':'R', '_match_pin_regex':False, 'description':'', '_aliases':Alias({'R'}), 'value_str':'5.1K', 'ref_prefix':'U', 'num_units':None, 'fplist':None, 'do_erc':True, 'aliases':Alias({'R'}), 'pin':None, 'footprint':'Resistor_SMD:R_0805_2012Metric', 'pins':[
            Pin(num=1,name='1',func=Pin.types.PASSIVE,do_erc=True),
            Pin(num=2,name='2',func=Pin.types.PASSIVE,do_erc=True)] }),
        Part(**{ 'name':'TB', 'dest':TEMPLATE, 'tool':SKIDL, '_name':'TB', '_match_pin_regex':False, 'description':'', '_aliases':Alias({'TB'}), 'value_str':'DC5V_IN', 'ref_prefix':'U', 'num_units':None, 'fplist':None, 'do_erc':True, 'aliases':Alias({'TB'}), 'pin':None, 'footprint':'TerminalBlock_Phoenix:TerminalBlock_Phoenix_MKDS-1,5-2_1x02_P5.00mm_Horizontal', 'pins':[
            Pin(num=1,name='+',func=Pin.types.PASSIVE,do_erc=True),
            Pin(num=2,name='-',func=Pin.types.PASSIVE,do_erc=True)] }),
        Part(**{ 'name':'F', 'dest':TEMPLATE, 'tool':SKIDL, '_name':'F', '_match_pin_regex':False, 'description':'', '_aliases':Alias({'F'}), 'value_str':'Polyfuse_2A', 'ref_prefix':'U', 'num_units':None, 'fplist':None, 'do_erc':True, 'aliases':Alias({'F'}), 'pin':None, 'footprint':'Fuse:Fuse_1812_4532Metric', 'pins':[
            Pin(num=1,name='1',func=Pin.types.PASSIVE,do_erc=True),
            Pin(num=2,name='2',func=Pin.types.PASSIVE,do_erc=True)] }),
        Part(**{ 'name':'Q', 'dest':TEMPLATE, 'tool':SKIDL, '_name':'Q', '_match_pin_regex':False, 'description':'', '_aliases':Alias({'Q'}), 'value_str':'AO3401A', 'ref_prefix':'U', 'num_units':None, 'fplist':None, 'do_erc':True, 'aliases':Alias({'Q'}), 'pin':None, 'footprint':'Package_TO_SOT_SMD:SOT-23', 'pins':[
            Pin(num=1,name='G',func=Pin.types.PASSIVE,do_erc=True),
            Pin(num=2,name='S',func=Pin.types.PASSIVE,do_erc=True),
            Pin(num=3,name='D',func=Pin.types.PASSIVE,do_erc=True)] }),
        Part(**{ 'name':'D', 'dest':TEMPLATE, 'tool':SKIDL, '_name':'D', '_match_pin_regex':False, 'description':'', '_aliases':Alias({'D'}), 'value_str':'SMBJ5.0A', 'ref_prefix':'U', 'num_units':None, 'fplist':None, 'do_erc':True, 'aliases':Alias({'D'}), 'pin':None, 'footprint':'Diode_SMD:D_SMB', 'pins':[
            Pin(num=1,name='K',func=Pin.types.PASSIVE,do_erc=True),
            Pin(num=2,name='A',func=Pin.types.PASSIVE,do_erc=True)] }),
        Part(**{ 'name':'C', 'dest':TEMPLATE, 'tool':SKIDL, '_name':'C', '_match_pin_regex':False, 'description':'', '_aliases':Alias({'C'}), 'value_str':'1000uF/10V', 'ref_prefix':'U', 'num_units':None, 'fplist':None, 'do_erc':True, 'aliases':Alias({'C'}), 'pin':None, 'footprint':'Capacitor_THT:CP_Radial_D8.0mm_P3.50mm', 'pins':[
            Pin(num=1,name='+',func=Pin.types.PASSIVE,do_erc=True),
            Pin(num=2,name='-',func=Pin.types.PASSIVE,do_erc=True)] }),
        Part(**{ 'name':'M5STAMPS3', 'dest':TEMPLATE, 'tool':SKIDL, '_name':'M5STAMPS3', '_match_pin_regex':False, 'description':'', '_aliases':Alias({'M5STAMPS3'}), 'value_str':'M5StampS3/S3A', 'ref_prefix':'U', 'num_units':None, 'fplist':None, 'do_erc':True, 'aliases':Alias({'M5STAMPS3'}), 'pin':None, 'footprint':'SLIC2PORT:Stamp-S3-Socket', 'pins':[
            Pin(num=1,name='G1',func=Pin.types.PASSIVE,do_erc=True),
            Pin(num=2,name='G2',func=Pin.types.PASSIVE,do_erc=True),
            Pin(num=3,name='G3',func=Pin.types.PASSIVE,do_erc=True),
            Pin(num=4,name='G4',func=Pin.types.PASSIVE,do_erc=True),
            Pin(num=5,name='G5',func=Pin.types.PASSIVE,do_erc=True),
            Pin(num=6,name='G6',func=Pin.types.PASSIVE,do_erc=True),
            Pin(num=7,name='G7',func=Pin.types.PASSIVE,do_erc=True),
            Pin(num=8,name='G8',func=Pin.types.PASSIVE,do_erc=True),
            Pin(num=9,name='G9',func=Pin.types.PASSIVE,do_erc=True),
            Pin(num=10,name='G10',func=Pin.types.PASSIVE,do_erc=True),
            Pin(num=11,name='GND',func=Pin.types.PASSIVE,do_erc=True),
            Pin(num=12,name='G11',func=Pin.types.PASSIVE,do_erc=True),
            Pin(num=13,name='5V',func=Pin.types.PASSIVE,do_erc=True),
            Pin(num=14,name='G12',func=Pin.types.PASSIVE,do_erc=True),
            Pin(num=15,name='G13',func=Pin.types.PASSIVE,do_erc=True),
            Pin(num=16,name='G14',func=Pin.types.PASSIVE,do_erc=True),
            Pin(num=17,name='G15',func=Pin.types.PASSIVE,do_erc=True),
            Pin(num=18,name='GND',func=Pin.types.PASSIVE,do_erc=True),
            Pin(num=19,name='G39',func=Pin.types.PASSIVE,do_erc=True),
            Pin(num=20,name='G0',func=Pin.types.PASSIVE,do_erc=True),
            Pin(num=21,name='G40',func=Pin.types.PASSIVE,do_erc=True),
            Pin(num=22,name='EN',func=Pin.types.PASSIVE,do_erc=True),
            Pin(num=23,name='G41',func=Pin.types.PASSIVE,do_erc=True),
            Pin(num=24,name='G44',func=Pin.types.PASSIVE,do_erc=True),
            Pin(num=25,name='G42',func=Pin.types.PASSIVE,do_erc=True),
            Pin(num=26,name='G43',func=Pin.types.PASSIVE,do_erc=True),
            Pin(num=27,name='G46',func=Pin.types.PASSIVE,do_erc=True),
            Pin(num=28,name='3V3',func=Pin.types.PASSIVE,do_erc=True)] }),
        Part(**{ 'name':'SW', 'dest':TEMPLATE, 'tool':SKIDL, '_name':'SW', '_match_pin_regex':False, 'description':'', '_aliases':Alias({'SW'}), 'value_str':'RST', 'ref_prefix':'U', 'num_units':None, 'fplist':None, 'do_erc':True, 'aliases':Alias({'SW'}), 'pin':None, 'footprint':'Button_Switch_THT:SW_PUSH_6mm', 'pins':[
            Pin(num=1,name='1',func=Pin.types.PASSIVE,do_erc=True),
            Pin(num=2,name='2',func=Pin.types.PASSIVE,do_erc=True)] }),
        Part(**{ 'name':'LED', 'dest':TEMPLATE, 'tool':SKIDL, '_name':'LED', '_match_pin_regex':False, 'description':'', '_aliases':Alias({'LED'}), 'value_str':'LED_GRN', 'ref_prefix':'U', 'num_units':None, 'fplist':None, 'do_erc':True, 'aliases':Alias({'LED'}), 'pin':None, 'footprint':'LED_SMD:LED_0805_2012Metric', 'pins':[
            Pin(num=1,name='K',func=Pin.types.PASSIVE,do_erc=True),
            Pin(num=2,name='A',func=Pin.types.PASSIVE,do_erc=True)] }),
        Part(**{ 'name':'HDR', 'dest':TEMPLATE, 'tool':SKIDL, '_name':'HDR', '_match_pin_regex':False, 'description':'', '_aliases':Alias({'HDR'}), 'value_str':'EXPANSION', 'ref_prefix':'U', 'num_units':None, 'fplist':None, 'do_erc':True, 'aliases':Alias({'HDR'}), 'pin':None, 'footprint':'Connector_PinHeader_2.54mm:PinHeader_2x05_P2.54mm_Vertical', 'pins':[
            Pin(num=1,name='1',func=Pin.types.PASSIVE,do_erc=True),
            Pin(num=2,name='2',func=Pin.types.PASSIVE,do_erc=True),
            Pin(num=3,name='3',func=Pin.types.PASSIVE,do_erc=True),
            Pin(num=4,name='4',func=Pin.types.PASSIVE,do_erc=True),
            Pin(num=5,name='5',func=Pin.types.PASSIVE,do_erc=True),
            Pin(num=6,name='6',func=Pin.types.PASSIVE,do_erc=True),
            Pin(num=7,name='7',func=Pin.types.PASSIVE,do_erc=True),
            Pin(num=8,name='8',func=Pin.types.PASSIVE,do_erc=True),
            Pin(num=9,name='9',func=Pin.types.PASSIVE,do_erc=True),
            Pin(num=10,name='10',func=Pin.types.PASSIVE,do_erc=True)] }),
        Part(**{ 'name':'TP', 'dest':TEMPLATE, 'tool':SKIDL, '_name':'TP', '_match_pin_regex':False, 'description':'', '_aliases':Alias({'TP'}), 'value_str':'TP', 'ref_prefix':'U', 'num_units':None, 'fplist':None, 'do_erc':True, 'aliases':Alias({'TP'}), 'pin':None, 'footprint':'Connector_PinHeader_2.54mm:PinHeader_1x01_P2.54mm_Vertical', 'pins':[
            Pin(num=1,name='1',func=Pin.types.PASSIVE,do_erc=True)] }),
        Part(**{ 'name':'74HCT244', 'dest':TEMPLATE, 'tool':SKIDL, '_name':'74HCT244', '_match_pin_regex':False, 'description':'', '_aliases':Alias({'74HCT244'}), 'value_str':'74HCT244', 'ref_prefix':'U', 'num_units':None, 'fplist':None, 'do_erc':True, 'aliases':Alias({'74HCT244'}), 'pin':None, 'footprint':'Package_SO:SOIC-20W_7.5x12.8mm_P1.27mm', 'pins':[
            Pin(num=1,name='1OE',func=Pin.types.PASSIVE,do_erc=True),
            Pin(num=2,name='1A1',func=Pin.types.PASSIVE,do_erc=True),
            Pin(num=3,name='2Y4',func=Pin.types.PASSIVE,do_erc=True),
            Pin(num=4,name='1A2',func=Pin.types.PASSIVE,do_erc=True),
            Pin(num=5,name='2Y3',func=Pin.types.PASSIVE,do_erc=True),
            Pin(num=6,name='1A3',func=Pin.types.PASSIVE,do_erc=True),
            Pin(num=7,name='2Y2',func=Pin.types.PASSIVE,do_erc=True),
            Pin(num=8,name='1A4',func=Pin.types.PASSIVE,do_erc=True),
            Pin(num=9,name='2Y1',func=Pin.types.PASSIVE,do_erc=True),
            Pin(num=10,name='GND',func=Pin.types.PASSIVE,do_erc=True),
            Pin(num=11,name='2A1',func=Pin.types.PASSIVE,do_erc=True),
            Pin(num=12,name='1Y4',func=Pin.types.PASSIVE,do_erc=True),
            Pin(num=13,name='2A2',func=Pin.types.PASSIVE,do_erc=True),
            Pin(num=14,name='1Y3',func=Pin.types.PASSIVE,do_erc=True),
            Pin(num=15,name='2A3',func=Pin.types.PASSIVE,do_erc=True),
            Pin(num=16,name='1Y2',func=Pin.types.PASSIVE,do_erc=True),
            Pin(num=17,name='2A4',func=Pin.types.PASSIVE,do_erc=True),
            Pin(num=18,name='1Y1',func=Pin.types.PASSIVE,do_erc=True),
            Pin(num=19,name='2OE',func=Pin.types.PASSIVE,do_erc=True),
            Pin(num=20,name='VCC',func=Pin.types.PASSIVE,do_erc=True)] }),
        Part(**{ 'name':'G5V-2', 'dest':TEMPLATE, 'tool':SKIDL, '_name':'G5V-2', '_match_pin_regex':False, 'description':'', '_aliases':Alias({'G5V-2'}), 'value_str':'G5V-2_DC5', 'ref_prefix':'U', 'num_units':None, 'fplist':None, 'do_erc':True, 'aliases':Alias({'G5V-2'}), 'pin':None, 'footprint':'Relay_THT:Relay_DPDT_Omron_G5V-2', 'pins':[
            Pin(num=1,name='COIL1',func=Pin.types.PASSIVE,do_erc=True),
            Pin(num=16,name='COIL2',func=Pin.types.PASSIVE,do_erc=True),
            Pin(num=4,name='COM1',func=Pin.types.PASSIVE,do_erc=True),
            Pin(num=6,name='NC1',func=Pin.types.PASSIVE,do_erc=True),
            Pin(num=8,name='NO1',func=Pin.types.PASSIVE,do_erc=True),
            Pin(num=13,name='COM2',func=Pin.types.PASSIVE,do_erc=True),
            Pin(num=11,name='NC2',func=Pin.types.PASSIVE,do_erc=True),
            Pin(num=9,name='NO2',func=Pin.types.PASSIVE,do_erc=True)] }),
        Part(**{ 'name':'KS0835F', 'dest':TEMPLATE, 'tool':SKIDL, '_name':'KS0835F', '_match_pin_regex':False, 'description':'', '_aliases':Alias({'KS0835F'}), 'value_str':'KS0835F', 'ref_prefix':'U', 'num_units':None, 'fplist':None, 'do_erc':True, 'aliases':Alias({'KS0835F'}), 'pin':None, 'footprint':'SLIC2PORT:KS0835F', 'pins':[
            Pin(num=1,name='RING',func=Pin.types.PASSIVE,do_erc=True),
            Pin(num=2,name='TIP',func=Pin.types.PASSIVE,do_erc=True),
            Pin(num=3,name='FR',func=Pin.types.PASSIVE,do_erc=True),
            Pin(num=4,name='RM',func=Pin.types.PASSIVE,do_erc=True),
            Pin(num=5,name='SHK',func=Pin.types.PASSIVE,do_erc=True),
            Pin(num=6,name='VR',func=Pin.types.PASSIVE,do_erc=True),
            Pin(num=7,name='VX',func=Pin.types.PASSIVE,do_erc=True),
            Pin(num=8,name='NC',func=Pin.types.PASSIVE,do_erc=True),
            Pin(num=9,name='GND',func=Pin.types.PASSIVE,do_erc=True),
            Pin(num=10,name='VDC',func=Pin.types.PASSIVE,do_erc=True),
            Pin(num=11,name='PD',func=Pin.types.PASSIVE,do_erc=True)] }),
        Part(**{ 'name':'RJ11_6P6C', 'dest':TEMPLATE, 'tool':SKIDL, '_name':'RJ11_6P6C', '_match_pin_regex':False, 'description':'', '_aliases':Alias({'RJ11_6P6C'}), 'value_str':'RJ11_6P6C', 'ref_prefix':'U', 'num_units':None, 'fplist':None, 'do_erc':True, 'aliases':Alias({'RJ11_6P6C'}), 'pin':None, 'footprint':'SLIC2PORT:RJ11_6P6C_TH', 'pins':[
            Pin(num=1,name='1',func=Pin.types.PASSIVE,do_erc=True),
            Pin(num=2,name='2',func=Pin.types.PASSIVE,do_erc=True),
            Pin(num=3,name='3',func=Pin.types.PASSIVE,do_erc=True),
            Pin(num=4,name='4',func=Pin.types.PASSIVE,do_erc=True),
            Pin(num=5,name='5',func=Pin.types.PASSIVE,do_erc=True),
            Pin(num=6,name='6',func=Pin.types.PASSIVE,do_erc=True)] }),
        Part(**{ 'name':'FB', 'dest':TEMPLATE, 'tool':SKIDL, '_name':'FB', '_match_pin_regex':False, 'description':'', '_aliases':Alias({'FB'}), 'value_str':'BK2125HS601-T', 'ref_prefix':'U', 'num_units':None, 'fplist':None, 'do_erc':True, 'aliases':Alias({'FB'}), 'pin':None, 'footprint':'Inductor_SMD:L_0805_2012Metric', 'pins':[
            Pin(num=1,name='1',func=Pin.types.PASSIVE,do_erc=True),
            Pin(num=2,name='2',func=Pin.types.PASSIVE,do_erc=True)] })])
