GOROman/m5stamp-slic-fxs/(commit log)

2026-10-31 SLIC2PORT-FXS design package v0.1: design doc, BOM, firmware sketch, SKiDL/KiCad data, datasheets (work in progress, not yet ordered)
    [bom.csv]
2026-10-31 Fix hardware pin mappings, ring shutdown, and exchange call lifecycle
    Add hardware connectivity and host firmware regression checks; document remaining manufacturing and hardware validation.
    [bom.csv]
2026-10-31 Import PR #2 uniques: platformio.ini, DESIGN corrections, setup() order, not-fixed list
    [m5stamp_fxs_exchange.ino]
2026-10-31 Add placed (unrouted) PCB regenerated from merged netlist
    - Placed board built by kicad/build_pcb_v2.py from the PR #1/#3 merged
    SKiDL netlist (106 parts / 76 nets); bundled .net verified identical
    to a fresh SKiDL regeneration, ERC clean.
    - Round-1 workarounds retired per design fixes: no diode pin swap
    (templates now 1=K/2=A), no RJ11 pad shrink (library pads 1.1mm oval),
    USB-C assigned by real pad names (shield SH -> GND).
    - New parts R31-R37 (HCT244 input pull-downs) placed between the SLIC
    modules; all round-1 placements reused (no ref renumbering).
    - Verified after reload: 0 pad/net mismatches, courtyard overlap set
    identical to round 1. Routing to be finished in EasyEDA.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
    [SLIC2PORT-FXS.kicad_pcb]
2026-10-31 Add board preview renders (v2 placed, unrouted) to README
    KiCad 3D renders of kicad/SLIC2PORT-FXS.kicad_pcb (top/bottom).
    Custom footprints (KS0835F, RJ11, Stamp) have no 3D models and
    render as pads/outlines only.
2026-10-31 Use Akihabara-sourced equivalents: 1N4007 (for 1N4004), BK2125HS601-T bead
    - 1N4004 -> 1N4007 (Akizuki code 100934; strict superset, same DO-41)
    - BLM21_600R -> BK2125HS601-T (Akizuki code 109506; 600ohm@100MHz, 2012 land)
    - Netlist/BOM regenerated with SKiDL (ERC 0 errors, nets unchanged)
    [bom.csv]
2026-10-31 Replace CD4053 audio mux with G5V-2 relay cross-connect
    - Speech path now switched by relay contacts, mirroring the Akizuki
    pseudo-exchange kit (transistor-driven relays): K1/K2 = Omron
    G5V-2 DC5 (DPDT), poles paralleled, NC = peer VX (fail-safe
    cross-connect at power-off), NO = TONE_BUS
    - Drivers: 2N7002 low-side (Q3/Q4) + 1N4007 flyback + 100K gate
    pulldown, driven from SEL_x_5V (HCT244). Firmware SEL semantics
    unchanged (L = peer VX, H = tone)
    - CD4053 Z-channel monitor (SEL_Z/J7/AUX_TP) removed; superseded by
    direct test points. TP3 reassigned to TONE_BUS
    - Netlist/BOM regenerated (ERC 0 errors). Auto-assigned refs for
    passives/diodes renumbered due to creation-order change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
    [bom.csv]
2026-10-31 Add 31 test points (34 total) and clarify U2 unused channel
    - TP4-TP34: per-port TIP/RING (HV warning), F/R, RM, SHK raw,
    VX pin/AUD, VR pin; power VIN_RAW, VIN_F, VAUD, VREF165, extra
    GND; TONE_5V, TONE_AC, SEL_x_5V, MON_x (ADC), PD_x, VR_x_IN
    (relay COM). All verified against the intended nets, ERC 0 errors
    - U2.3 investigation: pad 3 is the unused channel OUTPUT (2Y4),
    intentionally open; its input 2A4 (pin 17) is already tied to GND
    in the netlist. No design change needed; documented in SKiDL
    - BOM notes updated for 1N4007 / 2N7002 / G5V-2 / TP / bead
    [bom.csv]
2026-10-31 DESIGN v0.2: relay cross-connect rationale, TP table, board regen note
    - Sec 5.4 rewritten for G5V-2 relays: kit reference (Akizuki pseudo
    exchange drives its talk path with relays + transistor drivers),
    paralleled DPDT contacts, fail-safe NC=cross-connect default,
    coil budget 2x100mA, switching-time notes, Z-channel removal
    - Sec 5.6 added: full TP1-TP34 table with HV warning for TIP/RING
    - Sec 4.2/4.3/7 updated (relay coil row, 2N7002 driver row, BOM rows:
    K1/K2, Q3/Q4, TP x34, 1N4007 substitution note)
    - Header notes placed PCB v2 is stale and must be regenerated
    - Firmware header comment updated (logic unchanged)
    [m5stamp_fxs_exchange.ino]
2026-10-31 Socket-mount M5StampS3: new Stamp-S3-Socket footprint, SKiDL + netlist regen
    U1 is no longer soldered directly. New local footprint
    SLIC2PORT:Stamp-S3-Socket provides 1.27mm-pitch female pin-header
    positions (17P left / 11P right, 17.2mm row spacing) measured from the
    official M5Stack Stamp-S3-SMD footprint. Netlist regenerated from SKiDL
    (ERC clean); topology unchanged except the U1 footprint (anonymous U##
    refdes re-assigned by SKiDL as usual). Module underside GND pads 29-31
    are unconnected in socket configuration.
    [m5stamp_slic2port.py]
2026-10-31 BOM: U1 socket footprint + socket/header purchase note
    [bom.csv]
2026-10-31 Add placed (unrouted) PCB v3: relay design, 34 TPs, U1 socket, 120x90mm
    Regenerated from the current netlist (142 parts). G5V-2 relays placed
    next to the audio area with drivers/flyback diodes adjacent, all 34
    test points placed near their signals with net-name silk labels, U1 on
    the new Stamp-S3-Socket footprint with its courtyard kept empty.
    Verified by kicad/check_v3.py: pad-net mismatches NONE, courtyard
    overlaps 2 pairs (both inherited from v2; zero new pairs, down from
    17 in v2 / 38 in the first 120x80 attempt). Routing is done in EasyEDA.
    [SLIC2PORT-FXS.kicad_pcb]
2026-10-31 Add board preview renders (v3 placed, unrouted, socket + relays) to README
2026-10-31 Docs: CAD notes for v3 (socket footprint, 142 parts, verification results)
2026-10-31 Docs: repair CAD notes text damaged by shell backtick expansion
2026-10-31 Round 5 (v3.1): move decoupling caps next to their loads
    - C6 beside U2 (74HCT244) pin 20 VCC: centre-to-pad 17.0 -> 4.4mm
    - C23 (+5V_PB) above MOD_B pin 10: 13.7 -> 4.7mm
    - C14 (+5V_PA) under MOD_A pin 10: 14.0 -> 3.7mm
    - C10 (+5V) flipped to B.Cu under U1 socket pin 13: 69.5 -> 1.9mm
    (top side is hemmed in by U2/J2/board edge; single bottom part)
    - Bulk swap: C13 (+5V_PA) to port-A side next to K1, C22 (+5V_PB)
    under MOD_B: 35.9 -> 10.0mm from MOD_B pin 10
    - C3/C4/C5 verified clustered with VAUD/VREF dividers (4.7-10.4mm)
    - check_v31: pad-net mismatches NONE, layer-aware courtyard pairs
    identical to v3 (2 inherited pairs, no new), no other part moved
    [SLIC2PORT-FXS.kicad_pcb]
2026-10-31 README: board preview updated to v3.1 renders
2026-10-31 Docs: CAD status updated for v3.1 (decoupling placement round)
2026-10-31 Add hardware status LEDs D4-D9 (HOOK/RING/LINK per port)
    Six 0805 status LEDs for at-a-glance port state, no firmware change:
    - HOOK (green, D4/D7): SHK_x_RAW buffered by 2N7002 (Q5/Q6). SHK is
    spec-limited to 100uA max output (Ag1171, 3.3K internal pull-up),
    so it cannot drive an LED directly. Gate DC path is the existing
    SHK divider (10K/18K); path is +5V_Px -> R -> LED -> FET -> GND.
    - RING (yellow, D5/D8): RM_x_5V direct from the 74HCT244 output
    (+/-6mA rated) through 1.5K, about 2mA.
    - LINK (blue, D6/D9): SEL_x_5V (relay coil drive line) direct
    through 1K, about 2mA. Lights while the relay is energised
    (tone bus selected); cross-connected calls are SEL=L, so it is
    off duri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
2026-10-31 BOM + netlist JSON regenerated for status LEDs (156 parts)
    New rows: LED_YEL x2, LED_BLU x2, 1.5K x4; LED_GRN 1 -> 3,
    1K 1 -> 3, 2N7002 3 -> 5. Notes updated for the new roles.
    netlist_v32.json generated from the regenerated SKiDL netlist
    in the same format as netlist_v3.json.
    [bom.csv]
2026-10-31 Board v3.2: place status LEDs on the top-edge strip (156 parts)
    All 142 v3.1 placements keep their exact coordinates. The 14 new
    parts (D4-D9, R_LED3-R_LED8, Q5/Q6) go into the freescan-verified
    empty strip along the top edge, grouped per port next to its RJ11:
    row 1 = HOOK and RING resistor/LED pairs, row 2 = HOOK buffer FET
    and LINK pair, with HOOK_x / RING_x / LINK_x role silk labels.
    check_v32: 160 footprints (156 + 4 MH), pad-net mismatches NONE,
    courtyard overlap pairs unchanged vs v3.1 (2 inherited pairs,
    zero new), C10 still the only B.Cu part, TP labels intact.
    [SLIC2PORT-FXS.kicad_pcb]
2026-10-31 README: board preview updated to v3.2 renders
2026-10-31 Board v3.3: standard numbered net format so EasyEDA imports nets
    KiCad 10 pcbnew serializes pad nets name-only ((net "NAME"), no net
    table); EasyEDA KiCad importer drops them (Nets=None, 0 ratsnest).
    fix_net_format.py rewrites to classic numbered form: board-level
    (net N "NAME") declarations + numbered pad nets. Verified by pcbnew
    reload: 84 nets + net 0, pad assignments identical to netlist_v32.json.
    Also two DRC adjudications from the EasyEDA report:
    - J1 (USB-C): nudged 0.2 mm inward; pad-to-edge 0.13 -> 0.33 mm
    (EasyEDA rule 0.3 mm). Footprint is an edge-placement design
    (courtyard overhangs the edge by design); shell face now 1.45 mm
    inside the edge, no mating impact.
    - C10 (back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
    [SLIC2PORT-FXS.kicad_pcb]
2026-10-31 README: board preview updated to v3.3 renders
2026-10-31 Docs: CAD file list updated for v3.3 (numbered net format + converter)
2026-10-31 Fix #5: sync hook on ring-test stop to prevent false call to other port
    EX_RING_TEST stop path now confirms the target hook (same as the
    EX_RINGING ring-trip path) before toIdle(), so the exchange enters
    EX_WAIT_ONHOOK instead of EX_IDLE and the still-off-hook handset is
    not picked up as a fresh caller after the 15ms debounce.
    Adds loop()-driven regression tests for both directions: after a
    ring-test stop the other port RM must stay LOW for 6.5s+ (past
    DIAL_NODIGIT_MS), and hanging up returns to EX_IDLE.
    [exchange_test.cpp, m5stamp_fxs_exchange.ino]
2026-10-31 Fix #7: sliding-window DTMF so 40ms tones are phase-independent
    Replace the non-overlapping 205-sample scan (a 40ms tone split across
    two windows left one below threshold: 131/205 window phases missed)
    with a sliding window: Goertzel analysis every 64 samples (8ms hop)
    over the latest 205 samples (DtmfScanner ring buffer). A 40ms tone
    now always has 4+ consecutive windows with >=60% coverage, so the
    existing 2-consecutive-window confirmation works at any phase.
    Verified end-to-end at sample level in tests/dtmf_test.cpp (wired
    into CI): 40/70/100ms tones miss 0/205 phases at amplitude 0.20 and
    0.15 per component, all 16 digits at 40ms, 40ms/40ms sequences
    including repeated digits, and no fa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
    [dtmf_test.cpp, m5stamp_fxs_exchange.ino]
2026-10-31 Fix #6 (library): RJ11 footprint drill 0.9->0.75, pad 1.15x1.70 for 0.20mm annular ring
    Spec grounded in manufacturer drawings: this class of side-entry 6P6C
    jack uses 0.46mm round contact wire (JST MOD-J6 drawing; generic
    52-series drawings agree), and JST recommended PCB layout specifies
    6x dia 0.8 +/-0.05 holes. Drill 0.75 sits inside that band with
    0.29mm diametral clearance on the wire.
    At 1.27mm single-row pitch, JLCPCB 2-layer 1oz limits (annular ring
    abs min 0.18mm, min copper spacing 0.10mm - official capabilities
    page) cannot both reach the recommended 0.25mm ring; design point
    keeps >=0.02mm margin over both absolute limits:
    short-side ring = (1.15-0.75)/2 = 0.20mm
    pad gap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
    [gen_footprints.py, test_hardware.py]
2026-10-31 board: v3.4 - 第7ラウンド監査の是正 (J2/U2干渉解消, RJ11/ソケット環状銅箔拡大, PD 1N5819化, シルク全数再配置)
    [SLIC2PORT-FXS.kicad_pcb]
2026-10-31 sources: v3.4 同期 (RJ11/ソケットフットプリント拡大, SKiDL PD=1N5819, BOM 更新)
    [bom.csv]
2026-10-31 firmware: Issue #4 修正 (LEDC 2.x/3.x 互換シム, platform espressif32@7.0.1 固定, CI に実ビルド追加)
    [Arduino.h, m5stamp_fxs_exchange.ino]
2026-10-31 docs: v3.4 プレビューと CAD_REPORT 第7ラウンド (全数監査と是正記録)
2026-10-31 board: RJ11 パッドをライブラリ #6 修正に整合 (drill 0.75 / 環状 0.20mm) + 第7ラウンド補記
    [SLIC2PORT-FXS.kicad_pcb]
2026-10-31 netlist: PD ダイオード U79/U106 の値を 1N5819 に是正 (基板/BOM と同期)
    v3.4 同期 (e5a03df) で SKiDL ソースと BOM は PD=1N5819 に更新されたが、
    保存ネットリストだけ旧値 1N4007 のまま残っていた。基板 v3.4 の実値
    (U79/U106 = 1N5819) が正であり、test_bom_matches_netlist の不整合の
    片側はこれだった。接続 (ピン-ネット) には変更なし。
2026-10-31 skidl: DIO/BEAD 18部品の ref を基板 v3.4 の番号に明示固定
    DIO()/BEAD() は SKiDL 自動採番に任せていたため、部品生成順序の変化で
    保存ネットリスト (= 基板 v3.4 のシルク番号) と U 番号がドリフトしていた
    (還流・保護ブリッジ・ツェナー・ビード・PD の計18部品)。
    基板側が正のため、ソース側の各生成箇所に基板番号を ref として固定。
    これで再生成ネットリストは保存ネットリストと部品・接続とも完全一致し、
    test_generated_connectivity_matches_source が通るようになる。
    今後部品を追加・削除しても自動採番の順序変動でドリフ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
2026-10-31 test: 実在しない J7 の検証を削除し test_reset_pulldowns に改名
    J7 (SEL_Z ロジックジャンパ) は CD4053 -> G5V-2 リレー化 (1eb012c) で
    Z チャネルとともに設計から意図的に削除された部品で、基板・ネットリスト・
    BOM のいずれにも存在しない。テスト側の古い前提が残っていたのが
    test_reset_pulldowns_and_logic_jumper の ERROR の原因。
    100K プルダウンの検証内容は一切変更していない (弱体化なし)。
    [test_hardware.py]
2026-10-31 fix #13: 配置JSONを保存ネットリストに同期し再生成手順と回帰検査を追加
    - kicad/net2json.py を正式な生成元として取り込み (従来は作業フォルダのみ)
    - netlist_v32.json を再生成: U79/U106 が 1N4007 のままだった PD ダイオードを
    1N5819 へ是正。他の全値・フットプリント・ネット所属は差分ゼロを確認
    - tests: test_placement_json_matches_netlist を追加し、JSON と保存
    ネットリストの値・フットプリント・ネットを恒常的に照合する
    [net2json.py, test_hardware.py]
2026-10-31 fix #11: U1ソケット寸法仕様を生成元に明記し PTH 全数環状銅箔検査を追加
    - 実測: ライブラリ Stamp-S3-Socket と基板 U1 は e5a03df で是正済みで
    両者とも パッド 1.1x1.1 / ドリル 0.7 (環状 0.20mm)、ピッチ 1.27mm、
    列間 17.2mm で一致していた。生成元への記録が無かったのが残件だった
    - gen_footprints.py にソケット寸法仕様 (対象ヘッダのテール寸法から
    ドリル 0.7 を採る根拠、推奨 0.25mm が銅間隔 0.10mm と両立しない
    ため絶対最小 +0.02mm を設計点とする判断) を RJ11 仕様と並べて明記
    - tests: 基板全 PTH 174 パッド + ライブラリ 28 パ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
    [gen_footprints.py, test_hardware.py]
2026-10-31 routed v3.4 (EasyEDA): Gerber一式・epro2元データ・配線済みレンダリング(表/裏/3D)を追加
2026-10-31 fix #9 (protection): BRM 浮遊レールを廃止しメーカー図の GND 基準クランプへ是正
    Ag1171 Fig.4 / KS0835F Typical Connection の実図を再読: ブリッジ -側
    ダイオードのアノードとツェナのアノードは GND 行きが正。従来は BRM_x
    レールが GND 無接続で浮いており、対 GND クランプが効かなかった。
    U58/U59/U60/U85/U86/U87 の pin2 を BRM_x -> GND へ変更し BRM ネットを
    削除 (SKiDL -> netlist -> 配置JSON まで再生成して同期)。
    再生成は SKiDL 3.0.0 + run_regen.py (リポジトリに追加) で実施し、
    保存 .net との意味差分が当該6ピンのみであることを検証済み。
    [m5stamp_slic2port.py, m5stamp_slic2port_lib_sklib.py, run_regen.py]
2026-10-31 fix #12: 配置修正を生成スクリプトへ同期し再生成=同梱の自動照合を追加
    build_pcb_v32.py が旧チェックアウトと作業ディレクトリを参照していた
    問題をリポジトリ相対パスへ是正。v3.4 の配置修正 (J1 84.9 / J2 85.0 /
    U2 -5.5 / K1 -1.2 / C6 -4.7 / C10 43.65) と SW2 の v3.4.1 移動 (+1.8mm)
    を反映。kicad/check_regen.py を追加し、一時出力への再生成と同梱基板の
    全配置・全パッドネット・値・RJ11/U1 パッド形状の一致を自動検証
    (結果: エラー0/警告0)。
    あわせて RJ11 パッド幅 1.15 -> 1.13mm (Issue #9/#6: 間隔 0.12mm は
    JLCPCB 最小間隔 0.127mm を僅かに下回る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
    [build_pcb_v32.py, check_regen.py, gen_footprints.py]
2026-10-31 board v3.4.1: SW2 移動・保護ネット是正・RJ11 パッド縮小 (Issue #9)
    v3.4 からの差分はこの3点のみ (全配置・全パッドネットを機械比較済み):
    1. SW2 を +1.8mm (X) へ移動: SW1 pin1 (EN) と SW2 pin1 (GPIO0) の
    Ø2.0 パッドが中心間 2.0mm で接触 (間隔 0mm) していた問題を解消し
    間隔 1.8mm を確保。EasyEDA DRC でも 0mil 接触として検出されていた。
    2. 保護回路: U58/U59/U60/U85/U86/U87 pin2 を BRM_x -> GND (メーカー図
    の GND 基準クランプに一致。生成元 SKiDL と同期済み)。
    3. RJ11 (J_3/J_4) パッド幅 1.15 -> 1.13mm: 間隔 0.14mm (JLC 最小
    0.127 以上) / 環状銅箔 0.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
    [SLIC2PORT-FXS.kicad_pcb]
2026-10-31 fix #9: ネットクラスを .kicad_pro へ永続化し HV 間隔方針を実測で再定義
    - SLIC2PORT-FXS.kicad_pro の net_settings が空だった問題を是正:
    Default / HV (clearance 0.5) / Power (0.6mm配線) と netclass_patterns
    (TIP/RING/BRP -> HV、+5V/VIN/GND -> Power) を保存。pcbnew で
    TIP_A=HV / +5V=Power の解決を実証。
    - DESIGN 9.2: 1.5mm 一律ルールを対象別に再定義。無関係ネット間は
    実測最小 1.655mm で 1.5mm 達成、保護系内部は実測最小 1.35mm を例外
    許容 (IPC-2221 被覆外層 170V以下 最小 0.6mm の 2 倍超)。
    旧記述の対 GND ±120V / -113V ピーク前提もメーカー回路に合わせ訂正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
2026-10-31 test #9: 保護回路の GND 基準化と RJ11 製造性 (間隔/環状) の回帰検査を追加
2026-10-31 docs: CAD_REPORT に第8ラウンド (Issue #9/#11/#12/#13 -> v3.4.1) を記録
2026-10-31 docs: README を現状に全面書き直し (v3.4 配線完了・配線済み画像・部品の必須/任意表・必要パーツ・ファームウェア/ケース現行化)
2026-10-31 enclosure: OpenSCAD 設計ソースと設計 README を追加 (基板 v3.4/v3.4.1 実寸ベース、寸法根拠・高さ予算・印刷ガイド)
    [enclosure.scad]
2026-10-31 enclosure: STL を追加 (ベース/蓋/ボタン押し子、バイナリ形式)
    [slic2port-base.stl, slic2port-lid.stl, slic2port-plungers.stl]
2026-10-31 enclosure: プレビューレンダー 7 点を追加
2026-10-31 audit round 9: コンデンサ×IC 実ボディ全数再検証 (C13缶がU2パッド1/2を覆う件の是正案を含む)
2026-10-31 design/logo: ロゴ3案のSVGソースと生成スクリプトを追加
    - 案A JACK & WAVE (RJ11正面+信号波形)
    - 案B HANDSET RING (受話器+呼び出し波紋)
    - 案C TWO PORTS / S-LINK (2ポート+S字波形)
    - 全案単色ベクターのみ (シルク白1色/ケース刻印対応)、形状は gen_logo.py で数値生成
    - ワードマーク併記版 (案A+SLIC2PORT-FXS) と3案比較シートのSVGも含む
2026-10-31 design/logo: PNGプレビューを追加 (各案 黒地/白地、ワードマーク、3案比較シート)
2026-10-31 design/logo: 選定メモを追加 (3案の説明・推奨案Aと理由・使用ガイド)
2026-10-31 enclosure: 基板依存寸法を BOARD INTERFACE セクションへ集約 (v4.0 適合準備、形状は不変を再生成で検証済み)
    [enclosure.scad]
2026-10-31 enclosure: デザイン改訂 (蓋ベベル/千鳥グリル/ベースのグルーブ+台座テーパー/高圧バッジ刻印/Rev 4.0 表記)
    [enclosure.scad]
2026-10-31 enclosure: デザイン改訂版 STL を再生成 (体積 ベース42.6/蓋27.0/押し子1.3 cm3)
    [slic2port-base.stl, slic2port-lid.stl, slic2port-plungers.stl]
2026-10-31 enclosure: デザイン改訂版レンダーを更新
2026-10-31 docs: RJ11 ジャックを秋月電子 100954 (Neltron 7002-6P6C) に正式決定
    秋月商品ページ掲載の Neltron 公式図面 (7002-XPXC) を research/ に同梱し、
    指定部品として DESIGN §5.1 と bom.csv に記録。図面の実寸は従来前提
    (単列 1.27mm ピッチ) と異なる千鳥2列 (1.02mm/列間 2.54mm、穴 ø0.90、
    ペグ ø2.30x2) であり、フットプリント是正と基板 v3.4.2 は次コミット以降。
2026-10-31 docs: 秋月 100954 指定を DESIGN §5.1 / 部品表へ記録 (RJ11 v3.4.2 根拠)
    [bom.csv]
2026-10-31 footprint: RJ11_6P6C_TH を Neltron 7002 実寸へ是正 (v3.4.2)
    秋月 100954 のメーカー図面に合わせ、単列 1.27mm ピッチ前提を廃止:
    - 千鳥2列: 接点ピッチ 1.02 / 列間隔 2.54、開口面から近列 8.10 / 遠列 10.64
    - 穴 ø0.90 (図面推奨)、パッド ø1.50 => 環状銅箔 0.30mm (最小 0.18 を充足)
    - 同列間隔 0.54mm / 列間斜め 1.24mm (最小 0.127 を充足)
    - 位置決めペグ穴 NPTH ø2.30 x2 (ピッチ 12.00)、本体シルク 12.20x15.00
    - pin1 は図面下面図の指示により遠列・右端 (+x)
    原点はペグ中心線に変更 (基板配置は次コミットで追随)。
2026-10-31 board v3.4.2: RJ11 を Neltron 7002 実寸へ是正し保護部品9点を移設
    - J_3/J_4: フットプリントを千鳥2列+ペグ穴へ差し替え、原点 (ペグ中心線)
    を y 7.2 -> 6.45 へ (開口面は基板端から 0.45mm を維持、本体奥行 15.0)
    - 本体が 1.5mm 深くなり旧保護1列目と干渉するため、干渉する保護部品
    9点を純粋平行移動で退避 (U56/U84/U85 は2列目へ、C11/C12/R16/C20 は
    列間の空き帯へ、C21/R24 は2列目の下へ)。生成元 build_pcb_v32.py に
    round 9 として同期し check_regen は警告0/エラー0
    - ネット・未接続数 (295) は不変、物理干渉 (Fab/パッド) 0件を確認。
    コー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
    [SLIC2PORT-FXS-v3.4.2.kicad_pcb, SLIC2PORT-FXS.kicad_pcb]
2026-10-31 test: RJ11 テストを Neltron 7002 千鳥仕様へ更新 (v3.4.2)
    旧 Issue #6 の単列 1.27mm 前提テスト3件を、メーカー図面の実寸検証へ:
    - パッド座標そのものを図面値 (近列 y=2.10 / 遠列 y=4.64、ピッチ 1.02) で照合
    - 2D パッド間隔 >= 0.127 (設計最小 0.54)、環状銅箔 >= 0.18 (実 0.30)
    - ドリルは図面推奨 ø0.90 に固定、ペグ穴 NPTH ø2.30 x2 @ ±6.00 も検証
    unittest 12件 + C++ テスト (exchange/dtmf/core3) 全パス。
    [test_hardware.py]
2026-10-31 board v3.4.2: 第9ラウンド処方 (C13 -1.0mm) を適用し第10ラウンドとして記録
    - C13 を X -1.00mm へ移動 (生成元にも同期、check_regen 0/0 維持)。
    U2 パッド1/2 との干渉 -0.474/-0.124mm -> +0.521/+0.799mm を実測で再現
    - RJ11 是正ラウンドは監査側の第9ラウンド (コンデンサ監査) と重なるため
    第10ラウンドとして CAD_REPORT に記録し、生成元の表記も round 10 に整合
    - README_CAD の RJ11 項を想定寸法から指定部品の実寸仕様へ更新
    [SLIC2PORT-FXS-v3.4.2.kicad_pcb, SLIC2PORT-FXS.kicad_pcb]
2026-10-31 board v4.0 (1/5): full re-layout — placement + silk, 4-layer, unrouted
    - 起点は v3.4.2 (RJ11 Neltron 7002 是正・C13 パッド干渉処方を含む)
    - 全160点を機能ブロックで再配置: RJ11×2 を上端に対称配置、保護ダイオード
    バンク (DO-41×6+SMC)は3バンド整列、SLIC は自ポート直下、リレー対は同方向
    一直線+駆動回路対称、U1 中央、LED は上端、TP は列配置
    - 4層化: L1 信号 / L2 GND プレーン (In1.Cu=power) / L3 電源+信号 / L4 信号
    - 大型部品は本体だけでなく隣接パッドに対しても >=0.3mm を実測検証
    (全点 >=+0.475mm、C10 裏面 vs ソケットピン +1.6mm)
    - シルク: タ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
    [SLIC2PORT-FXS.kicad_pcb]
2026-10-31 board v4.0 (2/5): routed — 4-layer (In1 GND plane), FreeRouting + hand-finished escapes
    - FreeRouting pass with netclasses restored in DSN (HV 0.5/0.5, Power 0.6/0.25)
    - Hand work: J1 USB-C escape (CC re-route on B.Cu, VIN_RAW feed, GND tab bridges),
    FR_A_33 south-loop reroute to free U2.1 GND pocket, 12+1 stitch vias,
    GND pockets U2.1/U2.19/R26.2 rescued
    - KiCad DRC: unconnected 0, shorts 0; clearance violations are U1 socket-intrinsic only
    - Pad-net map identical to v3.4.2 baseline (398 pads verified)
    - fix_net_tracks.py: KiCad 10.0.6 parser compatibility for numbered nets
    (tracks code-only, zones name-only — combined form rejected in tracks/zones)
    [SLIC2PORT-FXS.kicad_pcb]
2026-10-31 board v4.0 (3/5): silk cleanup — DRC silk items resolved to adjudicated groups only
    Silk pass on the routed board: reference/K texts repositioned (solver + hand fixes) until the only remaining silk DRC items are the two adjudicated footprint-intrinsic groups (C22 silk outline vs elevated SLIC module outline; RJ11 NPTH vs own silk). HV warning texts on B.Cu shrunk to fit the new layout. Final DRC: 0 unconnected, 191 violations all in adjudicated categories (104 = U1 socket-intrinsic pad spacing). Pad-net map identical to v3.4.2 (398 pads verified).
    [SLIC2PORT-FXS.kicad_pcb]
2026-10-31 board v4.0 (4/5): manufacturing outputs — KiCad gerbers (4-layer) + renders
    Gerber set exported from the KiCad v4.0 board (F/In1/In2/B copper, mask, paste, silk, edge cuts, drill, job file) as individual files and SLIC2PORT-FXS-v4.0-gerber-kicad.zip. Renders: top/bottom/3D plus four quadrant crops in docs/images (board-v40-routed-*.png, board-v40-crop-q*.png), visually inspected: no part or silk collisions remain outside the adjudicated footprint-intrinsic groups.
    [SLIC2PORT-FXS-B_Cu.gbl, SLIC2PORT-FXS-B_Mask.gbs, SLIC2PORT-FXS-B_Paste.gbp, SLIC2PORT-FXS-B_Silkscreen.gbo, SLIC2PORT-FXS-Edge_Cuts.gm1, SLIC2PORT-FXS-F_Cu.gtl, SLIC2PORT-FXS-F_Mask.gts, SLIC2PORT-FXS-F_Paste.gtp]
2026-10-31 board v4.0 (5/5): docs — README preview/status to v4.0, CAD_REPORT round 11, BOM C1 note
    README: status and preview now describe v4.0 (4-layer, KiCad routed, renders swapped to board-v40-routed-*.png), solder mask recommendation = matte black (choose at order time), layout table and pre-order checklist updated (enclosure openings no longer match v4.0 connector positions). CAD_REPORT: round 11 records the v4.0 floorplan policy, 4-layer rationale, large-part pad-based clearance audit (all >= +0.475mm, answering round 9), routing iteration numbers (50 unconnected/426 violations -> 0/0 shorts), HV spacing audit, silk design incl. title block and HV warning marks, final DRC breakdown with adjud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
    [bom.csv]
2026-10-31 board v4.0 fix: GND zone clearance 0.5mm — HV netclass compliance under project-context DRC
    Project-context DRC (kicad-cli inside the project, netclasses loaded) exposed 158 real violations the standalone checks could not see: HV (TIP/RING) copper vs GND pours/plane at 0.3005mm vs the HV class 0.500mm, because the GND zones were filled with 0.3mm local clearance. Fix: zone local clearance 0.3 -> 0.5mm on all three GND zones + refill; the wider carve severed six GND pour necks, reconnected with 3 stitching vias and 4 bridge tracks (connectivity analysis: all 81 GND pads back in one cluster). Final project-context DRC: 0 unconnected, 0 shorts, 216 violations, all adjudicated (104 U1 socket-i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
    [SLIC2PORT-FXS-B_Cu.gbl, SLIC2PORT-FXS-B_Mask.gbs, SLIC2PORT-FXS-B_Paste.gbp, SLIC2PORT-FXS-B_Silkscreen.gbo, SLIC2PORT-FXS-Edge_Cuts.gm1, SLIC2PORT-FXS-F_Cu.gtl, SLIC2PORT-FXS-F_Mask.gts, SLIC2PORT-FXS-F_Paste.gtp]
2026-10-31 design/logo: ユーザー選定を記録 (2026-10-31, 案B HANDSET RING)
2026-10-31 board v4.0: シルクロゴを案B (HANDSET RING) に差し替え
    仮置き枠+LOGOテキストを削除し、design/logo/logo-b.svg と同一形状の
    シルク図形 (gr_poly x2, union済み) を配置。幅21mm・中心(104,59.9)。
    上下の R20/TP30 リファレンス文字との干渉を避けるため仮置き枠より
    僅かに縮小+下方配置。DRC (プロジェクト文脈) はベースライン 216件と
    カテゴリ別件数まで完全一致し、新規シルク違反なし。
    [SLIC2PORT-FXS.kicad_pcb]
2026-10-31 board v4.0: ロゴB版の製造データを再出力 (gerber + レンダリング)
    F_Silkscreen に案Bロゴを反映した gerber 一式と zip を再生成
    (他レイヤの差分はヘッダ日時のみ)。レンダリング (top/bottom/3d と
    象限クロップ q1-q4) もロゴB版に差し替え。README プレビューは
    同ファイル名のため自動でロゴB版になる。
    [SLIC2PORT-FXS-B_Cu.gbl, SLIC2PORT-FXS-B_Mask.gbs, SLIC2PORT-FXS-B_Paste.gbp, SLIC2PORT-FXS-B_Silkscreen.gbo, SLIC2PORT-FXS-Edge_Cuts.gm1, SLIC2PORT-FXS-F_Cu.gtl, SLIC2PORT-FXS-F_Mask.gts, SLIC2PORT-FXS-F_Paste.gtp]
2026-10-31 enclosure: 蓋に選定ロゴ (案B) の浮き出しを追加
    製品名 SLIC2PORT-FXS の東側 (中心 (79,63)、幅16mm) に logo-b.svg と
    同一形状のポリゴンを 0.6mm 浮き出しで配置。製品名との接触を避けるため
    刻印ガイド下限 (15mm) を満たす範囲で 16mm に設定。蓋 STL を再生成
    (体積 27.03 cm3、従来 27.0 からロゴ分のみ増加) し、レンダー5点
    (lid / assembly-iso / assembly-north / assembly-south / open) を更新。
    ベース・押し子の STL は変更なし。
    [enclosure.scad, slic2port-lid.stl]
